lime7git/rc-piper-transmitter/Images/schematic/ffc-40pin.png

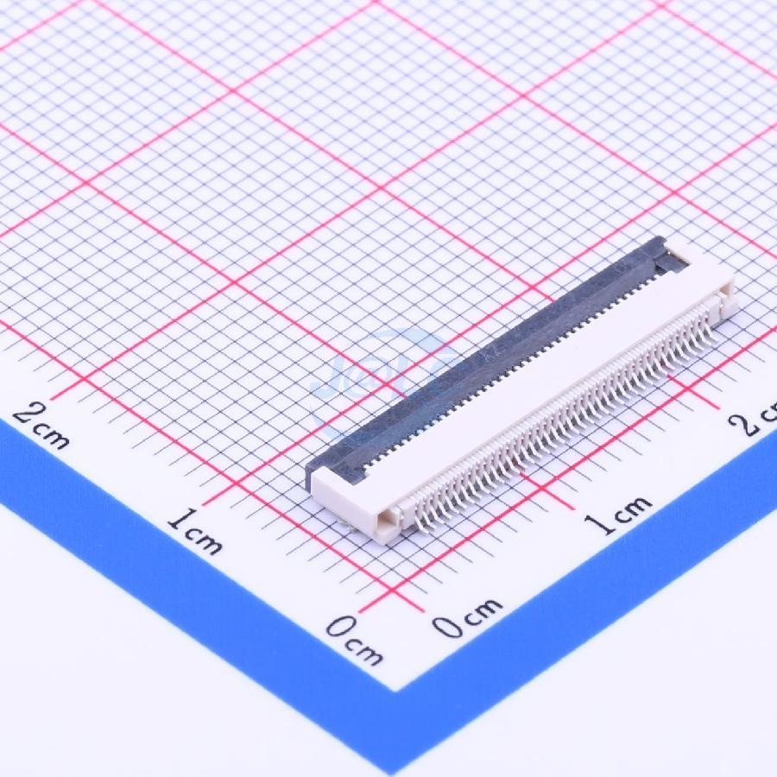
Images/schematic/ffc-40pin.png
