lime7git/rc-piper-transmitter/Images/schematic/toggle_sw1.jpeg

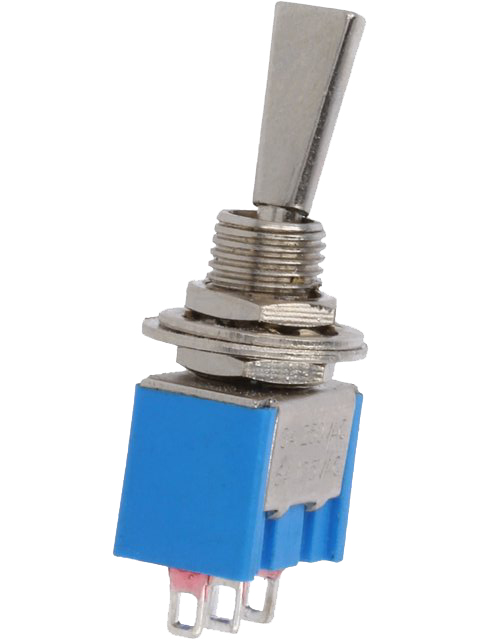
Images/schematic/toggle_sw1.jpeg
