lime7git/rc-piper-transmitter/Images/schematic/B3B-PH-K-S.jpg

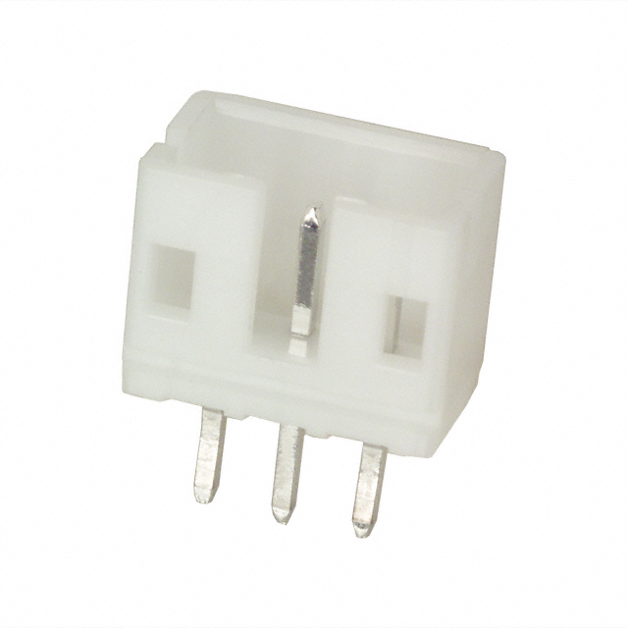
Images/schematic/B3B-PH-K-S.jpg
