lime7git/rc-piper-transmitter/Images/schematic/button1.jpg

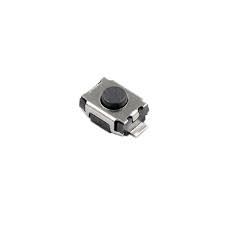
Images/schematic/button1.jpg
