lime7git/rc-piper-transmitter/Images/schematic/button2.jpg

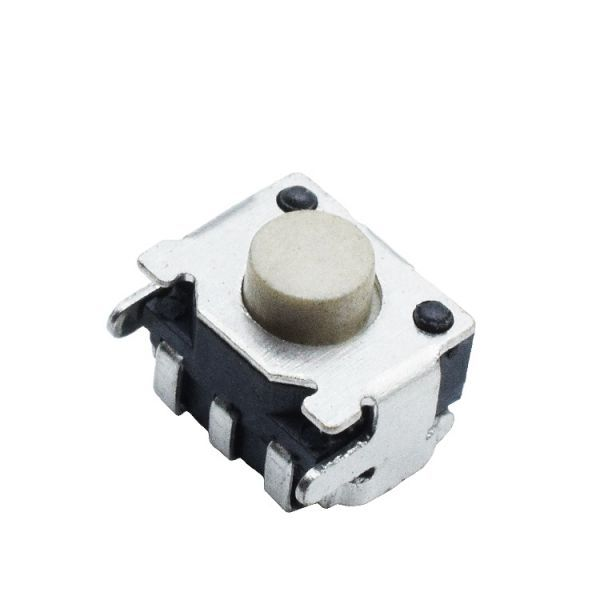
Images/schematic/button2.jpg
