lime7git/rc-piper-transmitter/Images/schematic/ffc-10pin.jpg

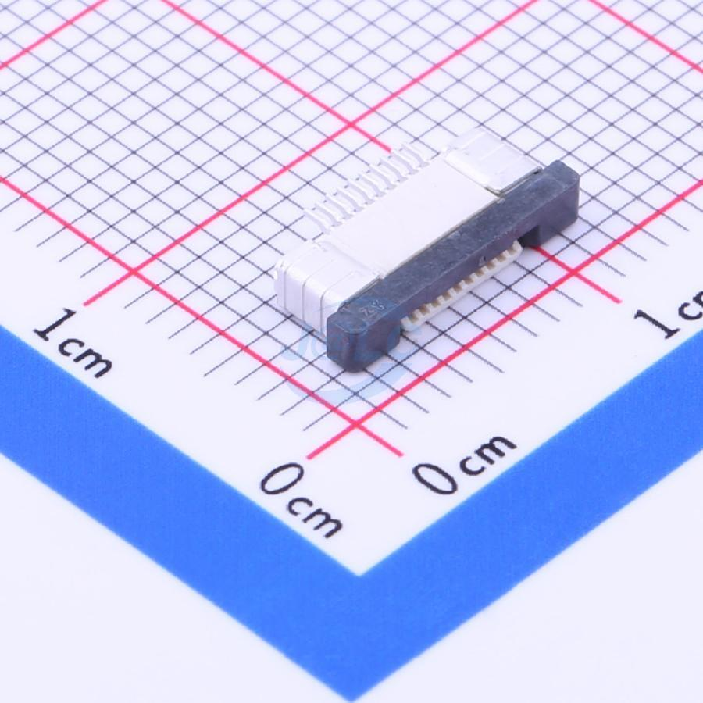
Images/schematic/ffc-10pin.jpg
