lime7git/rc-piper-transmitter/Images/schematic/joystick.jpg

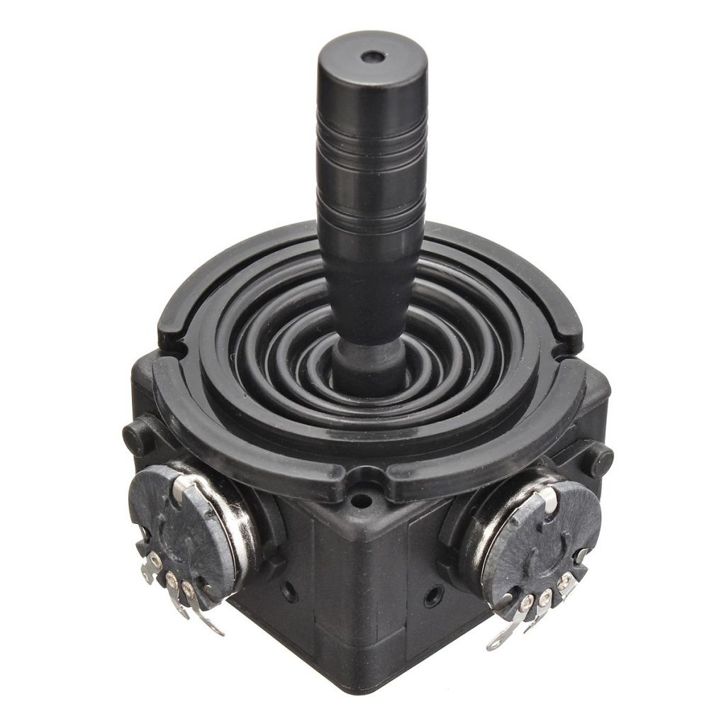
Images/schematic/joystick.jpg
