lime7git/rc-piper-transmitter/Images/schematic/li-pol-1cell.png

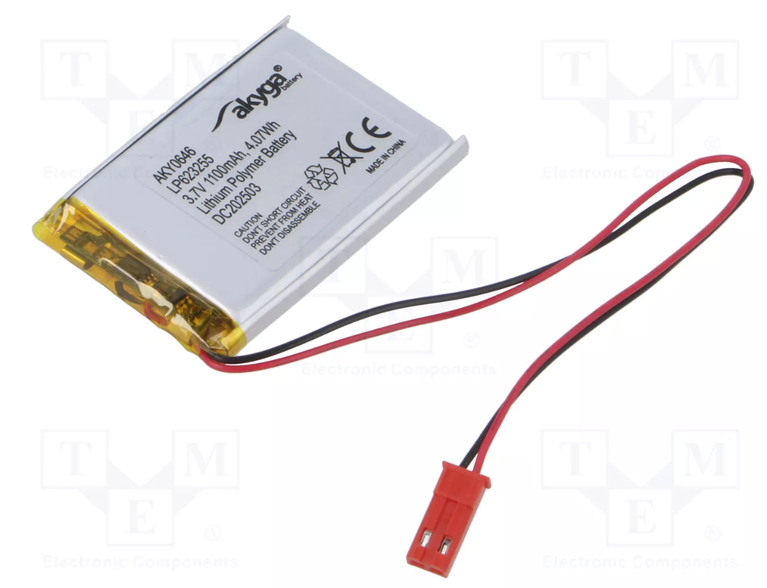
Images/schematic/li-pol-1cell.png
