lime7git/rc-piper-transmitter/Images/schematic/radio-transceiver.png

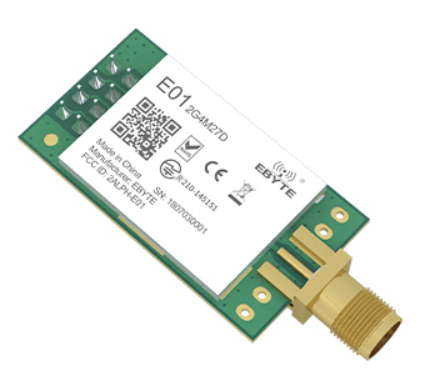
Images/schematic/radio-transceiver.png
