lime7git/rc-piper-transmitter/Images/schematic/sdcard.jpg

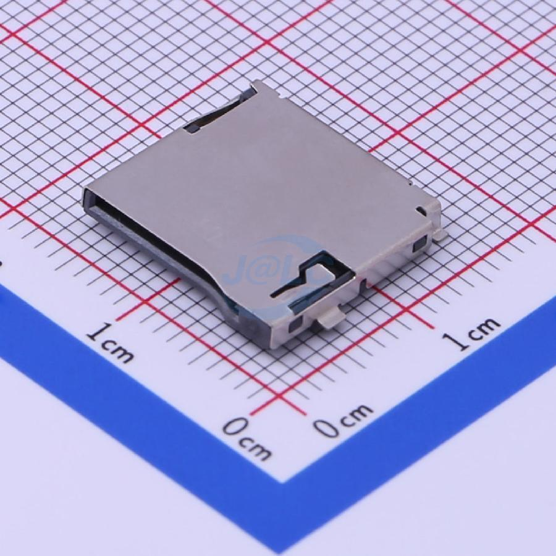
Images/schematic/sdcard.jpg
