lime7git/rc-piper-transmitter/transmitter.kicad_pcb

## KiCad design transmitter.kicad_pcb (2025-10-14)

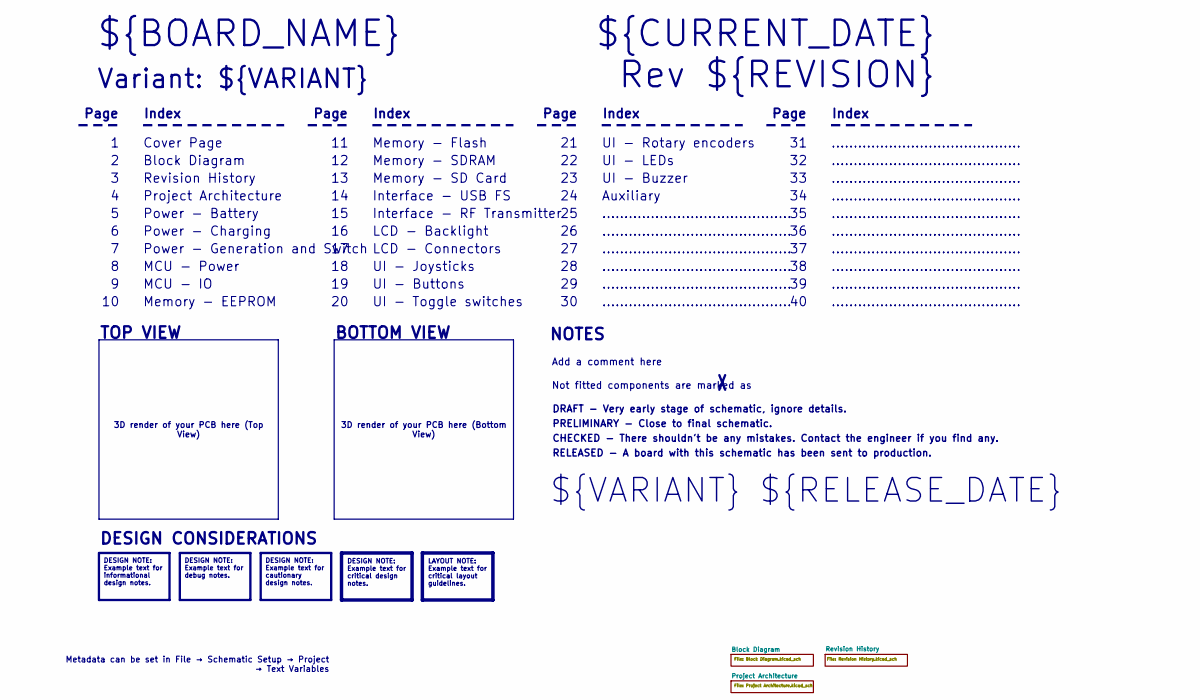
[picture p11: schematic transmitter.kicad_sch, Main]

Notes on the sheet:
BOTTOM VIEW
UI - Buzzer
RELEASED - A board with this schematic has been sent to production.
Page
TOP VIEW
Memory - EEPROM
MCU - IO
MCU - Power
LCD - Backlight
Not fitted components are marked as
...........................................
Index
Memory - SD Card
PRELIMINARY - Close to final schematic.
${VARIANT} ${RELEASE_DATE}
Project Architecture
${CURRENT_DATE}
Variant: ${VARIANT}
Rev ${REVISION}
Auxiliary
UI - LEDs
Power - Battery
UI - Buttons
Memory - Flash
LCD - Connectors
Interface - RF Transmitter
${BOARD_NAME}
DRAFT - Very early stage of schematic, ignore details.
Interface - USB FS
Power - Charging
Block Diagram
Add a comment here
UI - Joysticks
UI - Toggle switches
Cover Page
NOTES
Memory - SDRAM
Revision History
CHECKED - There shouldn't be any mistakes. Contact the engineer if you find any.
UI - Rotary encoders
DESIGN CONSIDERATIONS
Power - Generation and Switch
3D render of your PCB here (Bottom View)
3D render of your PCB here (Top View)
Metadata can be set in File → Schematic Setup → Project → Text Variables
DESIGN NOTE: Example text for informational design notes.
LAYOUT NOTE: Example text for critical layout guidelines.
DESIGN NOTE: Example text for cautionary design notes.
DESIGN NOTE: Example text for debug notes.
DESIGN NOTE: Example text for critical design notes.

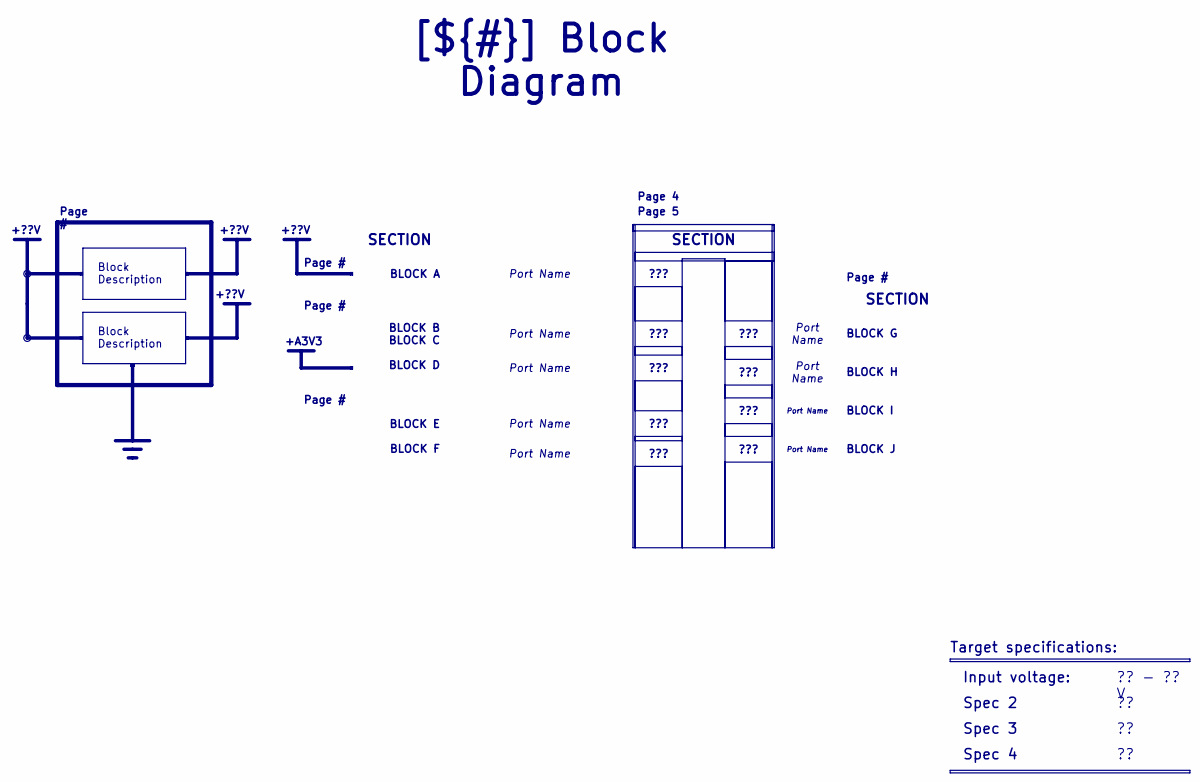
[picture p12: schematic Block Diagram.kicad_sch]

Notes on the sheet:
+??V
+A3V3
Spec 3
Block Description
???
Spec 2
Port Name
SECTION
Page #
Input voltage:
BLOCK E BLOCK F
BLOCK A
BLOCK I
BLOCK G
[${#}] ${TITLE}
Target specifications:
?? - ?? V
Page 4
BLOCK J
Page 5
BLOCK B BLOCK C BLOCK D
Spec 4
BLOCK H


Notes on the sheet:
- _________________________________ - _________________________________ - _________________________________ - _________________________________ - _________________________________ - _________________________________ - _________________________________ - _________________________________ - _________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
DD.MM.YYYY - xxx Revision Variant: xxx
[${#}] ${TITLE}

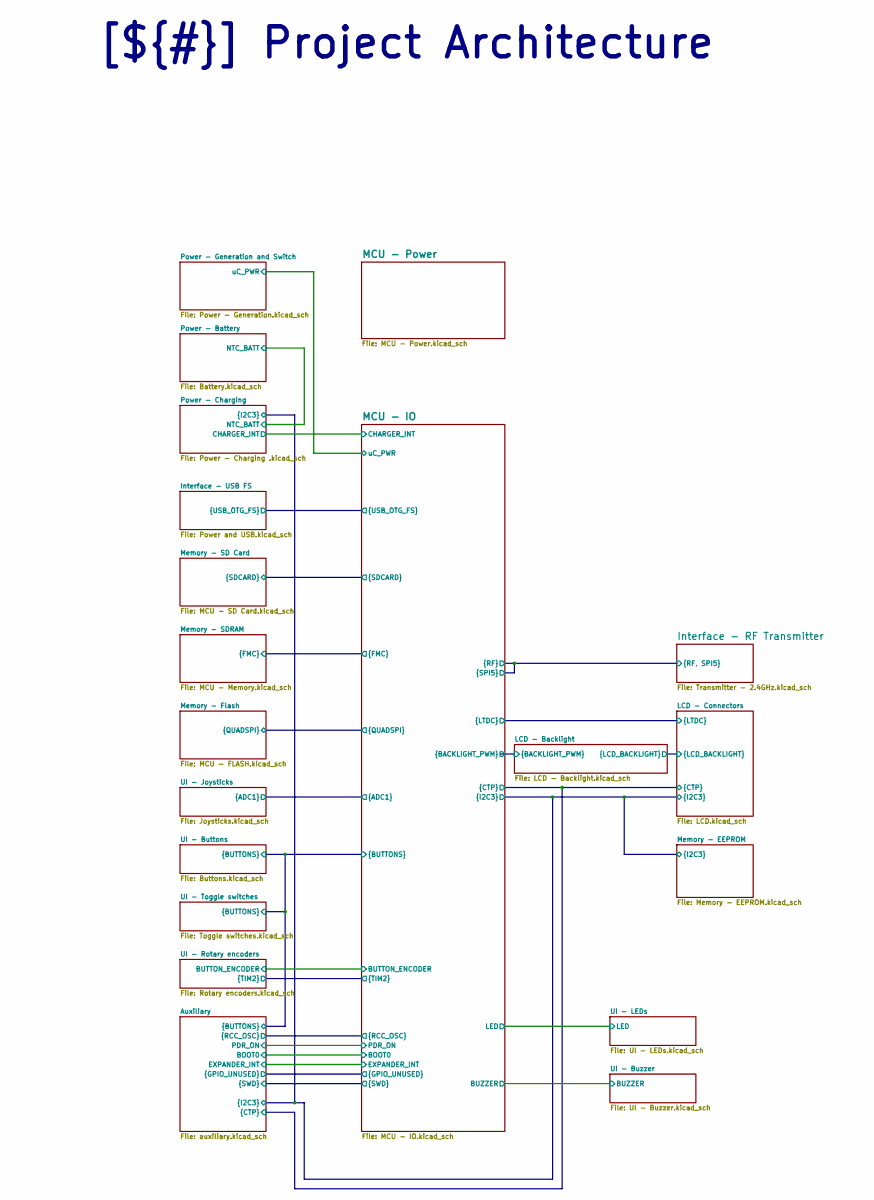
[picture p14: schematic Project Architecture.kicad_sch]

Notes on the sheet:
[${#}] ${TITLE}

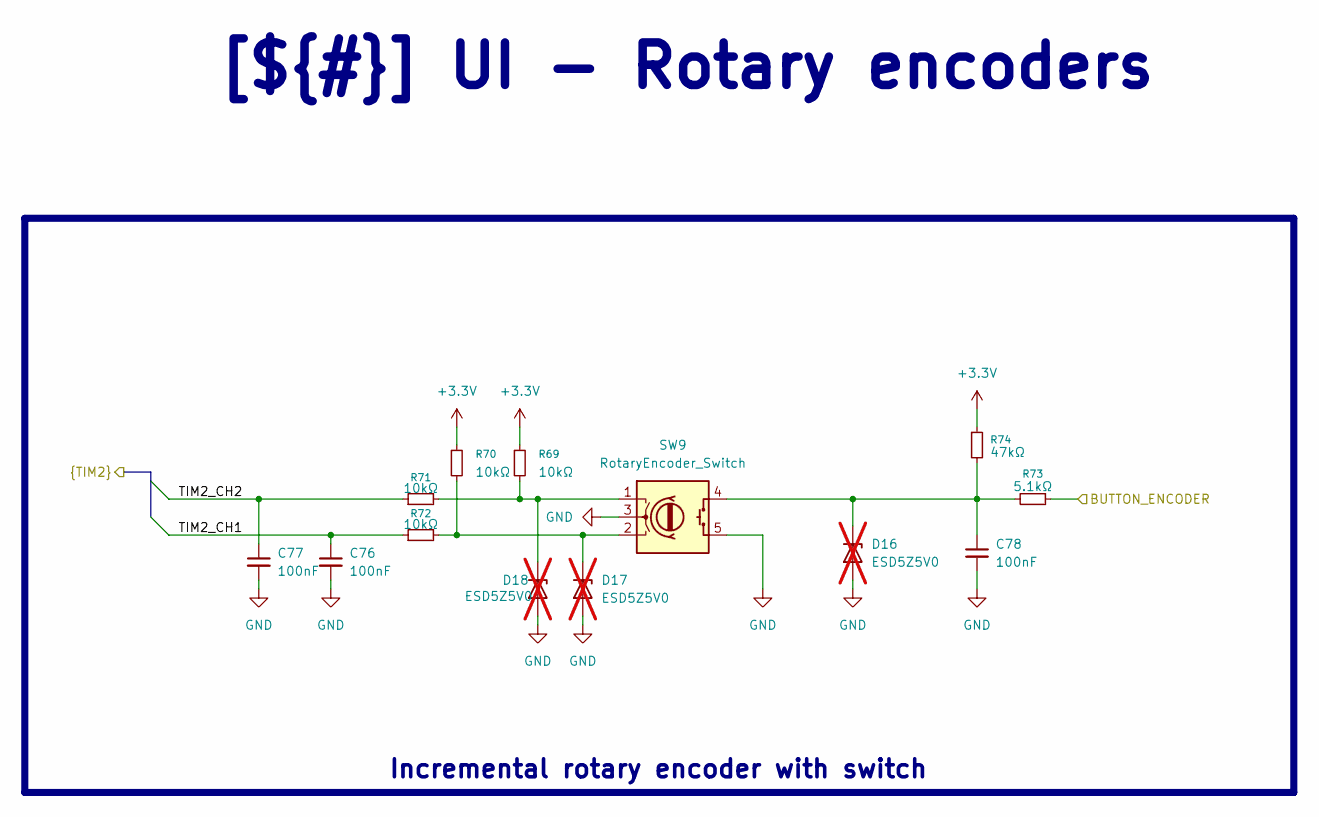
[picture p15: schematic Rotary encoders.kicad_sch, UI - Rotary encoders]

Parts:
C76, C77, C78: 100nF; C_0402_1005Metric
D16, D17, D18: ESD5Z5V0; D_SOD-523; not fitted
R69, R70, R71, R72: 10kΩ; R_0402_1005Metric
R73: 5.1kΩ; R_0402_1005Metric
R74: 47kΩ; R_0402_1005Metric
SW9: RotaryEncoder_Switch; JST_PH_B5B-PH-K_1x05_P2.00mm_Vertical

Connections:
+3.3V: R69.1, R70.1, R74.1; also elsewhere on the board
/Project Architecture/MCU - IO/ENC_BUTTON: R73.1; also elsewhere on the board
/Project Architecture/MCU - IO/TIM2_CH1: C76.1, R72.1; also elsewhere on the board
/Project Architecture/MCU - IO/TIM2_CH2: C77.1, R71.1; also elsewhere on the board
GND: C76.2, C77.2, C78.2, D16.2 (A), D17.2 (A), D18.2 (A), SW9.3, SW9.5; also elsewhere on the board
unnamed: C78.1, D16.1 (K), R73.2, R74.2, SW9.4
unnamed: D17.1 (K), R70.2, R72.2, SW9.2
unnamed: D18.1 (K), R69.2, R71.2, SW9.1

Notes on the sheet:
Incremental rotary encoder with switch
[${#}] ${TITLE}

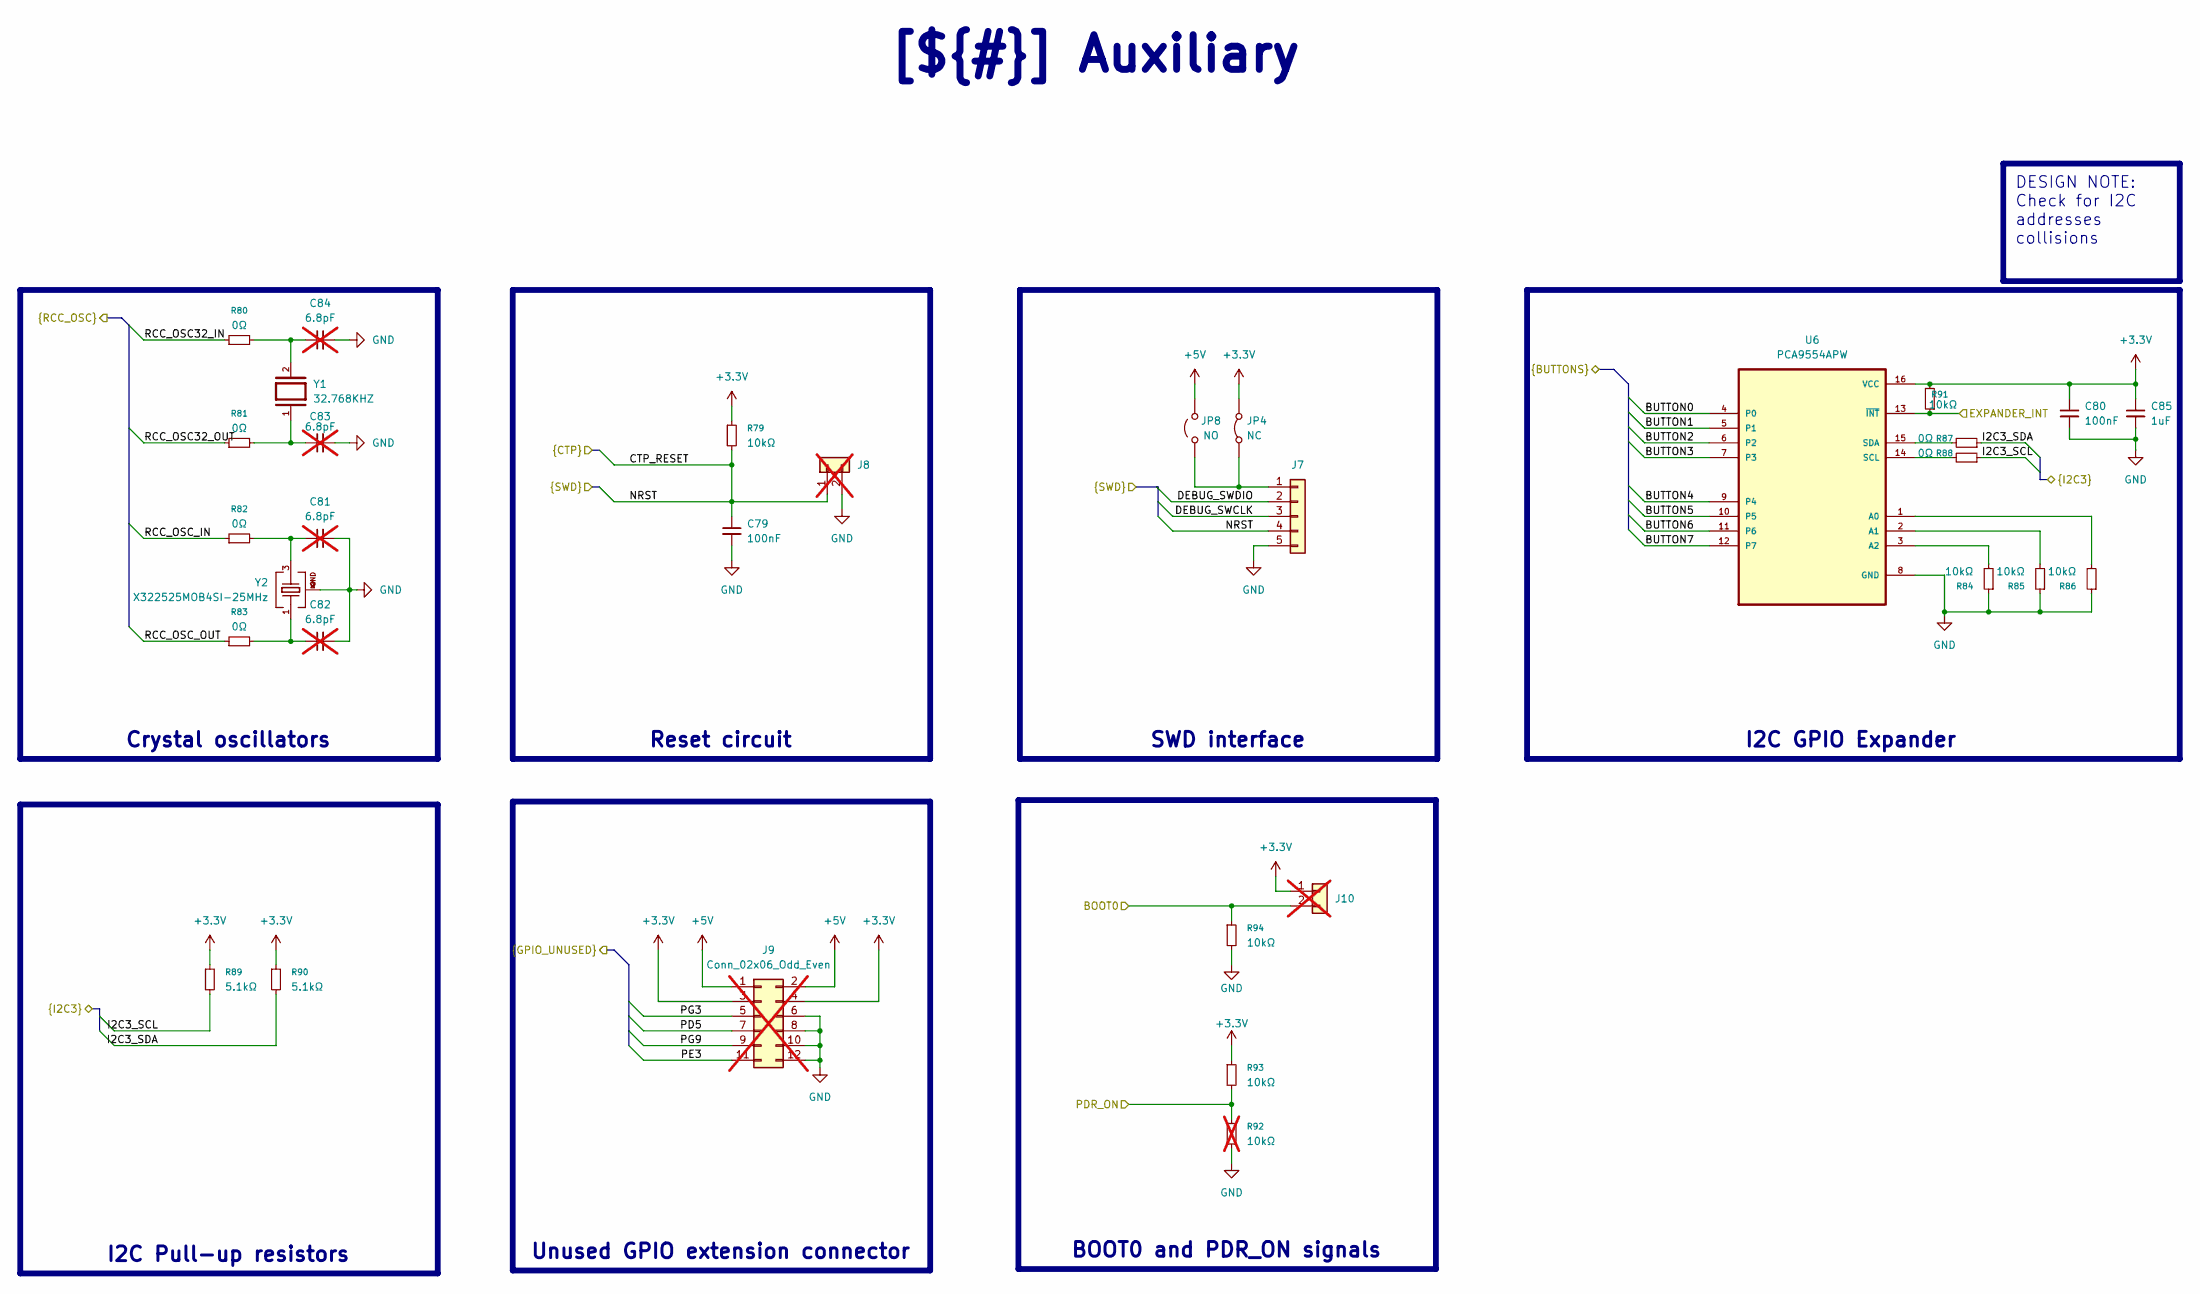
[picture p16: schematic auxiliary.kicad_sch]

Parts:
C79, C80: 100nF; C_0402_1005Metric
C81, C82, C83, C84: 6.8pF; C_0402_1005Metric; not fitted
C85: 1uF; C_0603_1608Metric
J7: Conn_01x05; JST_PH_B5B-PH-K_1x05_P2.00mm_Vertical
J8, J10: PinHeader_1x02_P2.00mm_Vertical; not fitted
J9: Conn_02x06_Odd_Even; PinSocket_2x06_P2.54mm_Vertical; not fitted
JP4: NC; SolderJumper-2_P1.3mm_Open_TrianglePad1.0x1.5mm
JP8: NO; SolderJumper-2_P1.3mm_Open_TrianglePad1.0x1.5mm
R79, R84, R85, R86, R91, R93, R94: 10kΩ; R_0402_1005Metric
R80, R81, R82, R83, R87, R88: 0Ω; R_0402_1005Metric
R89, R90: 5.1kΩ; R_0402_1005Metric
R92: 10kΩ; R_0402_1005Metric; not fitted
U6: PCA9554APW; SOP65P640X120-16N
Y1: 32.768KHZ; Q13FC13500004-32.768KHZ-4-T; PARTREV 08.19.15
Y2: X322525MOB4SI-25MHz; X322525MOB4SI 25MHz

Connections:
+3.3V: C80.1, C85.1, J9.3, J9.4, J10.1, JP4.2 (B), R79.1, R89.1, R90.1, R91.2, R93.1, U6.16 (VCC); also elsewhere on the board
+5V: J9.1, J9.2, JP8.1 (A); also elsewhere on the board
/Project Architecture/Auxiliary/BUTTON0: U6.4 (P0); also elsewhere on the board
/Project Architecture/Auxiliary/BUTTON1: U6.5 (P1); also elsewhere on the board
/Project Architecture/Auxiliary/BUTTON2: U6.6 (P2); also elsewhere on the board
/Project Architecture/Auxiliary/BUTTON3: U6.7 (P3); also elsewhere on the board
/Project Architecture/Auxiliary/BUTTON4: U6.9 (P4); also elsewhere on the board
/Project Architecture/Auxiliary/BUTTON5: U6.10 (P5); also elsewhere on the board
/Project Architecture/Auxiliary/BUTTON6: U6.11 (P6); also elsewhere on the board
/Project Architecture/Auxiliary/BUTTON7: U6.12 (P7); also elsewhere on the board
/Project Architecture/Auxiliary/DEBUG_SWCLK: J7.3; also elsewhere on the board
/Project Architecture/Auxiliary/DEBUG_SWDIO: J7.2; also elsewhere on the board
/Project Architecture/Auxiliary/I2C3_SCL: R88.1, R89.2; also elsewhere on the board
/Project Architecture/Auxiliary/I2C3_SDA: R87.1, R90.2; also elsewhere on the board
/Project Architecture/Auxiliary/NRST: C79.1, J7.4, J8.1, R79.2; also elsewhere on the board
/Project Architecture/Auxiliary/PD5: J9.7; also elsewhere on the board
/Project Architecture/Auxiliary/PE3: J9.11; also elsewhere on the board
/Project Architecture/Auxiliary/PG3: J9.5; also elsewhere on the board
/Project Architecture/Auxiliary/PG9: J9.9; also elsewhere on the board
/Project Architecture/Auxiliary/RCC_OSC32_IN: R80.1; also elsewhere on the board
/Project Architecture/Auxiliary/RCC_OSC32_OUT: R81.1; also elsewhere on the board
/Project Architecture/Auxiliary/RCC_OSC_IN: R82.1; also elsewhere on the board
/Project Architecture/Auxiliary/RCC_OSC_OUT: R83.1; also elsewhere on the board
/Project Architecture/MCU - IO/BOOT0: J10.2, R94.1; also elsewhere on the board
/Project Architecture/MCU - IO/EXPANDER_INT: R91.1, U6.13 (~INT); also elsewhere on the board
/Project Architecture/MCU - IO/PDR_ON: R92.1, R93.2; also elsewhere on the board
GND: C79.2, C80.2, C81.2, C82.2, C83.2, C84.2, C85.2, J7.5, J8.2, J9.6, J9.8, J9.10, J9.12, R84.1, R85.1, R86.1, R92.2, R94.2, U6.8 (GND), Y2.2, Y2.4; also elsewhere on the board
unnamed: C81.1, R82.2, Y2.3
unnamed: C82.1, R83.2, Y2.1
unnamed: C83.1, R81.2, Y1.1
unnamed: C84.1, R80.2, Y1.2
unnamed: J7.1, JP4.1 (A), JP8.2 (B)
unnamed: R86.2, U6.1 (A0)
unnamed: R85.2, U6.2 (A1)
unnamed: R84.2, U6.3 (A2)
unnamed: R88.2, U6.14 (SCL)
unnamed: R87.2, U6.15 (SDA)

Notes on the sheet:
Reset circuit
[${#}] ${TITLE}
BOOT0 and PDR_ON signals
I2C GPIO Expander
DESIGN NOTE: Check for I2C addresses collisions
I2C Pull-up resistors
Crystal oscillators
SWD interface
Unused GPIO extension connector

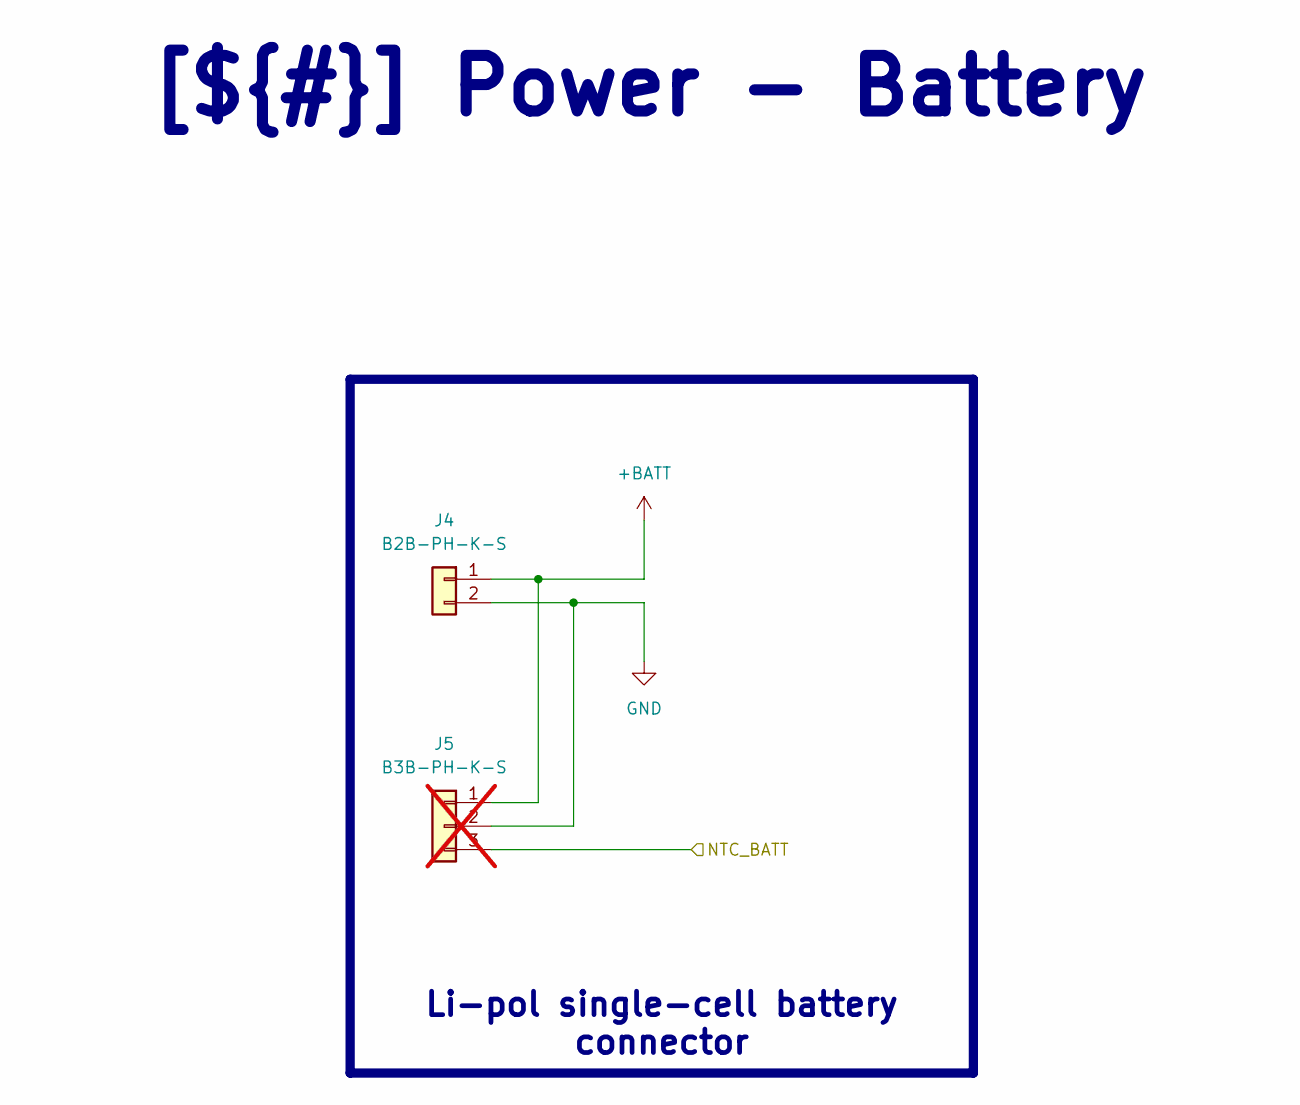
[picture p17: schematic Battery.kicad_sch, Power - Battery]

Parts:
J4: B2B-PH-K-S; JST_PH_B2B-PH-K_1x02_P2.00mm_Vertical
J5: B3B-PH-K-S; JST_PH_B3B-PH-K_1x03_P2.00mm_Vertical; not fitted

Connections:
+BATT: J4.1, J5.1; also elsewhere on the board
/Project Architecture/Power - Battery/NTC_BATT: J5.3 (Pin_2); also elsewhere on the board
GND: J4.2, J5.2; also elsewhere on the board

Notes on the sheet:
Li-pol single-cell battery connector
[${#}] ${TITLE}

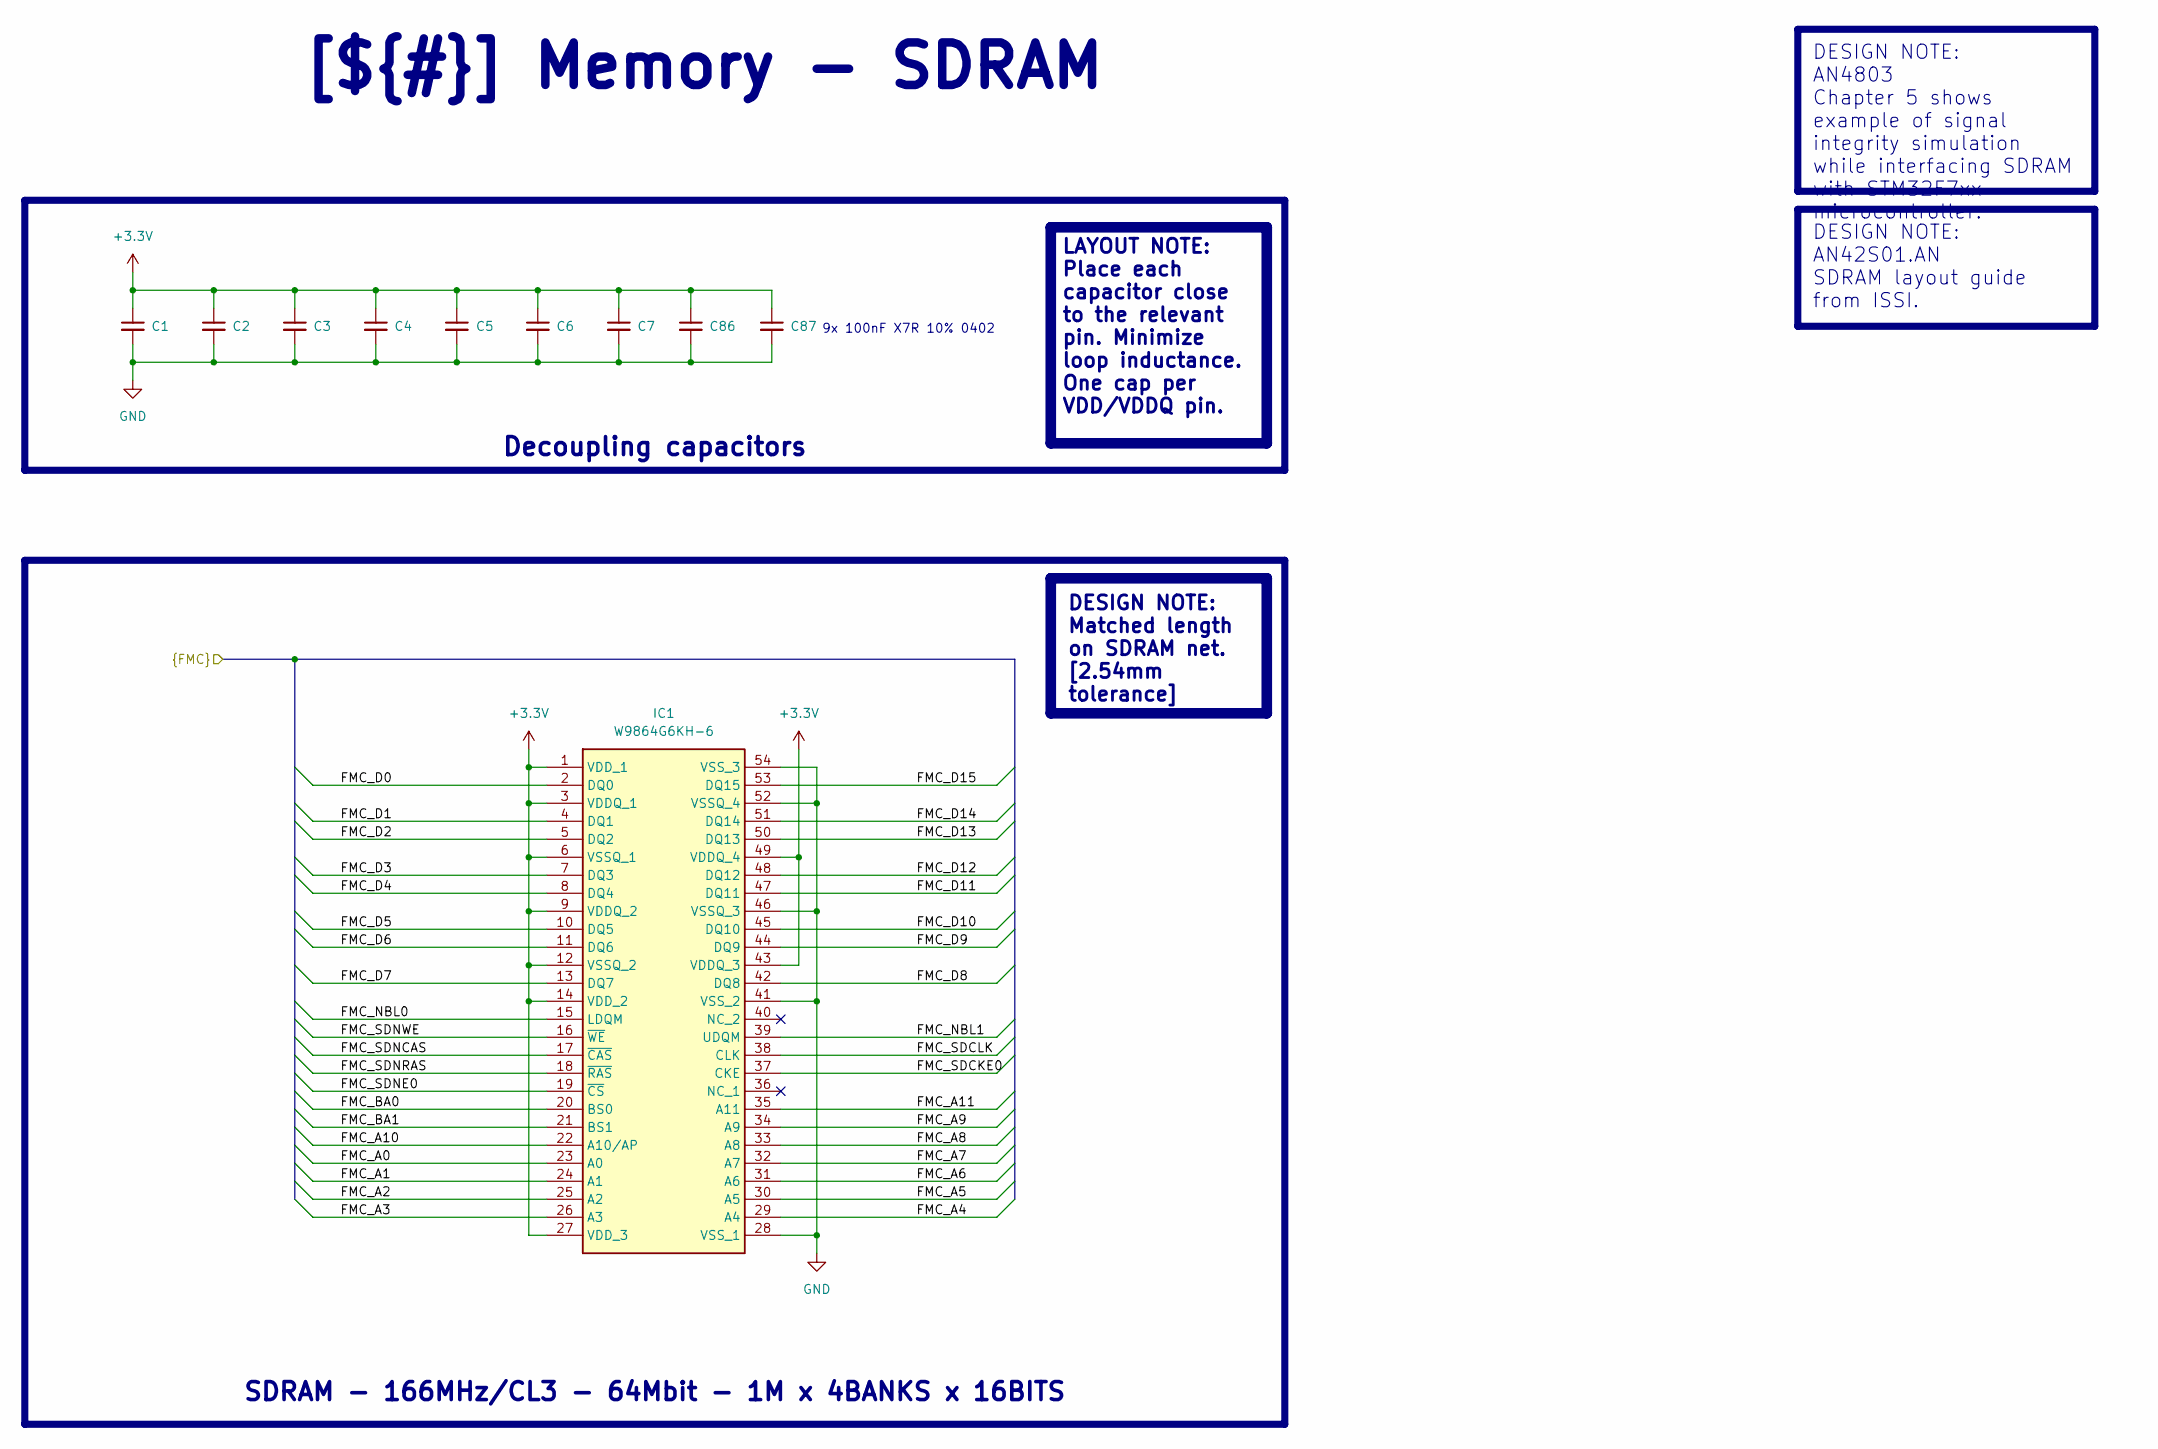
[picture p18: schematic MCU - Memory.kicad_sch, Memory - SDRAM]

Parts:
C1, C2, C3, C4, C5, C6, C7, C86, C87: 100nF; C_0402_1005Metric
IC1: W9864G6KH-6; SOP80P1176X120-54N; Mouser Part Number 454-W9864G6KH-6

Connections:
+3.3V: C1.1, C2.1, C3.1, C4.1, C5.1, C6.1, C7.1, C86.1, C87.1, IC1.1 (VDD_1), IC1.3 (VDDQ_1), IC1.6 (VSSQ_1), IC1.9 (VDDQ_2), IC1.12 (VSSQ_2), IC1.14 (VDD_2), IC1.27 (VDD_3), IC1.43 (VDDQ_3), IC1.49 (VDDQ_4); also elsewhere on the board
/Project Architecture/MCU - IO/FMC_A0: IC1.23 (A0); also elsewhere on the board
/Project Architecture/MCU - IO/FMC_A1: IC1.24 (A1); also elsewhere on the board
/Project Architecture/MCU - IO/FMC_A2: IC1.25 (A2); also elsewhere on the board
/Project Architecture/MCU - IO/FMC_A3: IC1.26 (A3); also elsewhere on the board
/Project Architecture/MCU - IO/FMC_A4: IC1.29 (A4); also elsewhere on the board
/Project Architecture/MCU - IO/FMC_A5: IC1.30 (A5); also elsewhere on the board
/Project Architecture/MCU - IO/FMC_A6: IC1.31 (A6); also elsewhere on the board
/Project Architecture/MCU - IO/FMC_A7: IC1.32 (A7); also elsewhere on the board
/Project Architecture/MCU - IO/FMC_A8: IC1.33 (A8); also elsewhere on the board
/Project Architecture/MCU - IO/FMC_A9: IC1.34 (A9); also elsewhere on the board
/Project Architecture/MCU - IO/FMC_A10: IC1.22 (A10/AP); also elsewhere on the board
/Project Architecture/MCU - IO/FMC_A11: IC1.35 (A11); also elsewhere on the board
/Project Architecture/MCU - IO/FMC_BA0: IC1.20 (BS0); also elsewhere on the board
/Project Architecture/MCU - IO/FMC_BA1: IC1.21 (BS1); also elsewhere on the board
/Project Architecture/MCU - IO/FMC_D0: IC1.2 (DQ0); also elsewhere on the board
/Project Architecture/MCU - IO/FMC_D1: IC1.4 (DQ1); also elsewhere on the board
/Project Architecture/MCU - IO/FMC_D2: IC1.5 (DQ2); also elsewhere on the board
/Project Architecture/MCU - IO/FMC_D3: IC1.7 (DQ3); also elsewhere on the board
/Project Architecture/MCU - IO/FMC_D4: IC1.8 (DQ4); also elsewhere on the board
/Project Architecture/MCU - IO/FMC_D5: IC1.10 (DQ5); also elsewhere on the board
/Project Architecture/MCU - IO/FMC_D6: IC1.11 (DQ6); also elsewhere on the board
/Project Architecture/MCU - IO/FMC_D7: IC1.13 (DQ7); also elsewhere on the board
/Project Architecture/MCU - IO/FMC_D8: IC1.42 (DQ8); also elsewhere on the board
/Project Architecture/MCU - IO/FMC_D9: IC1.44 (DQ9); also elsewhere on the board
/Project Architecture/MCU - IO/FMC_D10: IC1.45 (DQ10); also elsewhere on the board
/Project Architecture/MCU - IO/FMC_D11: IC1.47 (DQ11); also elsewhere on the board
/Project Architecture/MCU - IO/FMC_D12: IC1.48 (DQ12); also elsewhere on the board
/Project Architecture/MCU - IO/FMC_D13: IC1.50 (DQ13); also elsewhere on the board
/Project Architecture/MCU - IO/FMC_D14: IC1.51 (DQ14); also elsewhere on the board
/Project Architecture/MCU - IO/FMC_D15: IC1.53 (DQ15); also elsewhere on the board
/Project Architecture/MCU - IO/FMC_NBL0: IC1.15 (LDQM); also elsewhere on the board
/Project Architecture/MCU - IO/FMC_NBL1: IC1.39 (UDQM); also elsewhere on the board
/Project Architecture/MCU - IO/FMC_SDCKE0: IC1.37 (CKE); also elsewhere on the board
/Project Architecture/MCU - IO/FMC_SDCLK: IC1.38 (CLK); also elsewhere on the board
/Project Architecture/MCU - IO/FMC_SDNCAS: IC1.17 (~CAS); also elsewhere on the board
/Project Architecture/MCU - IO/FMC_SDNE0: IC1.19 (~CS); also elsewhere on the board
/Project Architecture/MCU - IO/FMC_SDNRAS: IC1.18 (~RAS); also elsewhere on the board
/Project Architecture/MCU - IO/FMC_SDNWE: IC1.16 (~WE); also elsewhere on the board
GND: C1.2, C2.2, C3.2, C4.2, C5.2, C6.2, C7.2, C86.2, C87.2, IC1.28 (VSS_1), IC1.41 (VSS_2), IC1.46 (VSSQ_3), IC1.52 (VSSQ_4), IC1.54 (VSS_3); also elsewhere on the board

Notes on the sheet:
9x 100nF X7R 10% 0402
DESIGN NOTE: Matched length on SDRAM net. [2.54mm tolerance]
SDRAM - 166MHz/CL3 - 64Mbit - 1M x 4BANKS x 16BITS
[${#}] ${TITLE}
DESIGN NOTE: AN4803 Chapter 5 shows example of signal integrity simulation while interfacing SDRAM with STM32F7xx microcontroller.
LAYOUT NOTE: Place each capacitor close to the relevant pin. Minimize loop inductance. One cap per VDD/VDDQ pin.
DESIGN NOTE: AN42S01.AN SDRAM layout guide from ISSI.
Decoupling capacitors

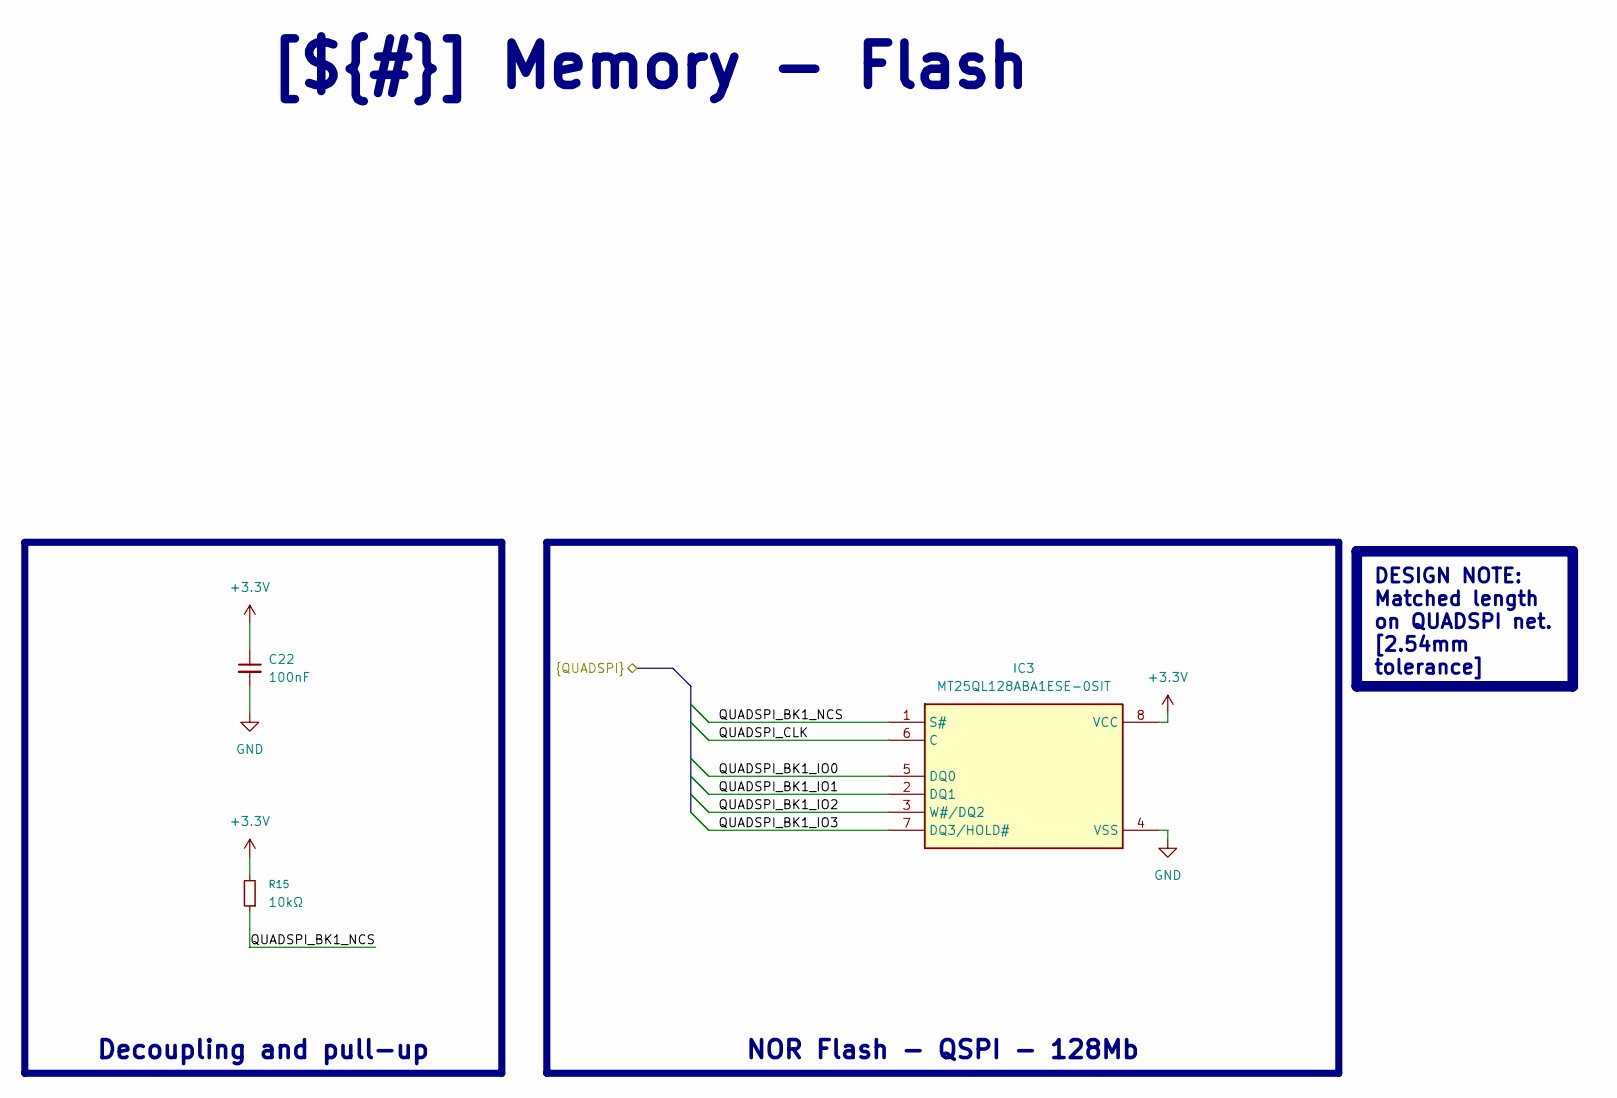
[picture p19: schematic MCU - FLASH.kicad_sch, Memory - Flash]

Parts:
C22: 100nF; C_0402_1005Metric
IC3: MT25QL128ABA1ESE-0SIT; SOIC127P790X216-8L; Mouser Part Number 340-224871-TRAY
R15: 10kΩ; R_0402_1005Metric

Connections:
+3.3V: C22.1, IC3.8 (VCC), R15.2; also elsewhere on the board
/Project Architecture/MCU - IO/QUADSPI_BK1_IO0: IC3.5 (DQ0); also elsewhere on the board
/Project Architecture/MCU - IO/QUADSPI_BK1_IO1: IC3.2 (DQ1); also elsewhere on the board
/Project Architecture/MCU - IO/QUADSPI_BK1_IO2: IC3.3 (W#/DQ2); also elsewhere on the board
/Project Architecture/MCU - IO/QUADSPI_BK1_IO3: IC3.7 (DQ3/HOLD#); also elsewhere on the board
/Project Architecture/MCU - IO/QUADSPI_BK1_NCS: IC3.1 (S#), R15.1; also elsewhere on the board
/Project Architecture/MCU - IO/QUADSPI_CLK: IC3.6 (C); also elsewhere on the board
GND: C22.2, IC3.4 (VSS); also elsewhere on the board

Notes on the sheet:
NOR Flash - QSPI - 128Mb
DESIGN NOTE: Matched length on QUADSPI net. [2.54mm tolerance]
Decoupling and pull-up
[${#}] ${TITLE}
