lime7git/rc-piper-transmitter/transmitter.kicad_pcb

## KiCad design transmitter.kicad_pcb (continued)

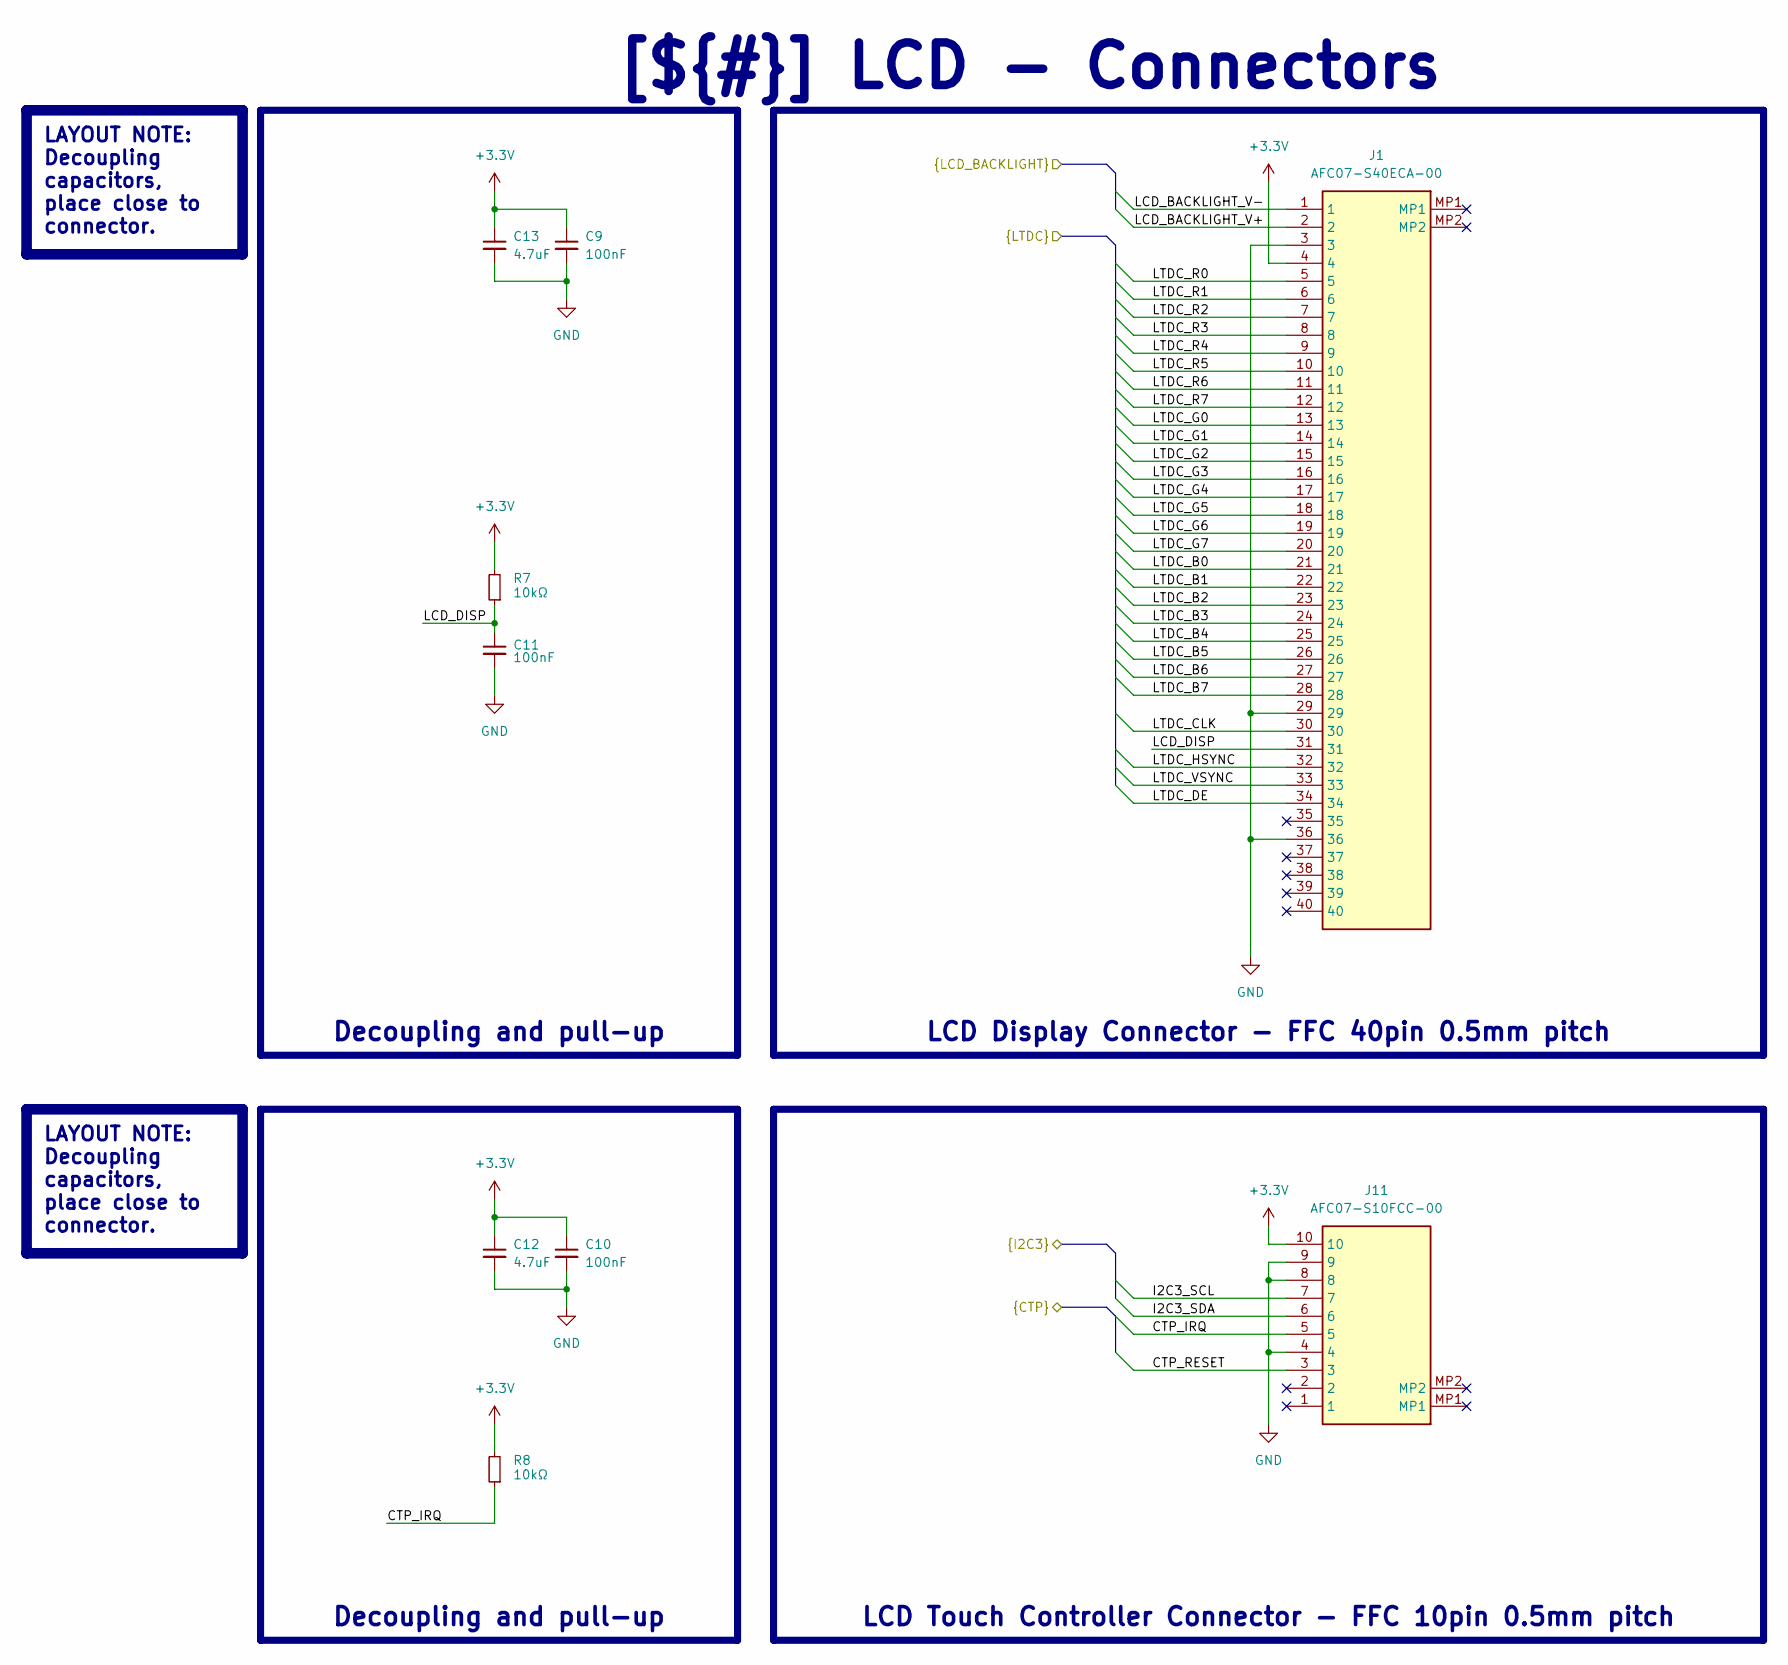
[picture p20: schematic LCD.kicad_sch, LCD - Connectors]

Parts:
C9, C10, C11: 100nF; C_0402_1005Metric
C12, C13: 4.7uF; C_0805_2012Metric
J1: AFC07-S40ECA-00; Manufacturer_Part_Number AFC07-S40ECA-00
J11: AFC07-S10FCC-00; AFC07S10ECC00; Manufacturer_Part_Number AFC07-S10FCC-00
R7, R8: 10kΩ; R_0402_1005Metric

Connections:
+3.3V: C9.1, C10.1, C12.1, C13.1, J1.4, J11.10, R7.2, R8.2; also elsewhere on the board
/Project Architecture/Auxiliary/CTP_IRQ: J11.5, R8.1
/Project Architecture/Auxiliary/I2C3_SCL: J11.7; also elsewhere on the board
/Project Architecture/Auxiliary/I2C3_SDA: J11.6; also elsewhere on the board
/Project Architecture/Auxiliary/NRST: J11.3; also elsewhere on the board
/Project Architecture/LCD - Backlight/LCD_BACKLIGHT_V+: J1.2; also elsewhere on the board
/Project Architecture/LCD - Backlight/LCD_BACKLIGHT_V-: J1.1; also elsewhere on the board
/Project Architecture/LCD - Connectors/LCD_DISP: C11.1, J1.31, R7.1
/Project Architecture/LCD - Connectors/LTDC_B0: J1.21; also elsewhere on the board
/Project Architecture/LCD - Connectors/LTDC_B1: J1.22; also elsewhere on the board
/Project Architecture/LCD - Connectors/LTDC_B2: J1.23; also elsewhere on the board
/Project Architecture/LCD - Connectors/LTDC_B3: J1.24; also elsewhere on the board
/Project Architecture/LCD - Connectors/LTDC_B4: J1.25; also elsewhere on the board
/Project Architecture/LCD - Connectors/LTDC_B5: J1.26; also elsewhere on the board
/Project Architecture/LCD - Connectors/LTDC_B6: J1.27; also elsewhere on the board
/Project Architecture/LCD - Connectors/LTDC_B7: J1.28; also elsewhere on the board
/Project Architecture/LCD - Connectors/LTDC_CLK: J1.30; also elsewhere on the board
/Project Architecture/LCD - Connectors/LTDC_DE: J1.34; also elsewhere on the board
/Project Architecture/LCD - Connectors/LTDC_G0: J1.13; also elsewhere on the board
/Project Architecture/LCD - Connectors/LTDC_G1: J1.14; also elsewhere on the board
/Project Architecture/LCD - Connectors/LTDC_G2: J1.15; also elsewhere on the board
/Project Architecture/LCD - Connectors/LTDC_G3: J1.16; also elsewhere on the board
/Project Architecture/LCD - Connectors/LTDC_G4: J1.17; also elsewhere on the board
/Project Architecture/LCD - Connectors/LTDC_G5: J1.18; also elsewhere on the board
/Project Architecture/LCD - Connectors/LTDC_G6: J1.19; also elsewhere on the board
/Project Architecture/LCD - Connectors/LTDC_G7: J1.20; also elsewhere on the board
/Project Architecture/LCD - Connectors/LTDC_HSYNC: J1.32; also elsewhere on the board
/Project Architecture/LCD - Connectors/LTDC_R0: J1.5; also elsewhere on the board
/Project Architecture/LCD - Connectors/LTDC_R1: J1.6; also elsewhere on the board
/Project Architecture/LCD - Connectors/LTDC_R2: J1.7; also elsewhere on the board
/Project Architecture/LCD - Connectors/LTDC_R3: J1.8; also elsewhere on the board
/Project Architecture/LCD - Connectors/LTDC_R4: J1.9; also elsewhere on the board
/Project Architecture/LCD - Connectors/LTDC_R5: J1.10; also elsewhere on the board
/Project Architecture/LCD - Connectors/LTDC_R6: J1.11; also elsewhere on the board
/Project Architecture/LCD - Connectors/LTDC_R7: J1.12; also elsewhere on the board
/Project Architecture/LCD - Connectors/LTDC_VSYNC: J1.33; also elsewhere on the board
GND: C9.2, C10.2, C11.2, C12.2, C13.2, J1.3, J1.29, J1.36, J11.4, J11.8, J11.9; also elsewhere on the board

Notes on the sheet:
Decoupling and pull-up
LAYOUT NOTE: Decoupling capacitors, place close to connector.
LCD Touch Controller Connector - FFC 10pin 0.5mm pitch
[${#}] ${TITLE}
LCD Display Connector - FFC 40pin 0.5mm pitch
Decoupling and pull-up

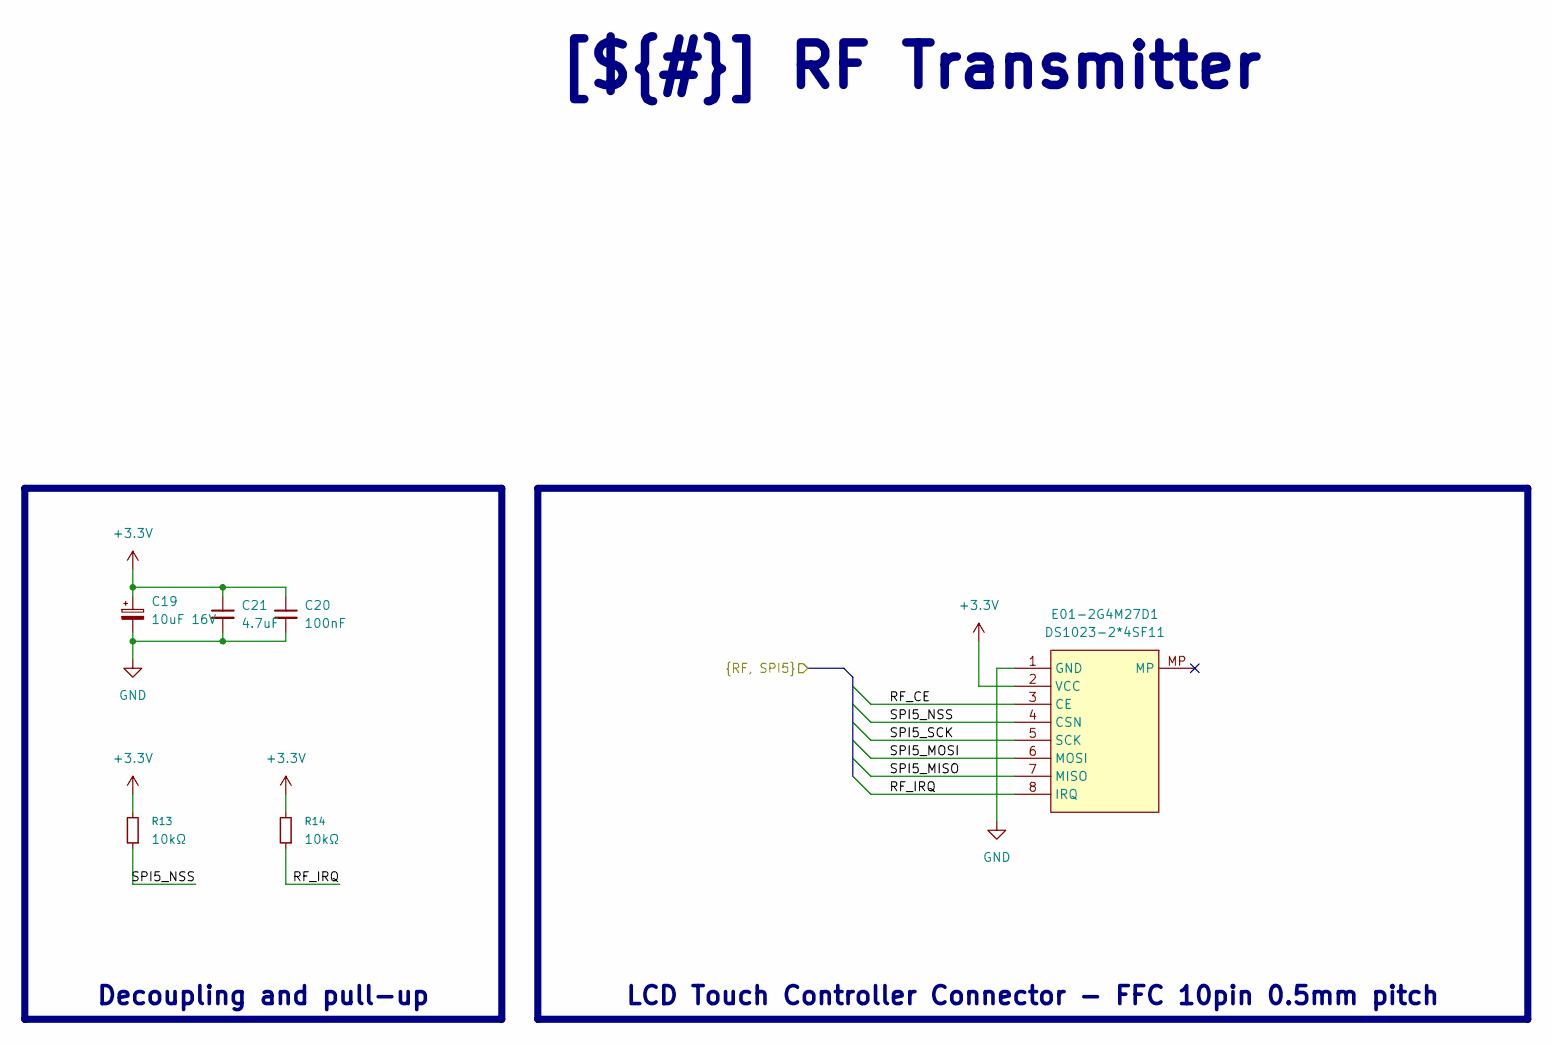
[picture p21: schematic Transmitter - 2.4GHz.kicad_sch, RF Transmitter]

Parts:
C19: 10uF 16V; CP_EIA-3216-18_Kemet-A
C20: 100nF; C_0402_1005Metric
C21: 4.7uF; C_0805_2012Metric
E01-2G4M27D1: DS1023-2*4SF11; PE01-ML01DP5; Manufacturer_Part_Number DS1023-2*4SF11
R13, R14: 10kΩ; R_0402_1005Metric

Connections:
+3.3V: C19.1, C20.1, C21.1, E01-2G4M27D1.2 (VCC), R13.2, R14.2; also elsewhere on the board
/Project Architecture/Interface - RF Transmitter/RF_CE: E01-2G4M27D1.3 (CE); also elsewhere on the board
/Project Architecture/Interface - RF Transmitter/RF_IRQ: E01-2G4M27D1.8 (IRQ), R14.1; also elsewhere on the board
/Project Architecture/Interface - RF Transmitter/SPI5_MISO: E01-2G4M27D1.7 (MISO); also elsewhere on the board
/Project Architecture/Interface - RF Transmitter/SPI5_MOSI: E01-2G4M27D1.6 (MOSI); also elsewhere on the board
/Project Architecture/Interface - RF Transmitter/SPI5_NSS: E01-2G4M27D1.4 (CSN), R13.1; also elsewhere on the board
/Project Architecture/Interface - RF Transmitter/SPI5_SCK: E01-2G4M27D1.5 (SCK); also elsewhere on the board
GND: C19.2, C20.2, C21.2, E01-2G4M27D1.1 (GND); also elsewhere on the board

Notes on the sheet:
Decoupling and pull-up
[${#}] ${TITLE}
LCD Touch Controller Connector - FFC 10pin 0.5mm pitch

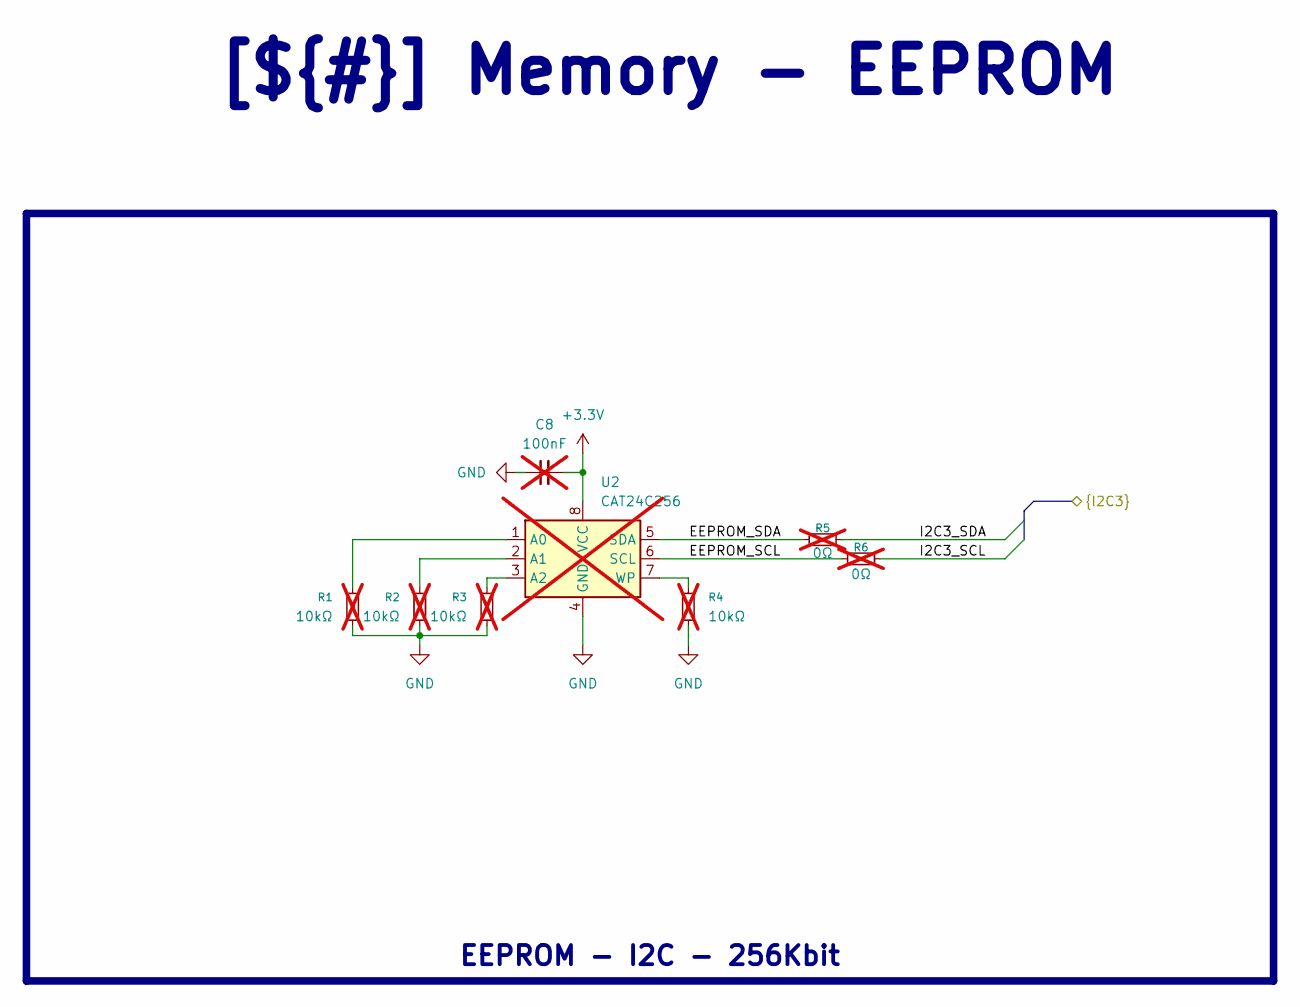
[picture p22: schematic Memory - EEPROM.kicad_sch]

Parts:
C8: 100nF; C_0402_1005Metric; not fitted
R1, R2, R3, R4: 10kΩ; R_0402_1005Metric; not fitted
R5, R6: 0Ω; R_0402_1005Metric; not fitted
U2: CAT24C256; SOIC-8_5.3x6.2mm_P1.27mm; not fitted

Connections:
+3.3V: C8.2, U2.8 (VCC); also elsewhere on the board
/Project Architecture/Auxiliary/I2C3_SCL: R6.2; also elsewhere on the board
/Project Architecture/Auxiliary/I2C3_SDA: R5.2; also elsewhere on the board
/Project Architecture/Memory - EEPROM/EEPROM_SCL: R6.1, U2.6 (SCL)
/Project Architecture/Memory - EEPROM/EEPROM_SDA: R5.1, U2.5 (SDA)
GND: C8.1, R1.2, R2.2, R3.2, R4.2, U2.4 (GND); also elsewhere on the board
unnamed: R1.1, U2.1 (A0)
unnamed: R2.1, U2.2 (A1)
unnamed: R3.1, U2.3 (A2)
unnamed: R4.1, U2.7 (WP)

Notes on the sheet:
EEPROM - I2C - 256Kbit
[${#}] ${TITLE}

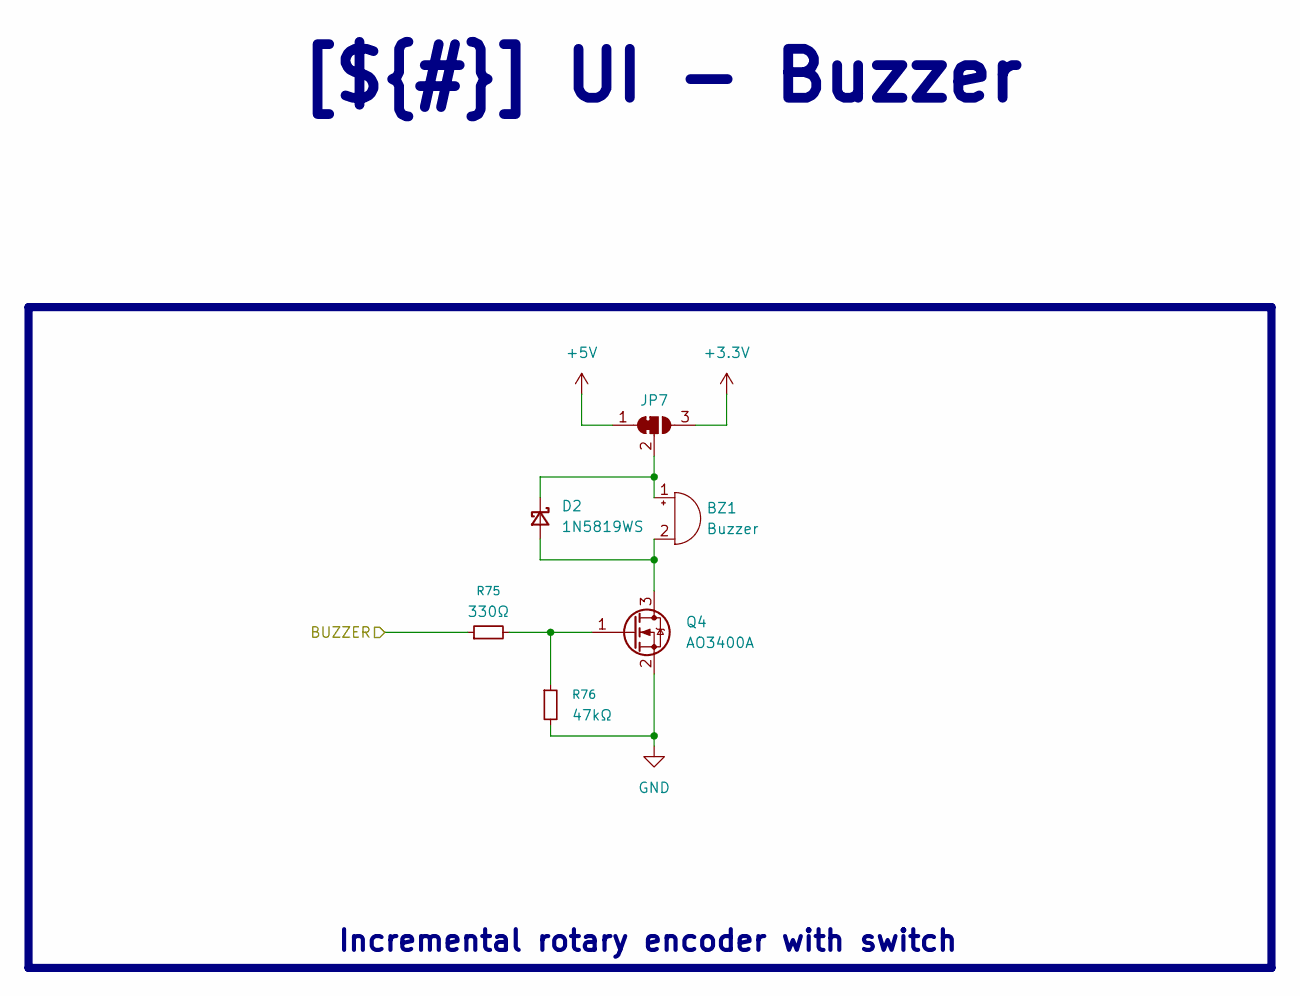
[picture p23: schematic UI - Buzzer.kicad_sch]

Parts:
BZ1: Buzzer; Buzzer_TDK_PS1240P02BT_D12.2mm_H6.5mm
D2: 1N5819WS; D_SOD-323
JP7: SolderJumper_3_Bridged12; SolderJumper-3_P2.0mm_Open_TrianglePad1.0x1.5mm_NumberLabels
Q4: AO3400A; SOT-23
R75: 330Ω; R_0402_1005Metric
R76: 47kΩ; R_0402_1005Metric

Connections:
+3.3V: JP7.3 (B); also elsewhere on the board
+5V: JP7.1 (A); also elsewhere on the board
/Project Architecture/MCU - IO/BUZZER: R75.1; also elsewhere on the board
GND: Q4.2 (S), R76.2; also elsewhere on the board
unnamed: BZ1.1 (+), D2.1 (K), JP7.2 (C)
unnamed: BZ1.2 (-), D2.2 (A), Q4.3 (D)
unnamed: Q4.1 (G), R75.2, R76.1

Notes on the sheet:
[${#}] ${TITLE}
Incremental rotary encoder with switch

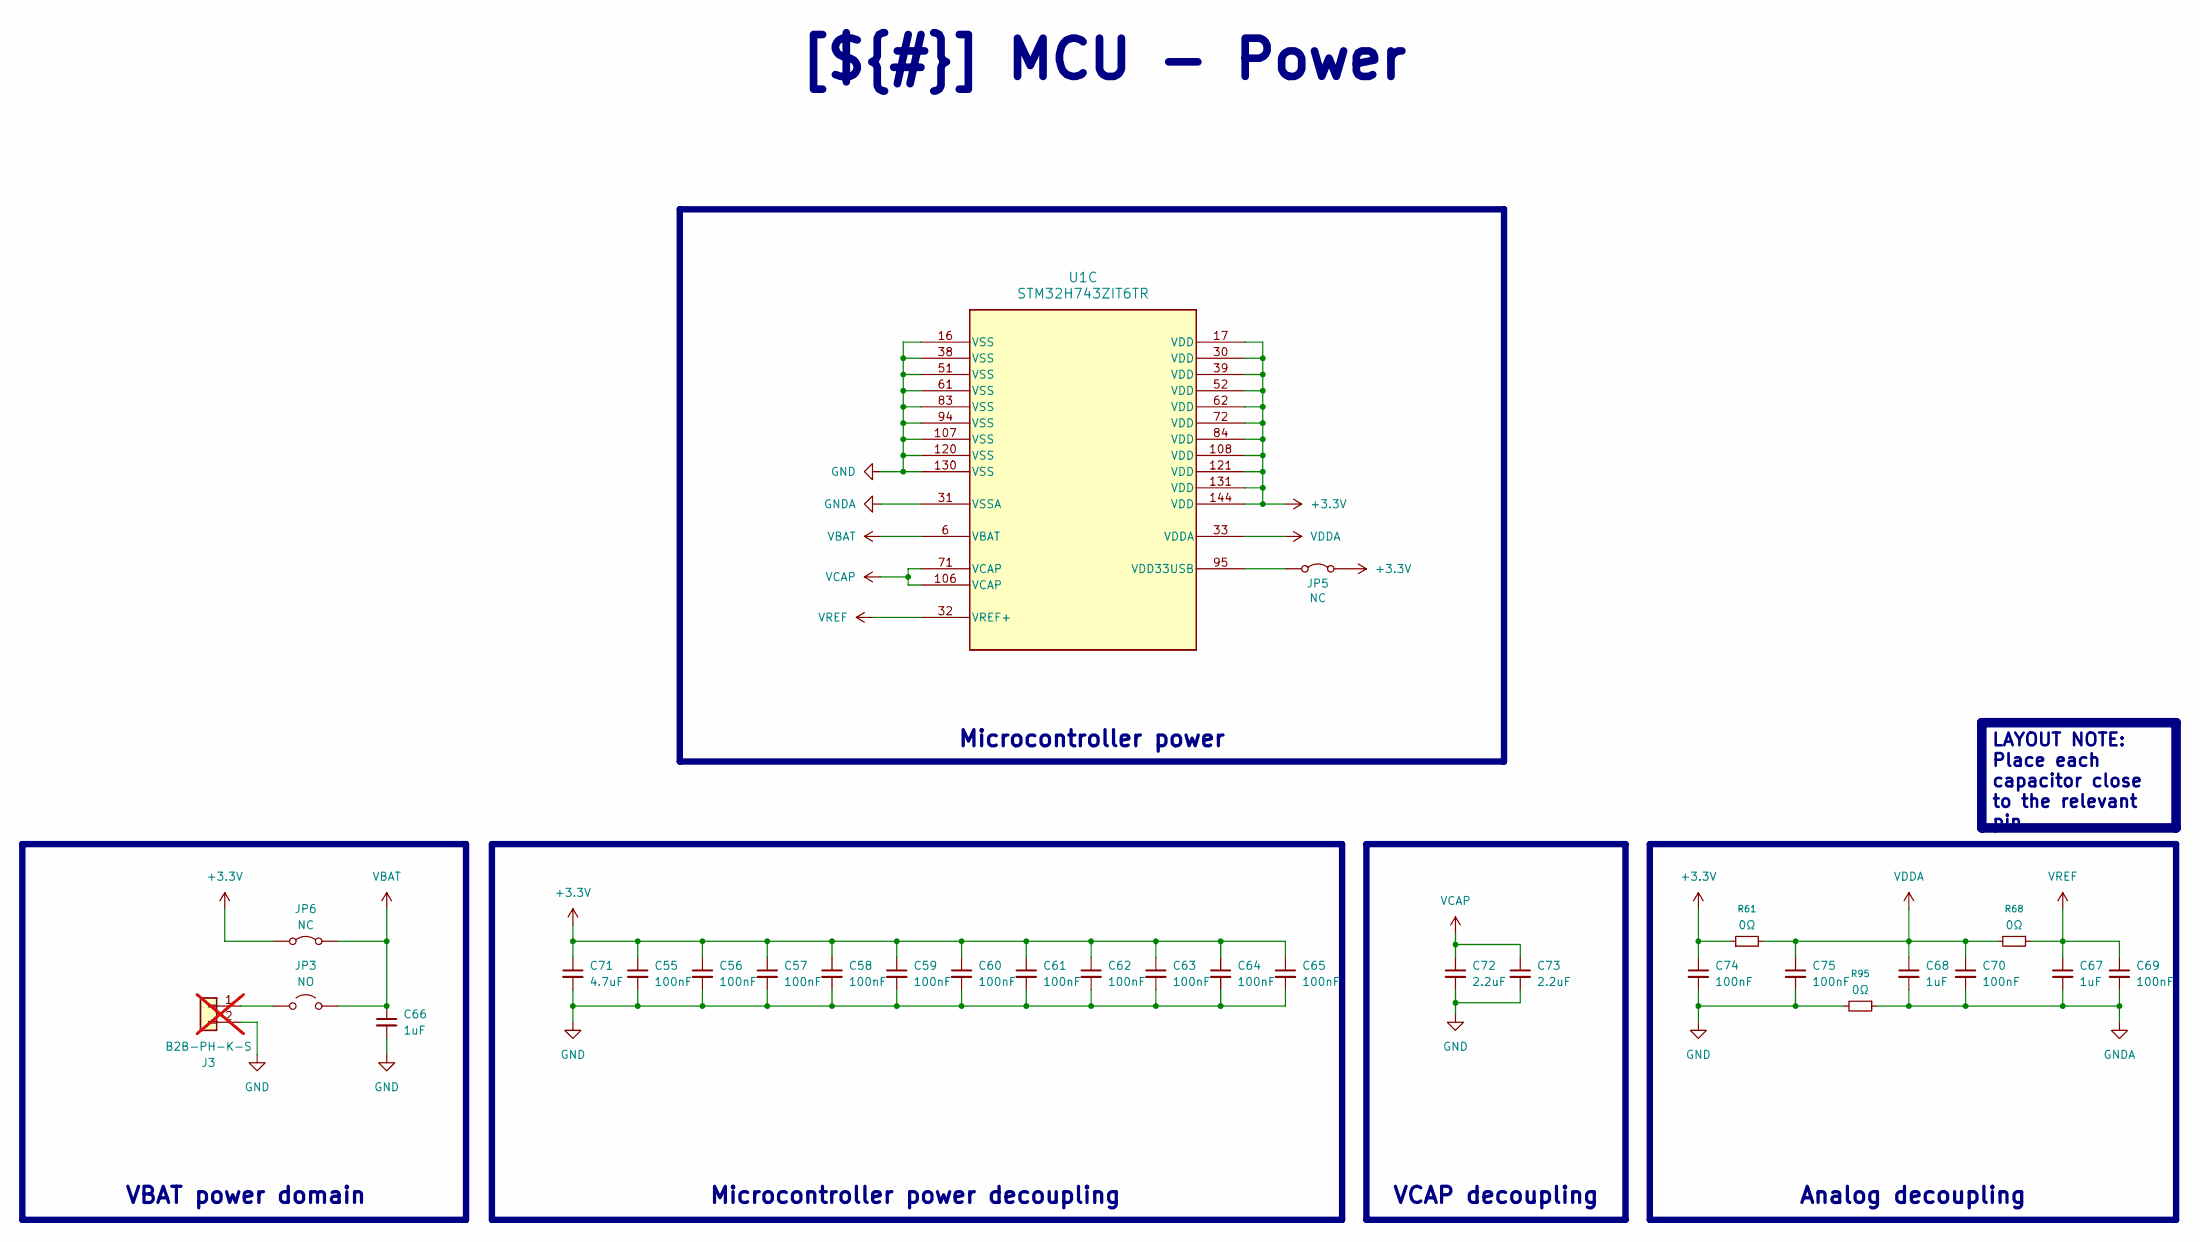
[picture p24: schematic MCU - Power.kicad_sch]

Parts:
C55, C56, C57, C58, C59, C60, C61, C62, C63, C64, C65, C69, C70, C74, C75: 100nF; C_0402_1005Metric
C66, C67, C68: 1uF; C_0603_1608Metric
C71: 4.7uF; C_0805_2012Metric
C72, C73: 2.2uF; C_1206_3216Metric
J3: B2B-PH-K-S; JST_PH_B2B-PH-K_1x02_P2.00mm_Vertical; not fitted
JP3: NO; SolderJumper-2_P1.3mm_Open_TrianglePad1.0x1.5mm
JP5, JP6: NC; SolderJumper-2_P1.3mm_Open_TrianglePad1.0x1.5mm
R61, R68, R95: 0Ω; R_0402_1005Metric
U1: STM32H743ZIT6TR; LQFP-144_1_STM

Connections:
+3.3V: C55.1, C56.1, C57.1, C58.1, C59.1, C60.1, C61.1, C62.1, C63.1, C64.1, C65.1, C71.1, C74.1, JP5.2 (B), JP6.1 (A), R61.1, U1.17 (VDD), U1.30 (VDD), U1.39 (VDD), U1.52 (VDD), U1.62 (VDD), U1.72 (VDD), U1.84 (VDD), U1.108 (VDD), U1.121 (VDD), U1.131 (VDD), U1.144 (VDD); also elsewhere on the board
GND: C55.2, C56.2, C57.2, C58.2, C59.2, C60.2, C61.2, C62.2, C63.2, C64.2, C65.2, C66.2, C71.2, C72.2, C73.2, C74.2, C75.2, J3.2, R95.2, U1.16 (VSS), U1.38 (VSS), U1.51 (VSS), U1.61 (VSS), U1.83 (VSS), U1.94 (VSS), U1.107 (VSS), U1.120 (VSS), U1.130 (VSS); also elsewhere on the board
GNDA: C67.2, C68.2, C69.2, C70.2, R95.1, U1.31 (VSSA)
unnamed: J3.1, JP3.1 (A)
unnamed: JP5.1 (A), U1.95 (VDD33USB)
VBAT: C66.1, JP3.2 (B), JP6.2 (B), U1.6 (VBAT)
VCAP: C72.1, C73.1, U1.71 (VCAP), U1.106 (VCAP)
VDDA: C68.1, C70.1, C75.1, R61.2, R68.2, U1.33 (VDDA)
VREF: C67.1, C69.1, R68.1, U1.32 (VREF+)

Notes on the sheet:
VBAT power domain
Analog decoupling
VCAP decoupling
[${#}] ${TITLE}
Microcontroller power decoupling
Microcontroller power
LAYOUT NOTE: Place each capacitor close to the relevant pin.

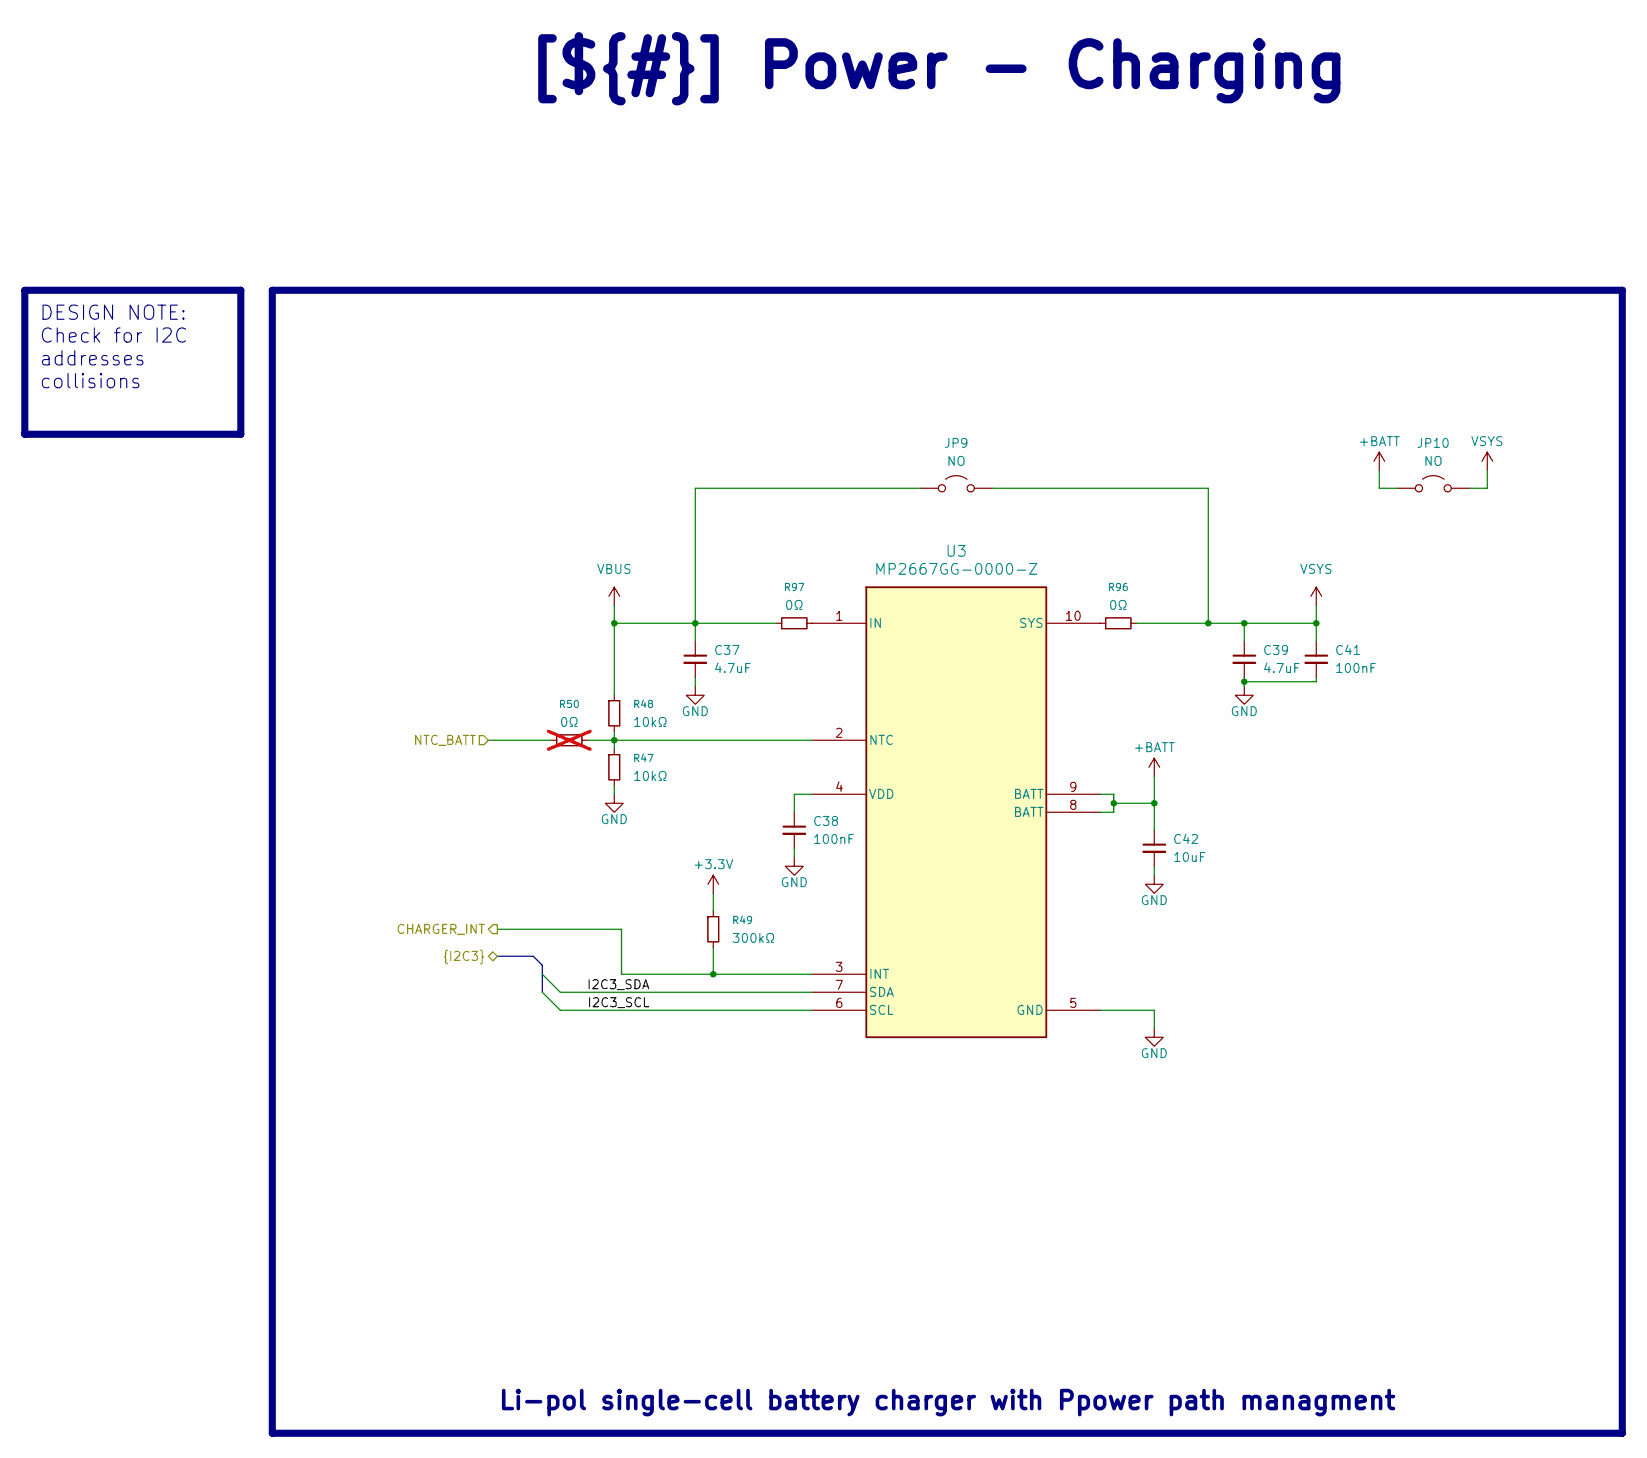
[picture p25: schematic Power - Charging .kicad_sch, Power - Charging]

Parts:
C37, C39: 4.7uF; C_0805_2012Metric
C38, C41: 100nF; C_0402_1005Metric
C42: 10uF; C_0805_2012Metric
JP9, JP10: NO; SolderJumper-2_P1.3mm_Open_TrianglePad1.0x1.5mm
R47, R48: 10kΩ; R_0402_1005Metric
R49: 300kΩ; R_0603_1608Metric
R50: 0Ω; R_0402_1005Metric; not fitted
R96, R97: 0Ω; R_0402_1005Metric
U3: MP2667GG-0000-Z; QFN-10_2MMx2MM_MNP-L

Connections:
+3.3V: R49.1; also elsewhere on the board
+BATT: C42.1, JP10.1 (A), U3.8 (BATT), U3.9 (BATT); also elsewhere on the board
/Project Architecture/Auxiliary/I2C3_SCL: U3.6 (SCL); also elsewhere on the board
/Project Architecture/Auxiliary/I2C3_SDA: U3.7 (SDA); also elsewhere on the board
/Project Architecture/MCU - IO/CHARGER_INT: R49.2, U3.3 (INT); also elsewhere on the board
/Project Architecture/Power - Battery/NTC_BATT: R50.1; also elsewhere on the board
GND: C37.2, C38.2, C39.2, C41.2, C42.2, R47.2, U3.5 (GND); also elsewhere on the board
unnamed: R97.2, U3.1 (IN)
unnamed: R47.1, R48.2, R50.2, U3.2 (NTC)
unnamed: R96.1, U3.10 (SYS)
unnamed: C38.1, U3.4 (VDD)
VBUS: C37.1, JP9.1 (A), R48.1, R97.1; also elsewhere on the board
VSYS: C39.1, C41.1, JP9.2 (B), JP10.2 (B), R96.2; also elsewhere on the board

Notes on the sheet:
[${#}] ${TITLE}
Li-pol single-cell battery charger with Ppower path managment
DESIGN NOTE: Check for I2C addresses collisions

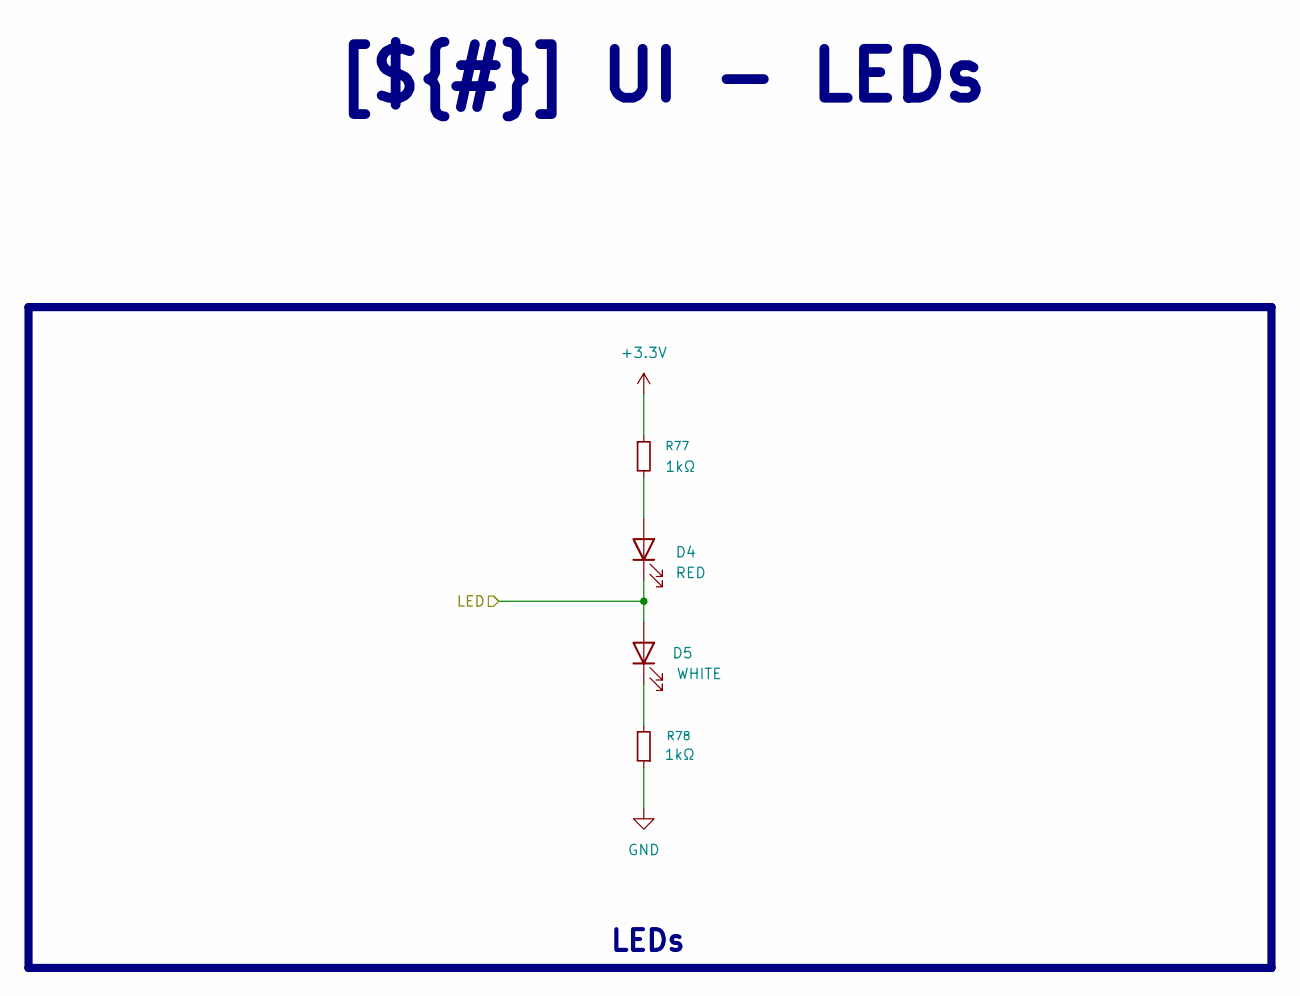
[picture p26: schematic UI - LEDs.kicad_sch]

Parts:
D4: RED; LED_0603_1608Metric
D5: WHITE; LED_0603_1608Metric
R77, R78: 1kΩ; R_0402_1005Metric

Connections:
+3.3V: R77.1; also elsewhere on the board
/Project Architecture/MCU - IO/LED: D4.1 (K), D5.2 (A); also elsewhere on the board
GND: R78.1; also elsewhere on the board
unnamed: D4.2 (A), R77.2
unnamed: D5.1 (K), R78.2

Notes on the sheet:
LEDs
[${#}] ${TITLE}

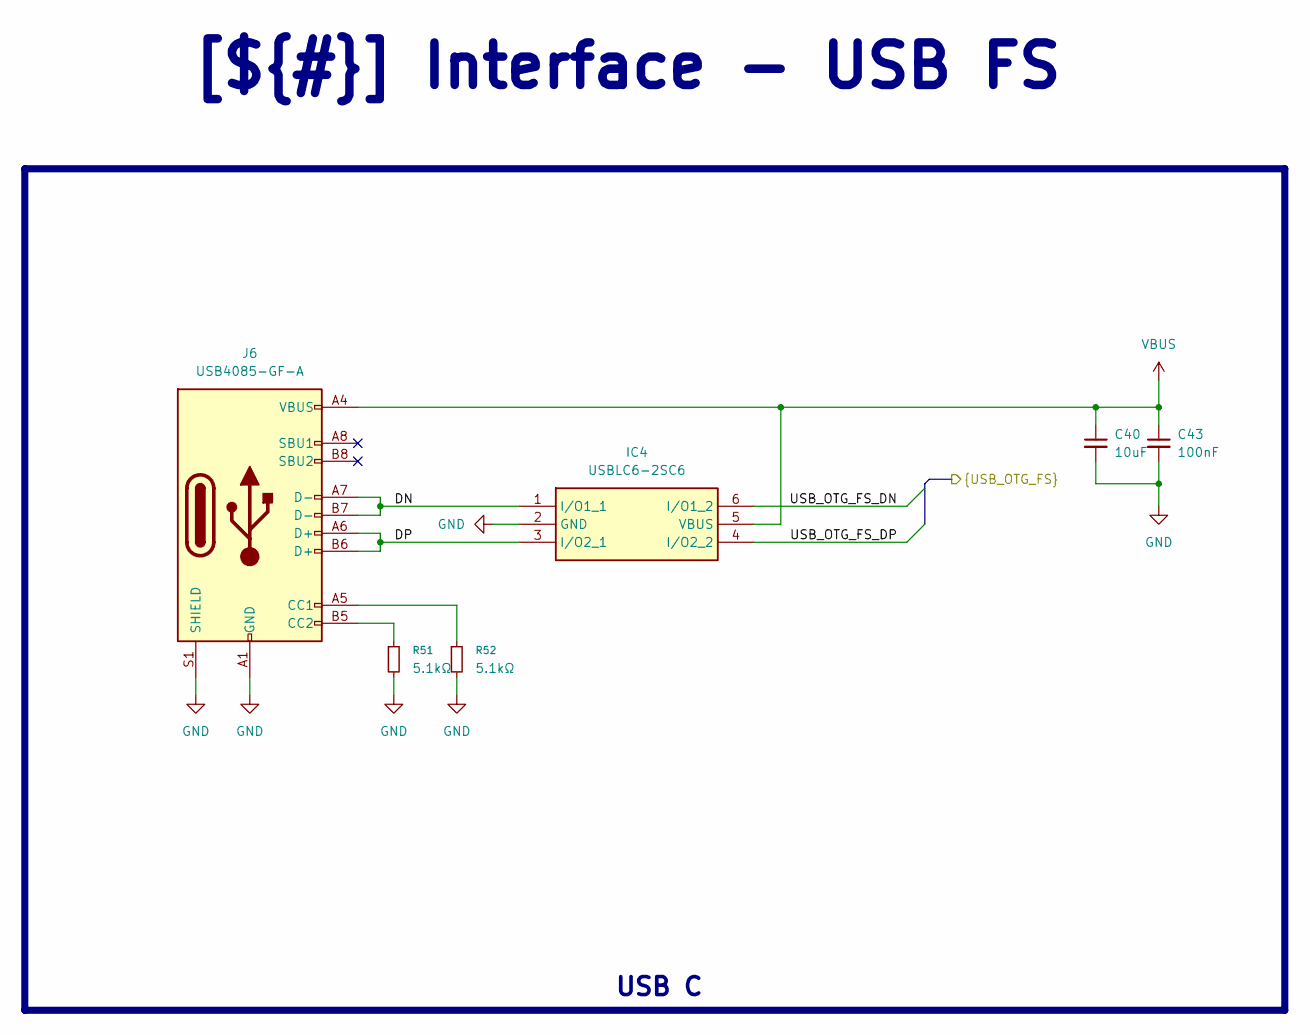
[picture p27: schematic Power and USB.kicad_sch, Interface - USB FS]

Parts:
C40: 10uF; C_0805_2012Metric
C43: 100nF; C_0402_1005Metric
IC4: USBLC6-2SC6; SOT95P280X145-6N; Manufacturer_Part_Number USBLC6-2SC6
J6: USB4085-GF-A; GCT_USB4085-GF-A_REVB
R51, R52: 5.1kΩ; R_0402_1005Metric

Connections:
/Project Architecture/Interface - USB FS/DN: IC4.1 (I/O1_1), J6.A7 (D-), J6.B7 (D-)
/Project Architecture/Interface - USB FS/DP: IC4.3 (I/O2_1), J6.A6 (D+), J6.B6 (D+)
/Project Architecture/Interface - USB FS/USB_OTG_FS_DN: IC4.6 (I/O1_2); also elsewhere on the board
/Project Architecture/Interface - USB FS/USB_OTG_FS_DP: IC4.4 (I/O2_2); also elsewhere on the board
GND: C40.2, C43.2, IC4.2 (GND), J6.A1 (GND), J6.A12 (GND), J6.B1 (GND), J6.B12 (GND), J6.S1 (SHIELD), R51.2, R52.2; also elsewhere on the board
unnamed: J6.A5 (CC1), R52.1
unnamed: J6.B5 (CC2), R51.1
VBUS: C40.1, C43.1, IC4.5 (VBUS), J6.A4 (VBUS), J6.A9 (VBUS), J6.B4 (VBUS), J6.B9 (VBUS); also elsewhere on the board

Notes on the sheet:
USB C
[${#}] ${TITLE}
