lime7git/rc-piper-transmitter/transmitter.kicad_pcb

## KiCad design transmitter.kicad_pcb (continued)

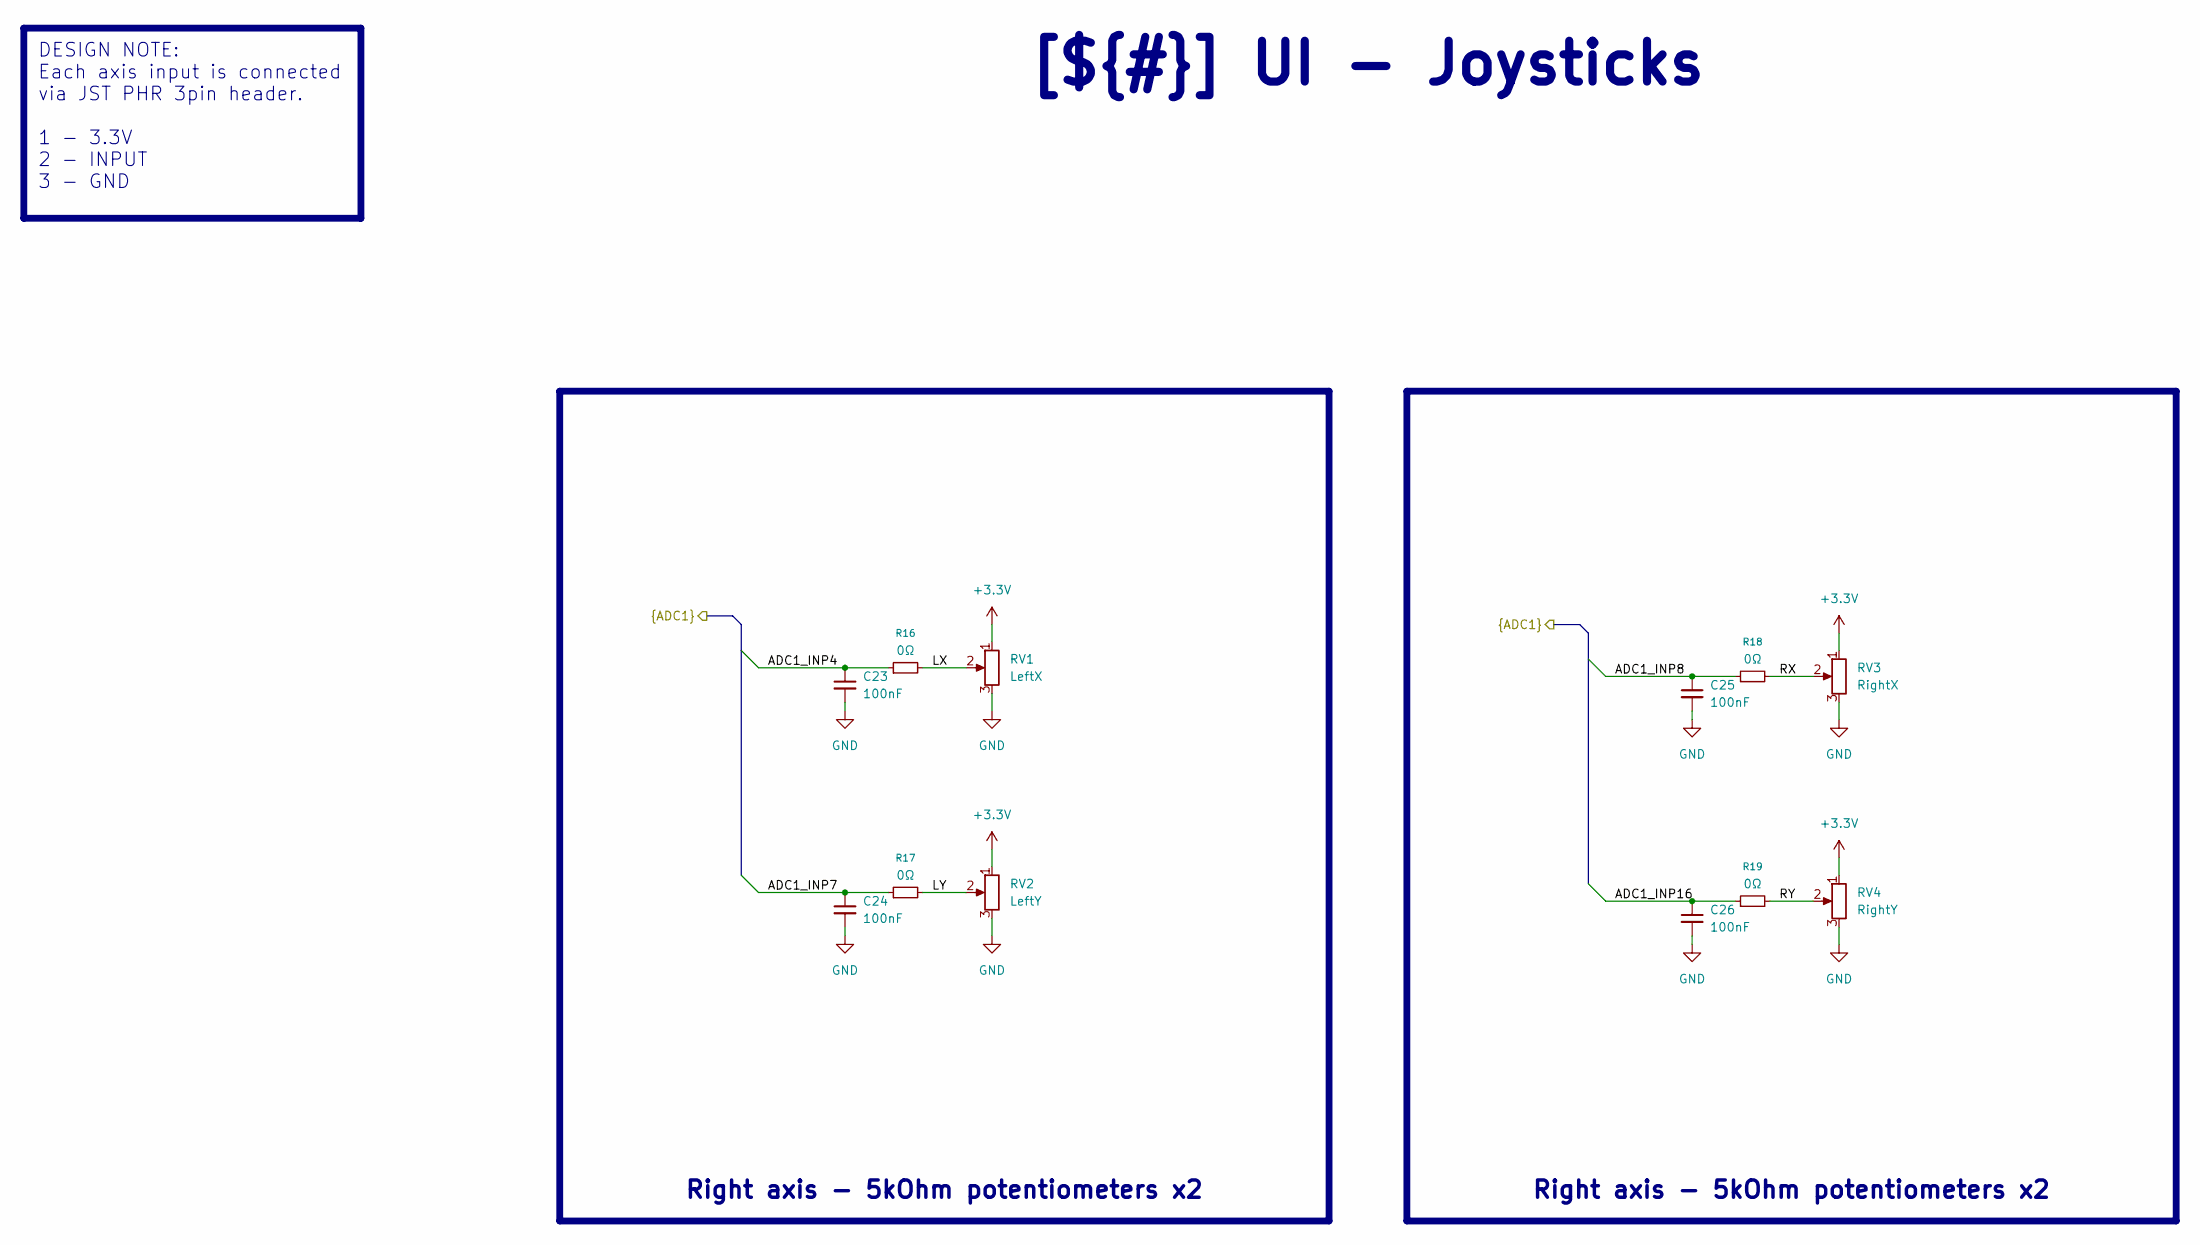
[picture p28: schematic Joysticks.kicad_sch, UI - Joysticks]

Parts:
C23, C24, C25, C26: 100nF; C_0402_1005Metric
R16, R17, R18, R19: 0Ω; R_0402_1005Metric
RV1: LeftX; JST_PH_B3B-PH-K_1x03_P2.00mm_Vertical
RV2: LeftY; JST_PH_B3B-PH-K_1x03_P2.00mm_Vertical
RV3: RightX; JST_PH_B3B-PH-K_1x03_P2.00mm_Vertical
RV4: RightY; JST_PH_B3B-PH-K_1x03_P2.00mm_Vertical

Connections:
+3.3V: RV1.1, RV2.1, RV3.1, RV4.1; also elsewhere on the board
/Project Architecture/MCU - IO/ADC1_INP4: C23.1, R16.1; also elsewhere on the board
/Project Architecture/MCU - IO/ADC1_INP7: C24.1, R17.1; also elsewhere on the board
/Project Architecture/MCU - IO/ADC1_INP8: C25.1, R18.1; also elsewhere on the board
/Project Architecture/MCU - IO/ADC1_INP16: C26.1, R19.1; also elsewhere on the board
/Project Architecture/UI - Joysticks/LX: R16.2, RV1.2
/Project Architecture/UI - Joysticks/LY: R17.2, RV2.2
/Project Architecture/UI - Joysticks/RX: R18.2, RV3.2
/Project Architecture/UI - Joysticks/RY: R19.2, RV4.2
GND: C23.2, C24.2, C25.2, C26.2, RV1.3, RV2.3, RV3.3, RV4.3; also elsewhere on the board

Notes on the sheet:
Right axis - 5kOhm potentiometers x2
DESIGN NOTE: Each axis input is connected via JST PHR 3pin header. 1 - 3.3V 2 - INPUT 3 - GND
[${#}] ${TITLE}

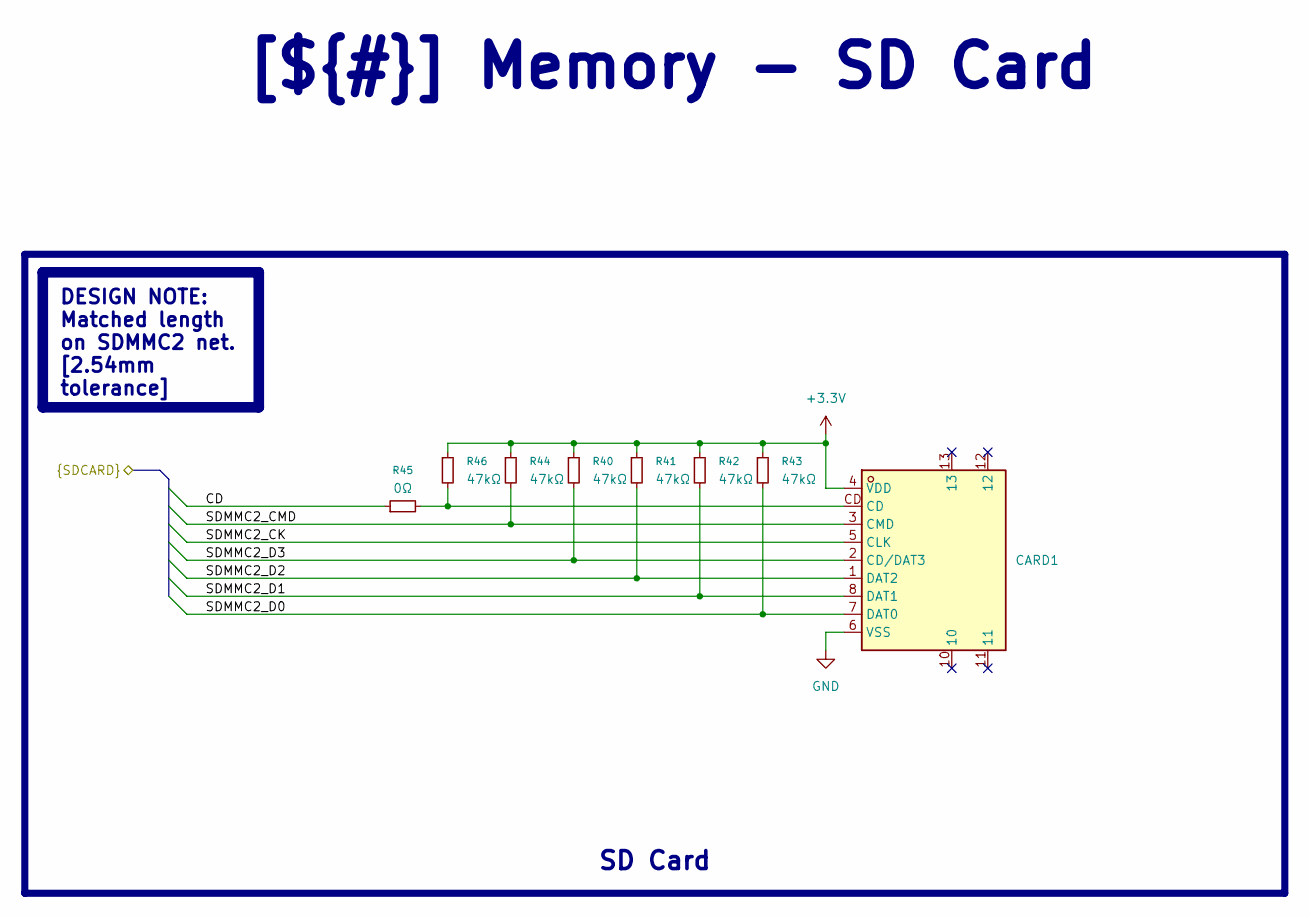
[picture p29: schematic MCU - SD Card.kicad_sch, Memory - SD Card]

Parts:
CARD1: TF-SMD_TF-PUSH; Manufacturer Part TF PUSH
R40, R41, R42, R43, R44, R46: 47kΩ; R_0402_1005Metric
R45: 0Ω; R_0402_1005Metric

Connections:
+3.3V: CARD1.4 (VDD), R40.1, R41.1, R42.1, R43.1, R44.1, R46.1; also elsewhere on the board
/Project Architecture/MCU - IO/CD: R45.1; also elsewhere on the board
/Project Architecture/MCU - IO/SDMMC2_CK: CARD1.5 (CLK); also elsewhere on the board
/Project Architecture/MCU - IO/SDMMC2_CMD: CARD1.3 (CMD), R44.2; also elsewhere on the board
/Project Architecture/MCU - IO/SDMMC2_D0: CARD1.7 (DAT0), R43.2; also elsewhere on the board
/Project Architecture/MCU - IO/SDMMC2_D1: CARD1.8 (DAT1), R42.2; also elsewhere on the board
/Project Architecture/MCU - IO/SDMMC2_D2: CARD1.1 (DAT2), R41.2; also elsewhere on the board
/Project Architecture/MCU - IO/SDMMC2_D3: CARD1.2 (CD/DAT3), R40.2; also elsewhere on the board
GND: CARD1.6 (VSS); also elsewhere on the board
unnamed: CARD1.CD, R45.2, R46.2

Notes on the sheet:
[${#}] ${TITLE}
SD Card
DESIGN NOTE: Matched length on SDMMC2 net. [2.54mm tolerance]

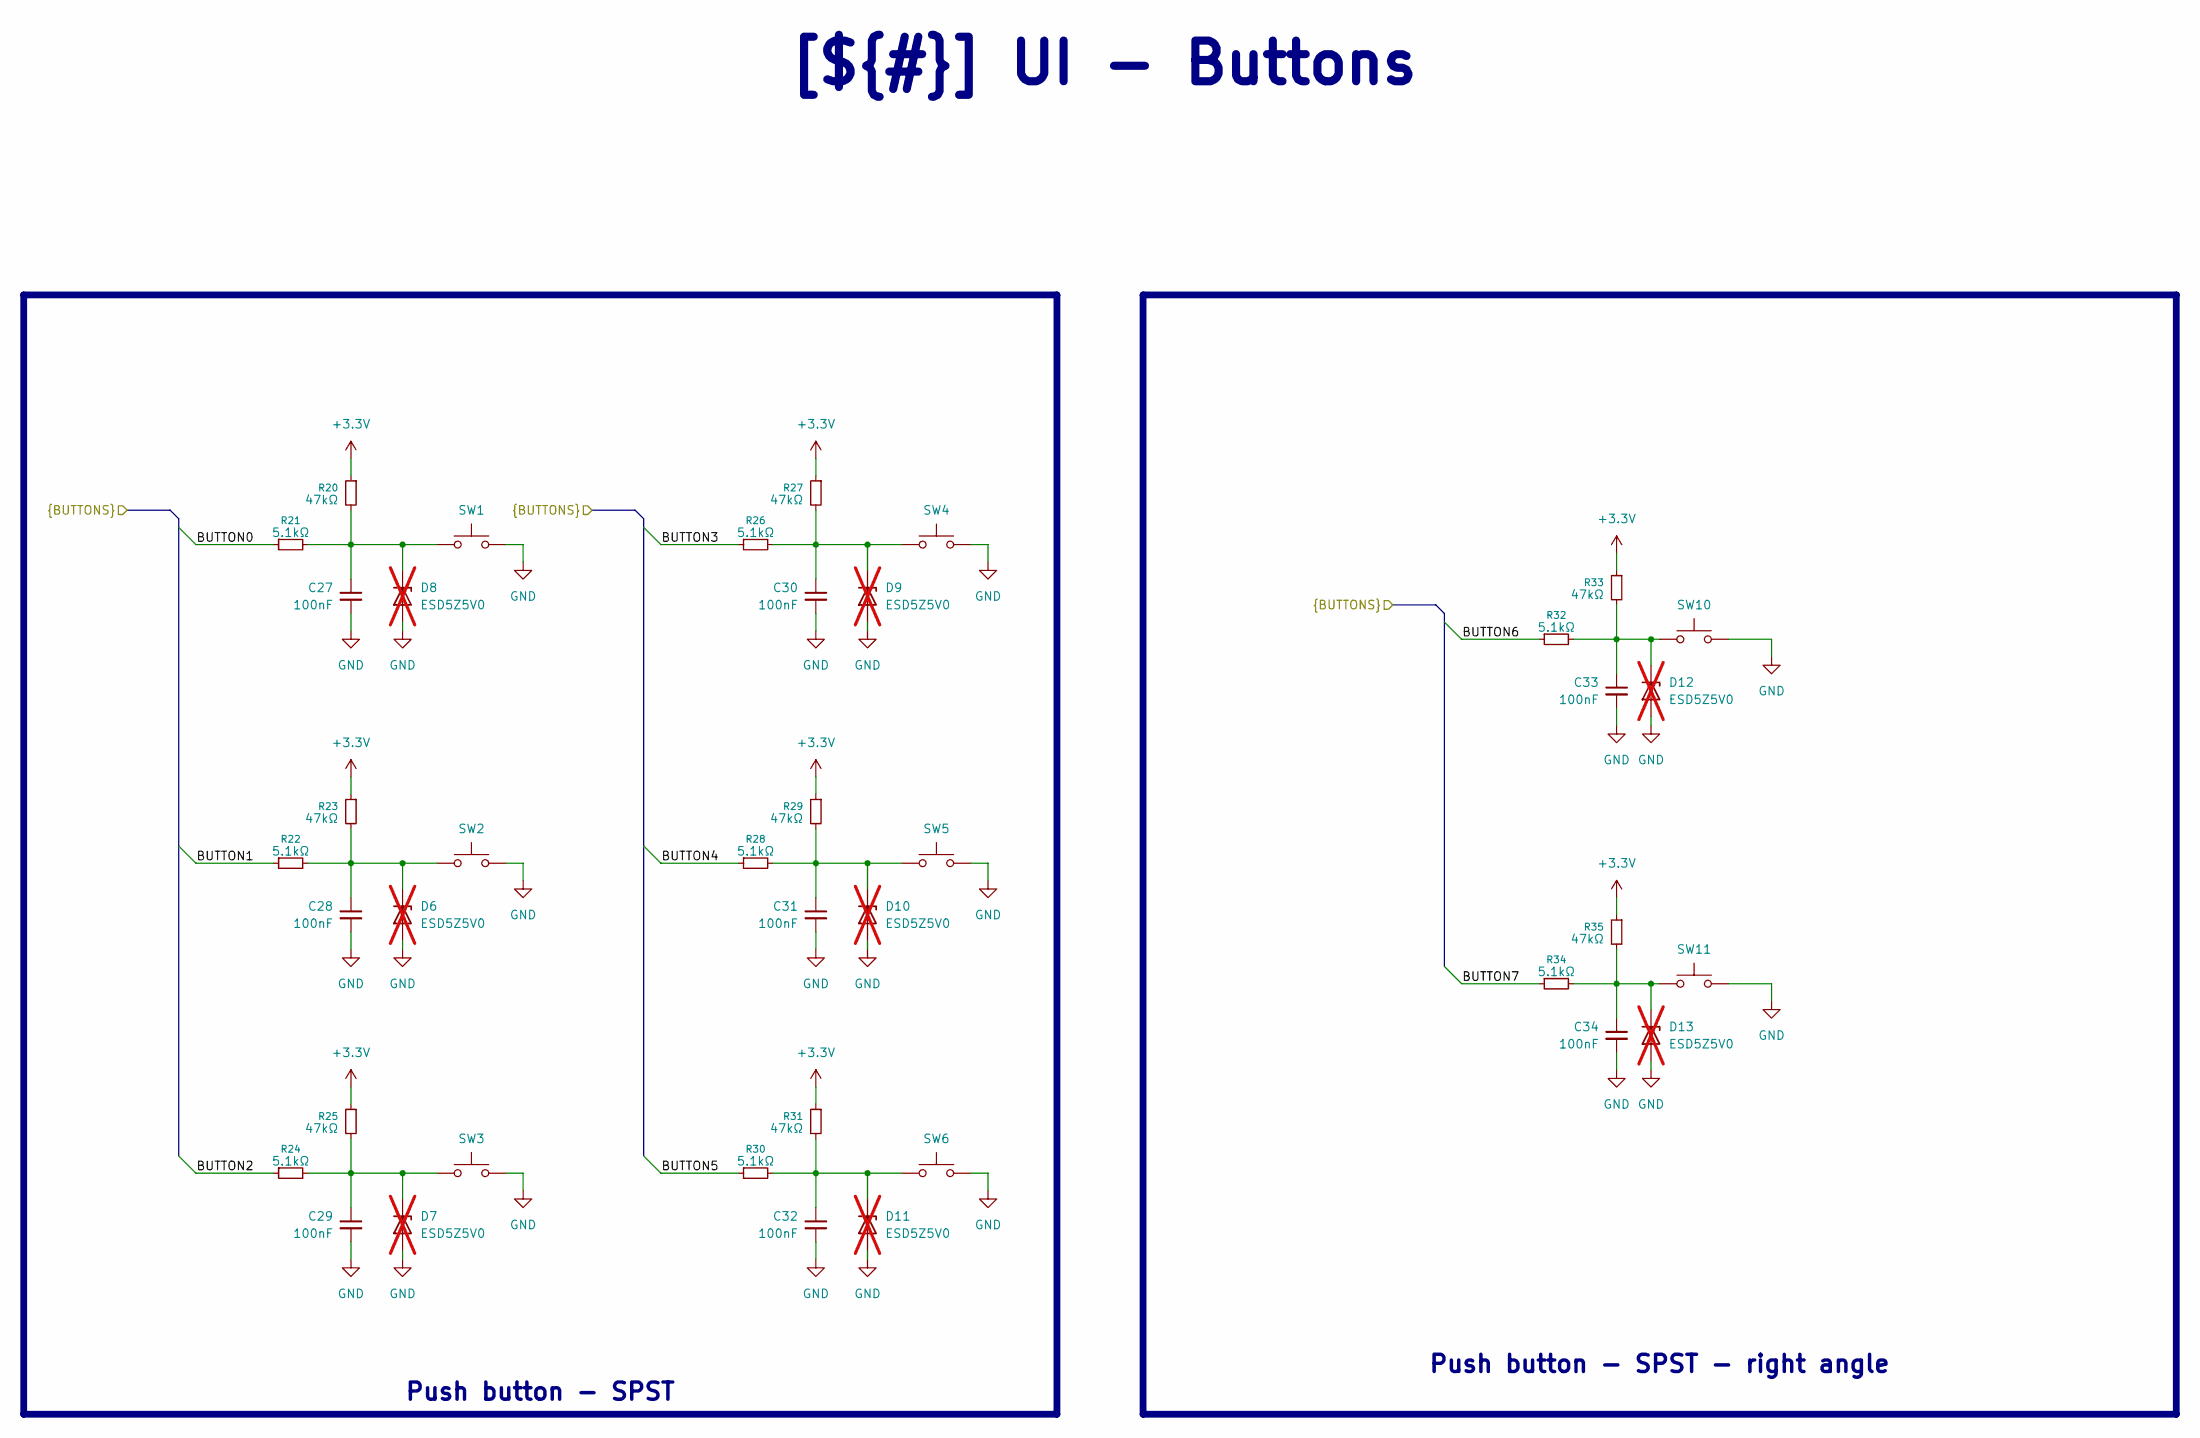
[picture p30: schematic Buttons.kicad_sch, UI - Buttons]

Parts:
C27, C28, C29, C30, C31, C32, C33, C34: 100nF; C_0402_1005Metric
D6, D7, D8, D9, D10, D11, D12, D13: ESD5Z5V0; D_SOD-523; not fitted
R20, R23, R25, R27, R29, R31, R33, R35: 47kΩ; R_0402_1005Metric
R21, R22, R24, R26, R28, R30, R32, R34: 5.1kΩ; R_0402_1005Metric
SW1, SW2, SW3, SW4, SW5, SW6, SW10, SW11: Button SPST SMD Tactile Switch; JST_PH_B2B-PH-K_1x02_P2.00mm_Vertical

Connections:
+3.3V: R20.1, R23.1, R25.1, R27.1, R29.1, R31.1, R33.1, R35.1; also elsewhere on the board
/Project Architecture/Auxiliary/BUTTON0: R21.1; also elsewhere on the board
/Project Architecture/Auxiliary/BUTTON1: R22.1; also elsewhere on the board
/Project Architecture/Auxiliary/BUTTON2: R24.1; also elsewhere on the board
/Project Architecture/Auxiliary/BUTTON3: R26.1; also elsewhere on the board
/Project Architecture/Auxiliary/BUTTON4: R28.1; also elsewhere on the board
/Project Architecture/Auxiliary/BUTTON5: R30.1; also elsewhere on the board
/Project Architecture/Auxiliary/BUTTON6: R32.1; also elsewhere on the board
/Project Architecture/Auxiliary/BUTTON7: R34.1; also elsewhere on the board
GND: C27.2, C28.2, C29.2, C30.2, C31.2, C32.2, C33.2, C34.2, D6.2 (A), D7.2 (A), D8.2 (A), D9.2 (A), D10.2 (A), D11.2 (A), D12.2 (A), D13.2 (A), SW1.2, SW2.2, SW3.2, SW4.2, SW5.2, SW6.2, SW10.2, SW11.2; also elsewhere on the board
unnamed: C28.1, D6.1 (K), R22.2, R23.2, SW2.1
unnamed: C29.1, D7.1 (K), R24.2, R25.2, SW3.1
unnamed: C27.1, D8.1 (K), R20.2, R21.2, SW1.1
unnamed: C30.1, D9.1 (K), R26.2, R27.2, SW4.1
unnamed: C31.1, D10.1 (K), R28.2, R29.2, SW5.1
unnamed: C32.1, D11.1 (K), R30.2, R31.2, SW6.1
unnamed: C33.1, D12.1 (K), R32.2, R33.2, SW10.1
unnamed: C34.1, D13.1 (K), R34.2, R35.2, SW11.1

Notes on the sheet:
Push button - SPST - right angle
[${#}] ${TITLE}
Push button - SPST

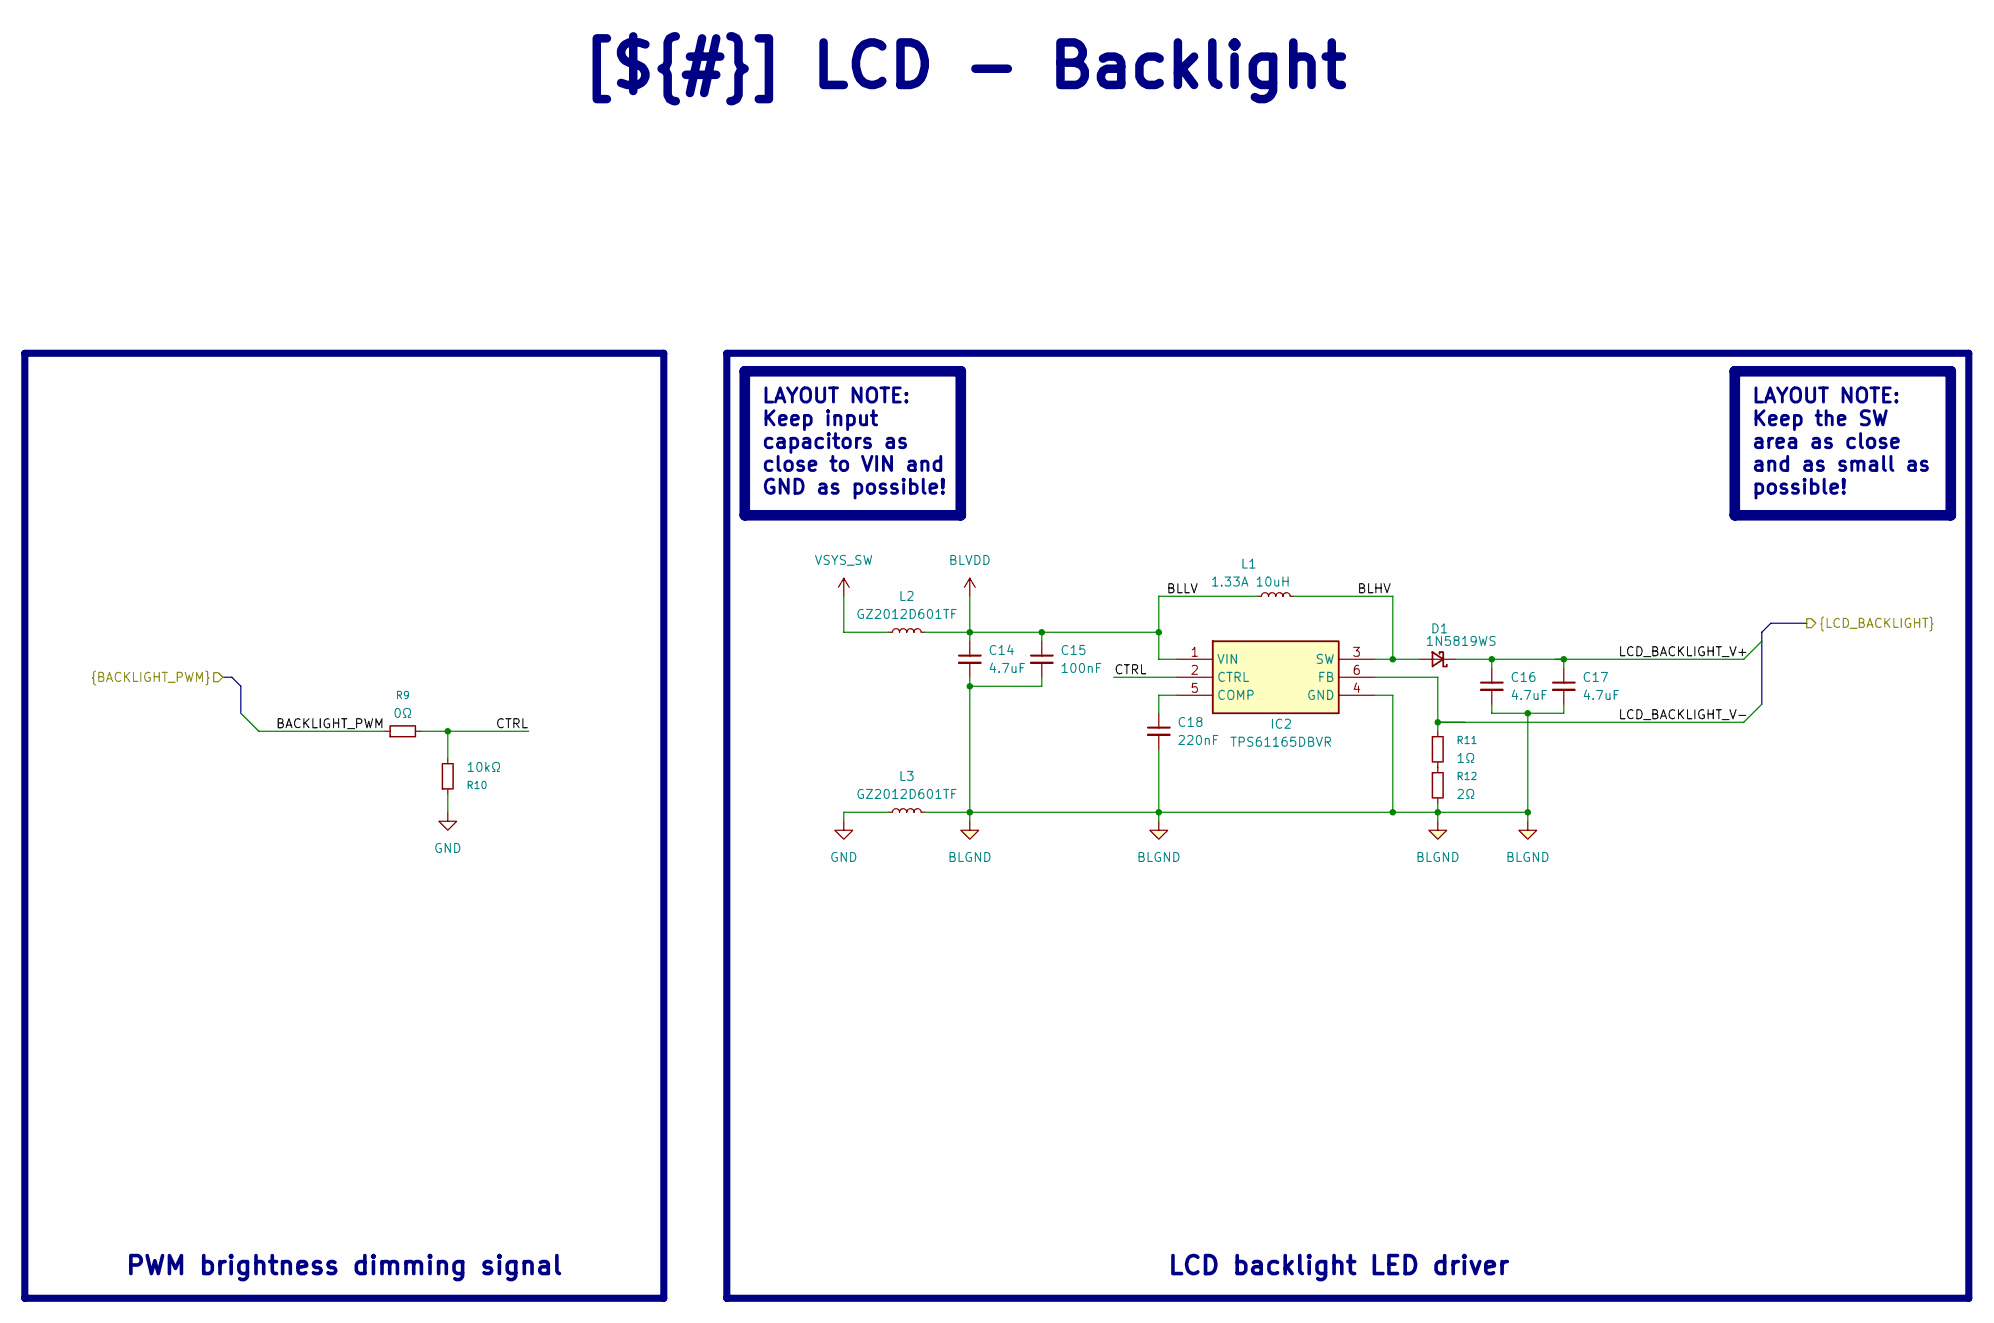
[picture p31: schematic LCD - Backlight.kicad_sch]

Parts:
C14, C16, C17: 4.7uF; C_0805_2012Metric
C15: 100nF; C_0402_1005Metric
C18: 220nF; C_0402_1005Metric
D1: 1N5819WS; D_SOD-323
IC2: TPS61165DBVR; SOT95P280X145-6N; Mouser Part Number 595-TPS61165DBVR
L1: 1.33A 10uH; IND_VLS3012HBX-100M
L2, L3: GZ2012D601TF; L_0805_2012Metric
R9: 0Ω; R_0402_1005Metric
R10: 10kΩ; R_0402_1005Metric
R11: 1Ω; R_0603_1608Metric
R12: 2Ω; R_0603_1608Metric

Connections:
/Project Architecture/LCD - Backlight/BACKLIGHT_PWM: R9.1; also elsewhere on the board
/Project Architecture/LCD - Backlight/BLHV: D1.2 (A), IC2.3 (SW), L1.2
/Project Architecture/LCD - Backlight/CTRL: IC2.2 (CTRL), R9.2, R10.2
/Project Architecture/LCD - Backlight/LCD_BACKLIGHT_V+: C16.1, C17.1, D1.1 (K); also elsewhere on the board
/Project Architecture/LCD - Backlight/LCD_BACKLIGHT_V-: IC2.6 (FB), R11.1; also elsewhere on the board
BLGND: C14.2, C15.2, C16.2, C17.2, C18.2, IC2.4 (GND), L3.2, R12.2
BLVDD: C14.1, C15.1, IC2.1 (VIN), L1.1, L2.2
GND: L3.1, R10.1; also elsewhere on the board
unnamed: C18.1, IC2.5 (COMP)
unnamed: R11.2, R12.1
VSYS_SW: L2.1; also elsewhere on the board

Notes on the sheet:
PWM brightness dimming signal
LAYOUT NOTE: Keep input capacitors as close to VIN and GND as possible!
LAYOUT NOTE: Keep the SW area as close and as small as possible!
[${#}] ${TITLE}
LCD backlight LED driver

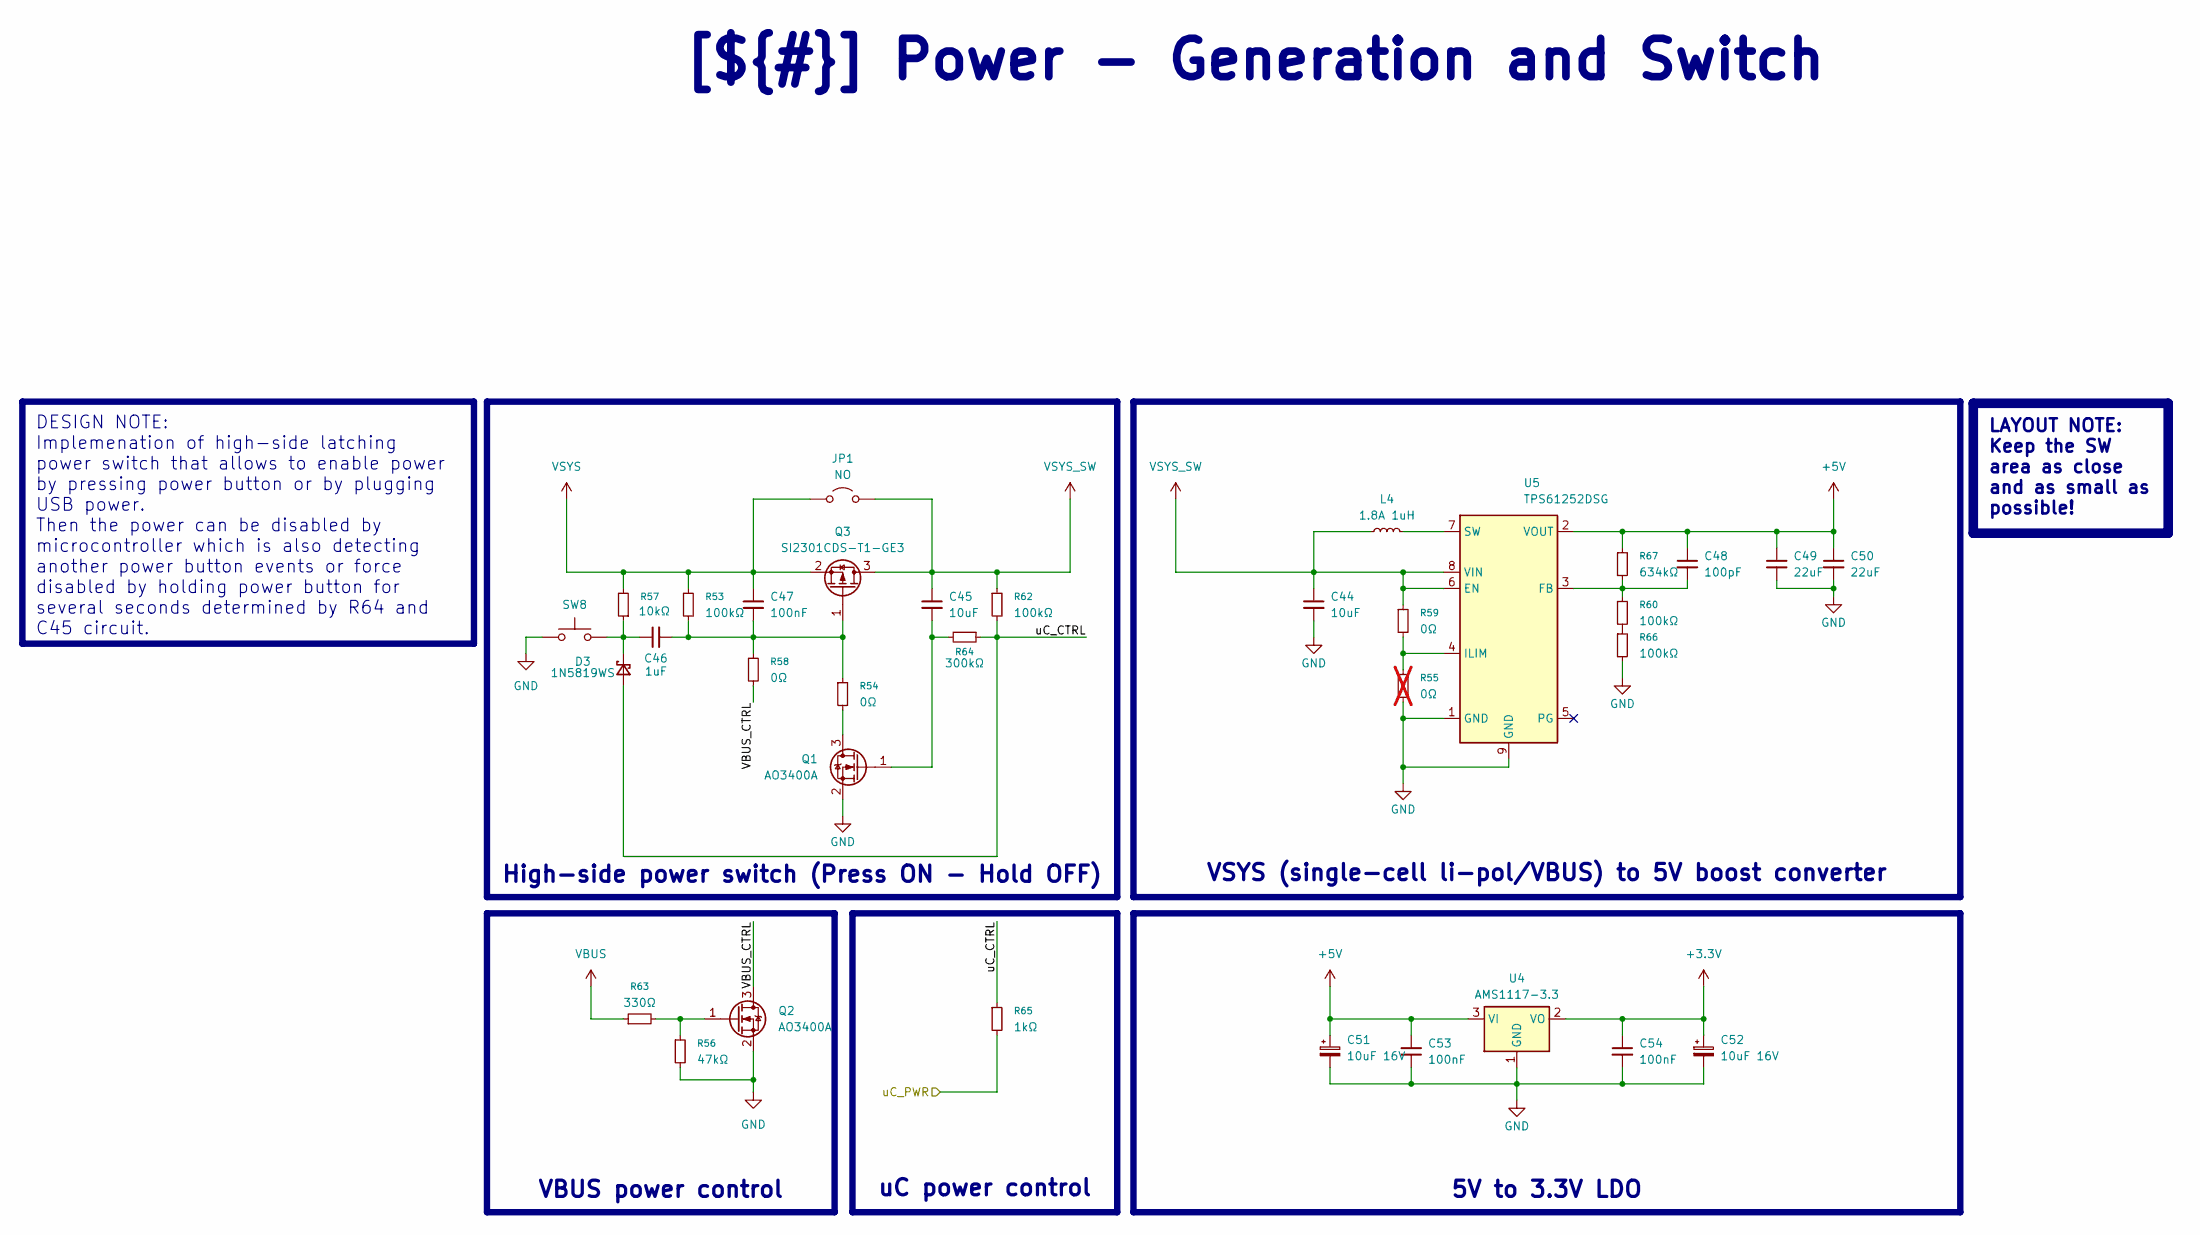
[picture p32: schematic Power - Generation.kicad_sch, Power - Generation and Switch]

Parts:
C44, C45: 10uF; C_0805_2012Metric
C46: 1uF; C_0603_1608Metric
C47, C53, C54: 100nF; C_0402_1005Metric
C48: 100pF; C_0603_1608Metric
C49, C50: 22uF; C_0805_2012Metric
C51, C52: 10uF 16V; CP_EIA-3216-18_Kemet-A
D3: 1N5819WS; D_SOD-323
JP1: NO; SolderJumper-2_P1.3mm_Open_TrianglePad1.0x1.5mm
L4: 1.8A 1uH; L_Cenker_CKCS4018
Q1, Q2: AO3400A; SOT-23
Q3: SI2301CDS-T1-GE3; SOT-23
R53, R60, R62, R66: 100kΩ; R_0402_1005Metric
R54, R58, R59: 0Ω; R_0402_1005Metric
R55: 0Ω; R_0402_1005Metric; not fitted
R56: 47kΩ; R_0402_1005Metric
R57: 10kΩ; R_0402_1005Metric
R63: 330Ω; R_0402_1005Metric
R64: 300kΩ; R_0603_1608Metric
R65: 1kΩ; R_0402_1005Metric
R67: 634kΩ; R_0402_1005Metric
SW8: Button SPST SMD Tactile Switch; SW_TS-1088-AR02016
U4: AMS1117-3.3; SOT-223-3_TabPin2
U5: TPS61252DSG; WSON-8-1EP_2x2mm_P0.5mm_EP0.9x1.6mm

Connections:
+3.3V: C52.1, C54.1, U4.2 (VO); also elsewhere on the board
+5V: C48.1, C49.1, C50.1, C51.1, C53.1, R67.1, U4.3 (VI), U5.2 (VOUT); also elsewhere on the board
/Project Architecture/MCU - IO/uC_PWR: R65.2; also elsewhere on the board
/Project Architecture/Power - Generation and Switch/VBUS_CTRL: Q2.3 (D), R58.2
/Project Architecture/Power - Generation and Switch/uC_CTRL: D3.2 (A), R62.2, R64.1, R65.1
GND: C44.2, C49.2, C50.2, C51.2, C52.2, C53.2, C54.2, Q1.2 (S), Q2.2 (S), R55.2, R56.2, R66.2, SW8.2, U4.1 (GND), U5.1 (GND), U5.9 (GND); also elsewhere on the board
unnamed: C46.1, D3.1 (K), R57.1, SW8.1
unnamed: Q1.3 (D), R54.2
unnamed: C45.2, Q1.1 (G), R64.2
unnamed: Q2.1 (G), R56.1, R63.2
unnamed: C46.2, C47.2, Q3.1 (G), R53.2, R54.1, R58.1
unnamed: R60.2, R66.1
unnamed: C48.2, R60.1, R67.2, U5.3 (FB)
unnamed: R55.1, R59.2, U5.4 (ILIM)
unnamed: L4.2, U5.7 (SW)
VBUS: R63.1; also elsewhere on the board
VSYS: C47.1, JP1.1 (A), Q3.2 (S), R53.1, R57.2; also elsewhere on the board
VSYS_SW: C44.1, C45.1, JP1.2 (B), L4.1, Q3.3 (D), R59.1, R62.1, U5.6 (EN), U5.8 (VIN); also elsewhere on the board

Notes on the sheet:
LAYOUT NOTE: Keep the SW area as close and as small as possible!
[${#}] ${TITLE}
High-side power switch (Press ON - Hold OFF)
VBUS power control
uC power control
5V to 3.3V LDO
DESIGN NOTE: Implemenation of high-side latching power switch that allows to enable power by pressing power button or by plugging USB power. Then the power can be disabled by microcontroller which is also detecting another power button events or force disabled by holding power button for several se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
VSYS (single-cell li-pol/VBUS) to 5V boost converter
