lime7git/rc-piper-transmitter/transmitter.kicad_pcb

## KiCad design transmitter.kicad_pcb (continued)

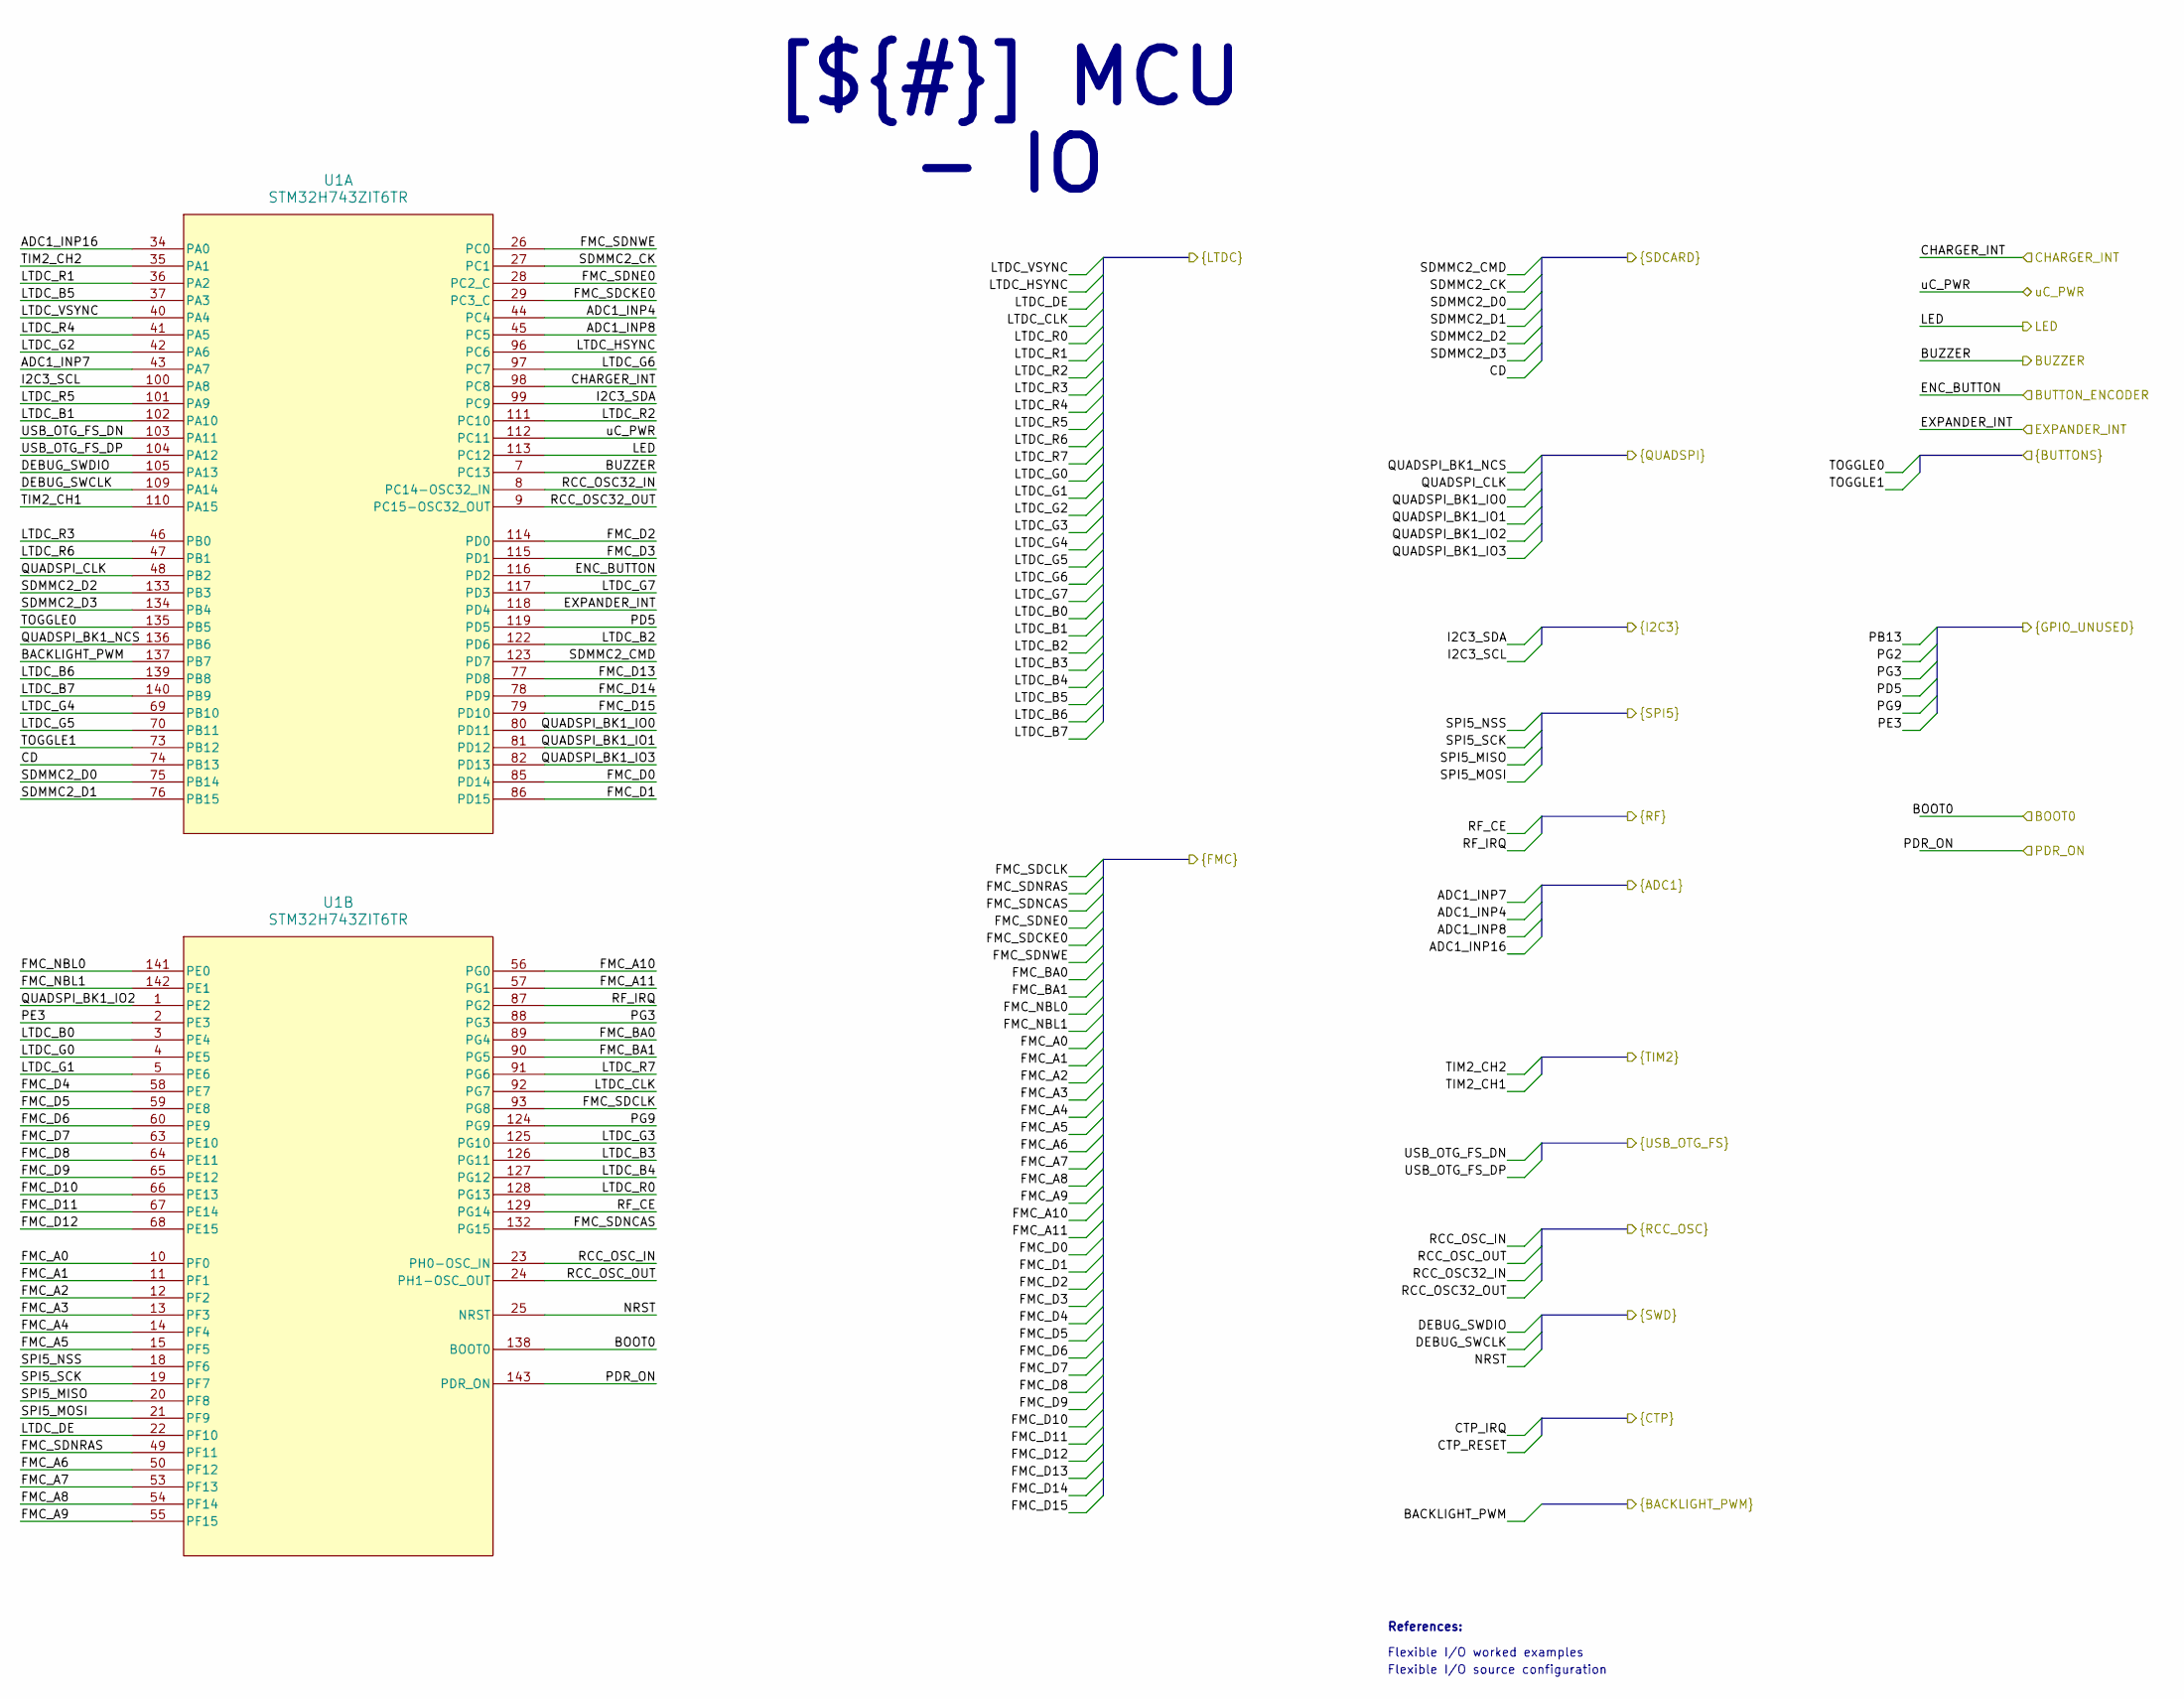
[picture p33: schematic MCU - IO.kicad_sch]

Parts:
U1: STM32H743ZIT6TR; LQFP-144_1_STM

Connections:
/Project Architecture/Auxiliary/DEBUG_SWCLK: U1.109 (PA14); also elsewhere on the board
/Project Architecture/Auxiliary/DEBUG_SWDIO: U1.105 (PA13); also elsewhere on the board
/Project Architecture/Auxiliary/I2C3_SCL: U1.100 (PA8); also elsewhere on the board
/Project Architecture/Auxiliary/I2C3_SDA: U1.99 (PC9); also elsewhere on the board
/Project Architecture/Auxiliary/NRST: U1.25 (NRST); also elsewhere on the board
/Project Architecture/Auxiliary/PD5: U1.119 (PD5); also elsewhere on the board
/Project Architecture/Auxiliary/PE3: U1.2 (PE3); also elsewhere on the board
/Project Architecture/Auxiliary/PG3: U1.88 (PG3); also elsewhere on the board
/Project Architecture/Auxiliary/PG9: U1.124 (PG9); also elsewhere on the board
/Project Architecture/Auxiliary/RCC_OSC32_IN: U1.8 (PC14-OSC32_IN); also elsewhere on the board
/Project Architecture/Auxiliary/RCC_OSC32_OUT: U1.9 (PC15-OSC32_OUT); also elsewhere on the board
/Project Architecture/Auxiliary/RCC_OSC_IN: U1.23 (PH0-OSC_IN); also elsewhere on the board
/Project Architecture/Auxiliary/RCC_OSC_OUT: U1.24 (PH1-OSC_OUT); also elsewhere on the board
/Project Architecture/Auxiliary/TOGGLE0: U1.135 (PB5); also elsewhere on the board
/Project Architecture/Auxiliary/TOGGLE1: U1.73 (PB12); also elsewhere on the board
/Project Architecture/Interface - RF Transmitter/RF_CE: U1.129 (PG14); also elsewhere on the board
/Project Architecture/Interface - RF Transmitter/RF_IRQ: U1.87 (PG2); also elsewhere on the board
/Project Architecture/Interface - RF Transmitter/SPI5_MISO: U1.20 (PF8); also elsewhere on the board
/Project Architecture/Interface - RF Transmitter/SPI5_MOSI: U1.21 (PF9); also elsewhere on the board
/Project Architecture/Interface - RF Transmitter/SPI5_NSS: U1.18 (PF6); also elsewhere on the board
/Project Architecture/Interface - RF Transmitter/SPI5_SCK: U1.19 (PF7); also elsewhere on the board
/Project Architecture/Interface - USB FS/USB_OTG_FS_DN: U1.103 (PA11); also elsewhere on the board
/Project Architecture/Interface - USB FS/USB_OTG_FS_DP: U1.104 (PA12); also elsewhere on the board
/Project Architecture/LCD - Backlight/BACKLIGHT_PWM: U1.137 (PB7); also elsewhere on the board
/Project Architecture/LCD - Connectors/LTDC_B0: U1.3 (PE4); also elsewhere on the board
/Project Architecture/LCD - Connectors/LTDC_B1: U1.102 (PA10); also elsewhere on the board
/Project Architecture/LCD - Connectors/LTDC_B2: U1.122 (PD6); also elsewhere on the board
/Project Architecture/LCD - Connectors/LTDC_B3: U1.126 (PG11); also elsewhere on the board
/Project Architecture/LCD - Connectors/LTDC_B4: U1.127 (PG12); also elsewhere on the board
/Project Architecture/LCD - Connectors/LTDC_B5: U1.37 (PA3); also elsewhere on the board
/Project Architecture/LCD - Connectors/LTDC_B6: U1.139 (PB8); also elsewhere on the board
/Project Architecture/LCD - Connectors/LTDC_B7: U1.140 (PB9); also elsewhere on the board
/Project Architecture/LCD - Connectors/LTDC_CLK: U1.92 (PG7); also elsewhere on the board
/Project Architecture/LCD - Connectors/LTDC_DE: U1.22 (PF10); also elsewhere on the board
/Project Architecture/LCD - Connectors/LTDC_G0: U1.4 (PE5); also elsewhere on the board
/Project Architecture/LCD - Connectors/LTDC_G1: U1.5 (PE6); also elsewhere on the board
/Project Architecture/LCD - Connectors/LTDC_G2: U1.42 (PA6); also elsewhere on the board
/Project Architecture/LCD - Connectors/LTDC_G3: U1.125 (PG10); also elsewhere on the board
/Project Architecture/LCD - Connectors/LTDC_G4: U1.69 (PB10); also elsewhere on the board
/Project Architecture/LCD - Connectors/LTDC_G5: U1.70 (PB11); also elsewhere on the board
/Project Architecture/LCD - Connectors/LTDC_G6: U1.97 (PC7); also elsewhere on the board
/Project Architecture/LCD - Connectors/LTDC_G7: U1.117 (PD3); also elsewhere on the board
/Project Architecture/LCD - Connectors/LTDC_HSYNC: U1.96 (PC6); also elsewhere on the board
/Project Architecture/LCD - Connectors/LTDC_R0: U1.128 (PG13); also elsewhere on the board
/Project Architecture/LCD - Connectors/LTDC_R1: U1.36 (PA2); also elsewhere on the board
/Project Architecture/LCD - Connectors/LTDC_R2: U1.111 (PC10); also elsewhere on the board
/Project Architecture/LCD - Connectors/LTDC_R3: U1.46 (PB0); also elsewhere on the board
/Project Architecture/LCD - Connectors/LTDC_R4: U1.41 (PA5); also elsewhere on the board
/Project Architecture/LCD - Connectors/LTDC_R5: U1.101 (PA9); also elsewhere on the board
/Project Architecture/LCD - Connectors/LTDC_R6: U1.47 (PB1); also elsewhere on the board
/Project Architecture/LCD - Connectors/LTDC_R7: U1.91 (PG6); also elsewhere on the board
/Project Architecture/LCD - Connectors/LTDC_VSYNC: U1.40 (PA4); also elsewhere on the board
/Project Architecture/MCU - IO/ADC1_INP4: U1.44 (PC4); also elsewhere on the board
/Project Architecture/MCU - IO/ADC1_INP7: U1.43 (PA7); also elsewhere on the board
/Project Architecture/MCU - IO/ADC1_INP8: U1.45 (PC5); also elsewhere on the board
/Project Architecture/MCU - IO/ADC1_INP16: U1.34 (PA0); also elsewhere on the board
/Project Architecture/MCU - IO/BOOT0: U1.138 (BOOT0); also elsewhere on the board
/Project Architecture/MCU - IO/BUZZER: U1.7 (PC13); also elsewhere on the board
/Project Architecture/MCU - IO/CD: U1.74 (PB13); also elsewhere on the board
/Project Architecture/MCU - IO/CHARGER_INT: U1.98 (PC8); also elsewhere on the board
/Project Architecture/MCU - IO/ENC_BUTTON: U1.116 (PD2); also elsewhere on the board
/Project Architecture/MCU - IO/EXPANDER_INT: U1.118 (PD4); also elsewhere on the board
/Project Architecture/MCU - IO/FMC_A0: U1.10 (PF0); also elsewhere on the board
/Project Architecture/MCU - IO/FMC_A1: U1.11 (PF1); also elsewhere on the board
/Project Architecture/MCU - IO/FMC_A2: U1.12 (PF2); also elsewhere on the board
/Project Architecture/MCU - IO/FMC_A3: U1.13 (PF3); also elsewhere on the board
/Project Architecture/MCU - IO/FMC_A4: U1.14 (PF4); also elsewhere on the board
/Project Architecture/MCU - IO/FMC_A5: U1.15 (PF5); also elsewhere on the board
/Project Architecture/MCU - IO/FMC_A6: U1.50 (PF12); also elsewhere on the board
/Project Architecture/MCU - IO/FMC_A7: U1.53 (PF13); also elsewhere on the board
/Project Architecture/MCU - IO/FMC_A8: U1.54 (PF14); also elsewhere on the board
/Project Architecture/MCU - IO/FMC_A9: U1.55 (PF15); also elsewhere on the board
/Project Architecture/MCU - IO/FMC_A10: U1.56 (PG0); also elsewhere on the board
/Project Architecture/MCU - IO/FMC_A11: U1.57 (PG1); also elsewhere on the board
/Project Architecture/MCU - IO/FMC_BA0: U1.89 (PG4); also elsewhere on the board
/Project Architecture/MCU - IO/FMC_BA1: U1.90 (PG5); also elsewhere on the board
/Project Architecture/MCU - IO/FMC_D0: U1.85 (PD14); also elsewhere on the board
/Project Architecture/MCU - IO/FMC_D1: U1.86 (PD15); also elsewhere on the board
/Project Architecture/MCU - IO/FMC_D2: U1.114 (PD0); also elsewhere on the board
/Project Architecture/MCU - IO/FMC_D3: U1.115 (PD1); also elsewhere on the board
/Project Architecture/MCU - IO/FMC_D4: U1.58 (PE7); also elsewhere on the board
/Project Architecture/MCU - IO/FMC_D5: U1.59 (PE8); also elsewhere on the board
/Project Architecture/MCU - IO/FMC_D6: U1.60 (PE9); also elsewhere on the board
/Project Architecture/MCU - IO/FMC_D7: U1.63 (PE10); also elsewhere on the board
/Project Architecture/MCU - IO/FMC_D8: U1.64 (PE11); also elsewhere on the board
/Project Architecture/MCU - IO/FMC_D9: U1.65 (PE12); also elsewhere on the board
/Project Architecture/MCU - IO/FMC_D10: U1.66 (PE13); also elsewhere on the board
/Project Architecture/MCU - IO/FMC_D11: U1.67 (PE14); also elsewhere on the board
/Project Architecture/MCU - IO/FMC_D12: U1.68 (PE15); also elsewhere on the board
/Project Architecture/MCU - IO/FMC_D13: U1.77 (PD8); also elsewhere on the board
/Project Architecture/MCU - IO/FMC_D14: U1.78 (PD9); also elsewhere on the board
/Project Architecture/MCU - IO/FMC_D15: U1.79 (PD10); also elsewhere on the board
/Project Architecture/MCU - IO/FMC_NBL0: U1.141 (PE0); also elsewhere on the board
/Project Architecture/MCU - IO/FMC_NBL1: U1.142 (PE1); also elsewhere on the board
/Project Architecture/MCU - IO/FMC_SDCKE0: U1.29 (PC3_C); also elsewhere on the board
/Project Architecture/MCU - IO/FMC_SDCLK: U1.93 (PG8); also elsewhere on the board
/Project Architecture/MCU - IO/FMC_SDNCAS: U1.132 (PG15); also elsewhere on the board
/Project Architecture/MCU - IO/FMC_SDNE0: U1.28 (PC2_C); also elsewhere on the board
/Project Architecture/MCU - IO/FMC_SDNRAS: U1.49 (PF11); also elsewhere on the board
/Project Architecture/MCU - IO/FMC_SDNWE: U1.26 (PC0); also elsewhere on the board
/Project Architecture/MCU - IO/LED: U1.113 (PC12); also elsewhere on the board
/Project Architecture/MCU - IO/PDR_ON: U1.143 (PDR_ON); also elsewhere on the board
/Project Architecture/MCU - IO/QUADSPI_BK1_IO0: U1.80 (PD11); also elsewhere on the board
/Project Architecture/MCU - IO/QUADSPI_BK1_IO1: U1.81 (PD12); also elsewhere on the board
/Project Architecture/MCU - IO/QUADSPI_BK1_IO2: U1.1 (PE2); also elsewhere on the board
/Project Architecture/MCU - IO/QUADSPI_BK1_IO3: U1.82 (PD13); also elsewhere on the board
/Project Architecture/MCU - IO/QUADSPI_BK1_NCS: U1.136 (PB6); also elsewhere on the board
/Project Architecture/MCU - IO/QUADSPI_CLK: U1.48 (PB2); also elsewhere on the board
/Project Architecture/MCU - IO/SDMMC2_CK: U1.27 (PC1); also elsewhere on the board
/Project Architecture/MCU - IO/SDMMC2_CMD: U1.123 (PD7); also elsewhere on the board
/Project Architecture/MCU - IO/SDMMC2_D0: U1.75 (PB14); also elsewhere on the board
/Project Architecture/MCU - IO/SDMMC2_D1: U1.76 (PB15); also elsewhere on the board
/Project Architecture/MCU - IO/SDMMC2_D2: U1.133 (PB3); also elsewhere on the board
/Project Architecture/MCU - IO/SDMMC2_D3: U1.134 (PB4); also elsewhere on the board
/Project Architecture/MCU - IO/TIM2_CH1: U1.110 (PA15); also elsewhere on the board
/Project Architecture/MCU - IO/TIM2_CH2: U1.35 (PA1); also elsewhere on the board
/Project Architecture/MCU - IO/uC_PWR: U1.112 (PC11); also elsewhere on the board

Notes on the sheet:
Flexible I/O worked examples
References:
Flexible I/O source configuration
[${#}] ${TITLE}

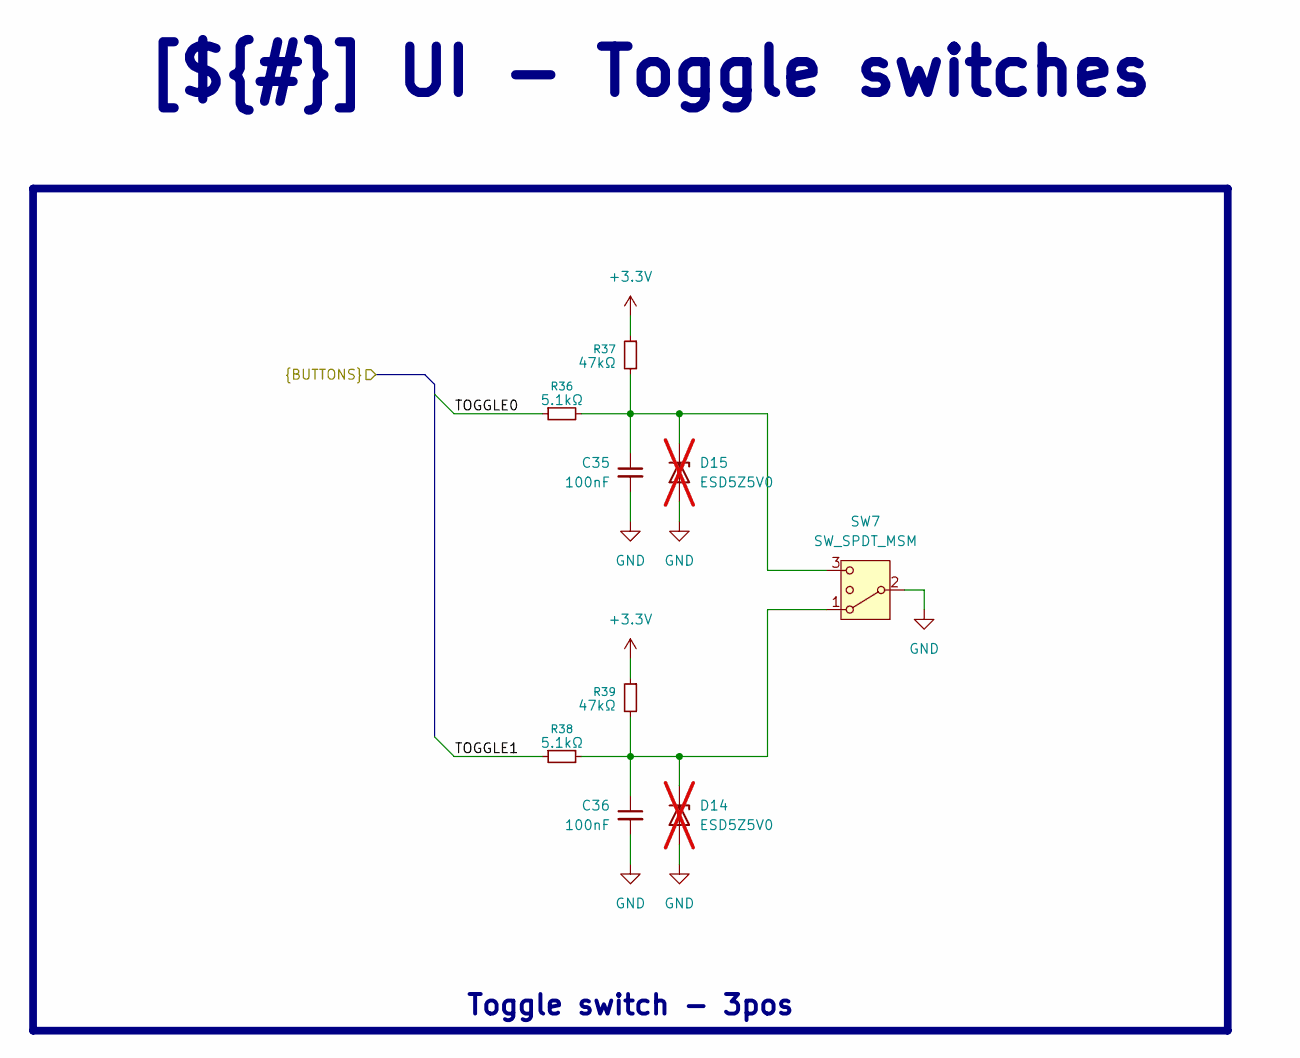
[picture p34: schematic Toggle switches.kicad_sch, UI - Toggle switches]

Parts:
C35, C36: 100nF; C_0402_1005Metric
D14, D15: ESD5Z5V0; D_SOD-523; not fitted
R36, R38: 5.1kΩ; R_0402_1005Metric
R37, R39: 47kΩ; R_0402_1005Metric
SW7: SW_SPDT_MSM; JST_PH_B3B-PH-K_1x03_P2.00mm_Vertical

Connections:
+3.3V: R37.1, R39.1; also elsewhere on the board
/Project Architecture/Auxiliary/TOGGLE0: R36.1; also elsewhere on the board
/Project Architecture/Auxiliary/TOGGLE1: R38.1; also elsewhere on the board
GND: C35.2, C36.2, D14.2 (A), D15.2 (A), SW7.2 (3); also elsewhere on the board
unnamed: C36.1, D14.1 (K), R38.2, R39.2, SW7.1
unnamed: C35.1, D15.1 (K), R36.2, R37.2, SW7.3 (4)

Notes on the sheet:
[${#}] ${TITLE}
Toggle switch - 3pos

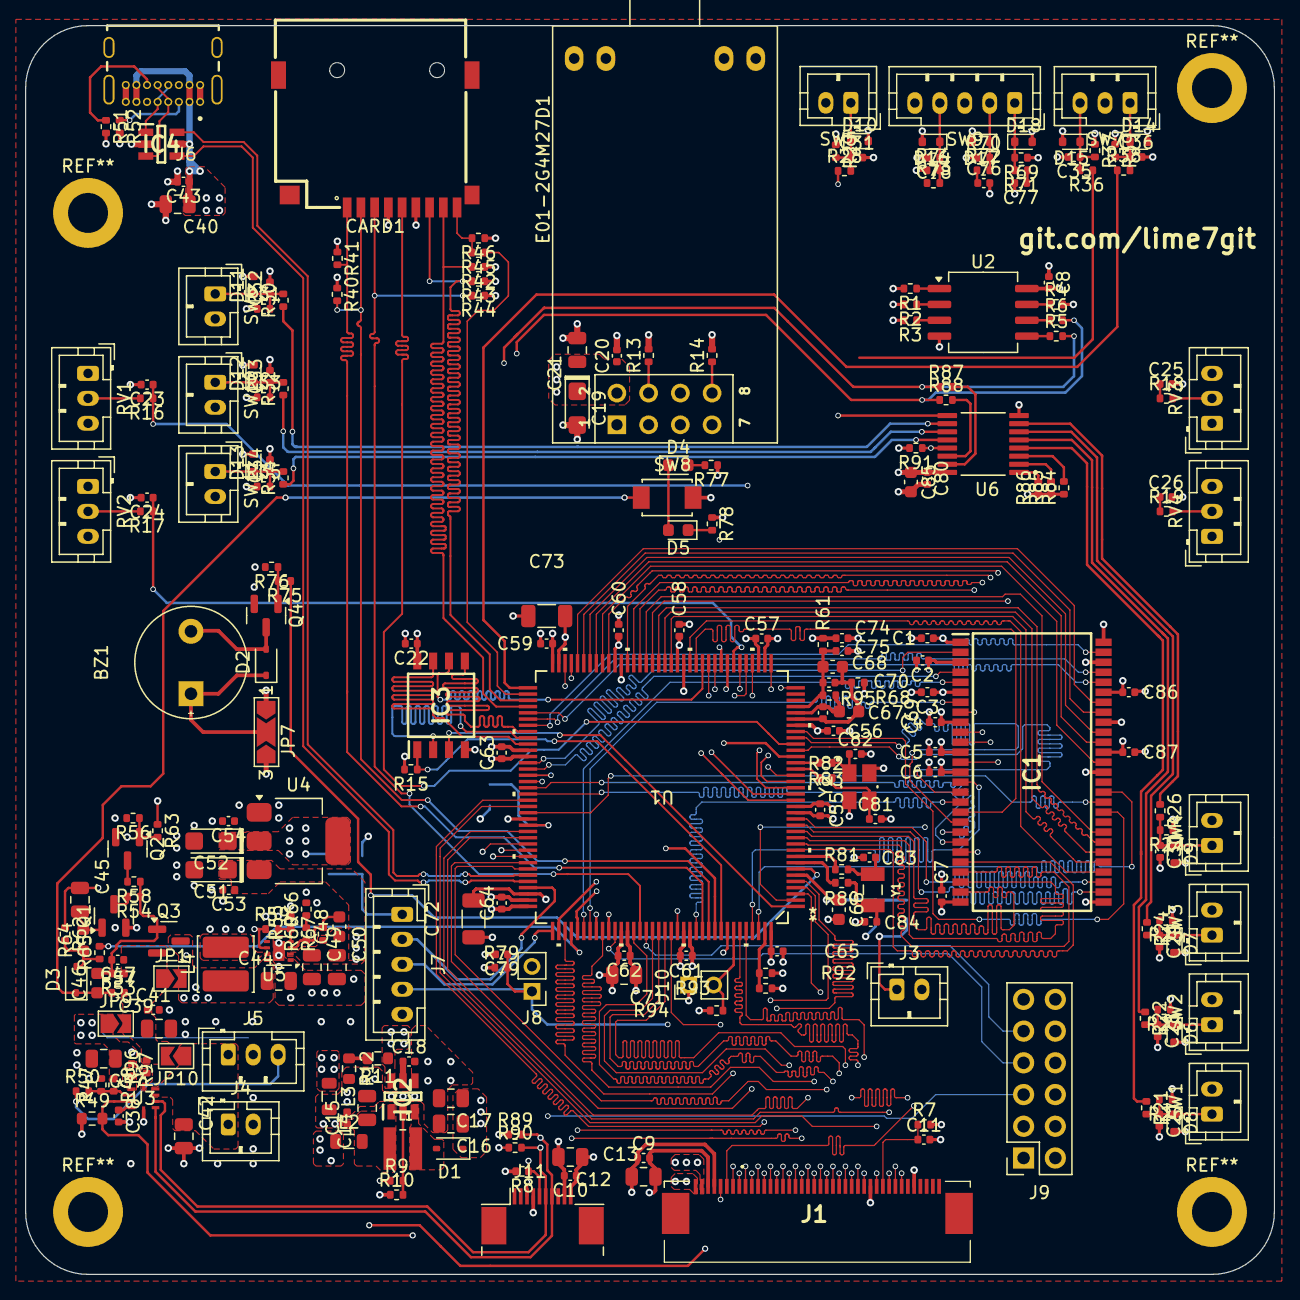
[picture p35: board transmitter.kicad_pcb from above]

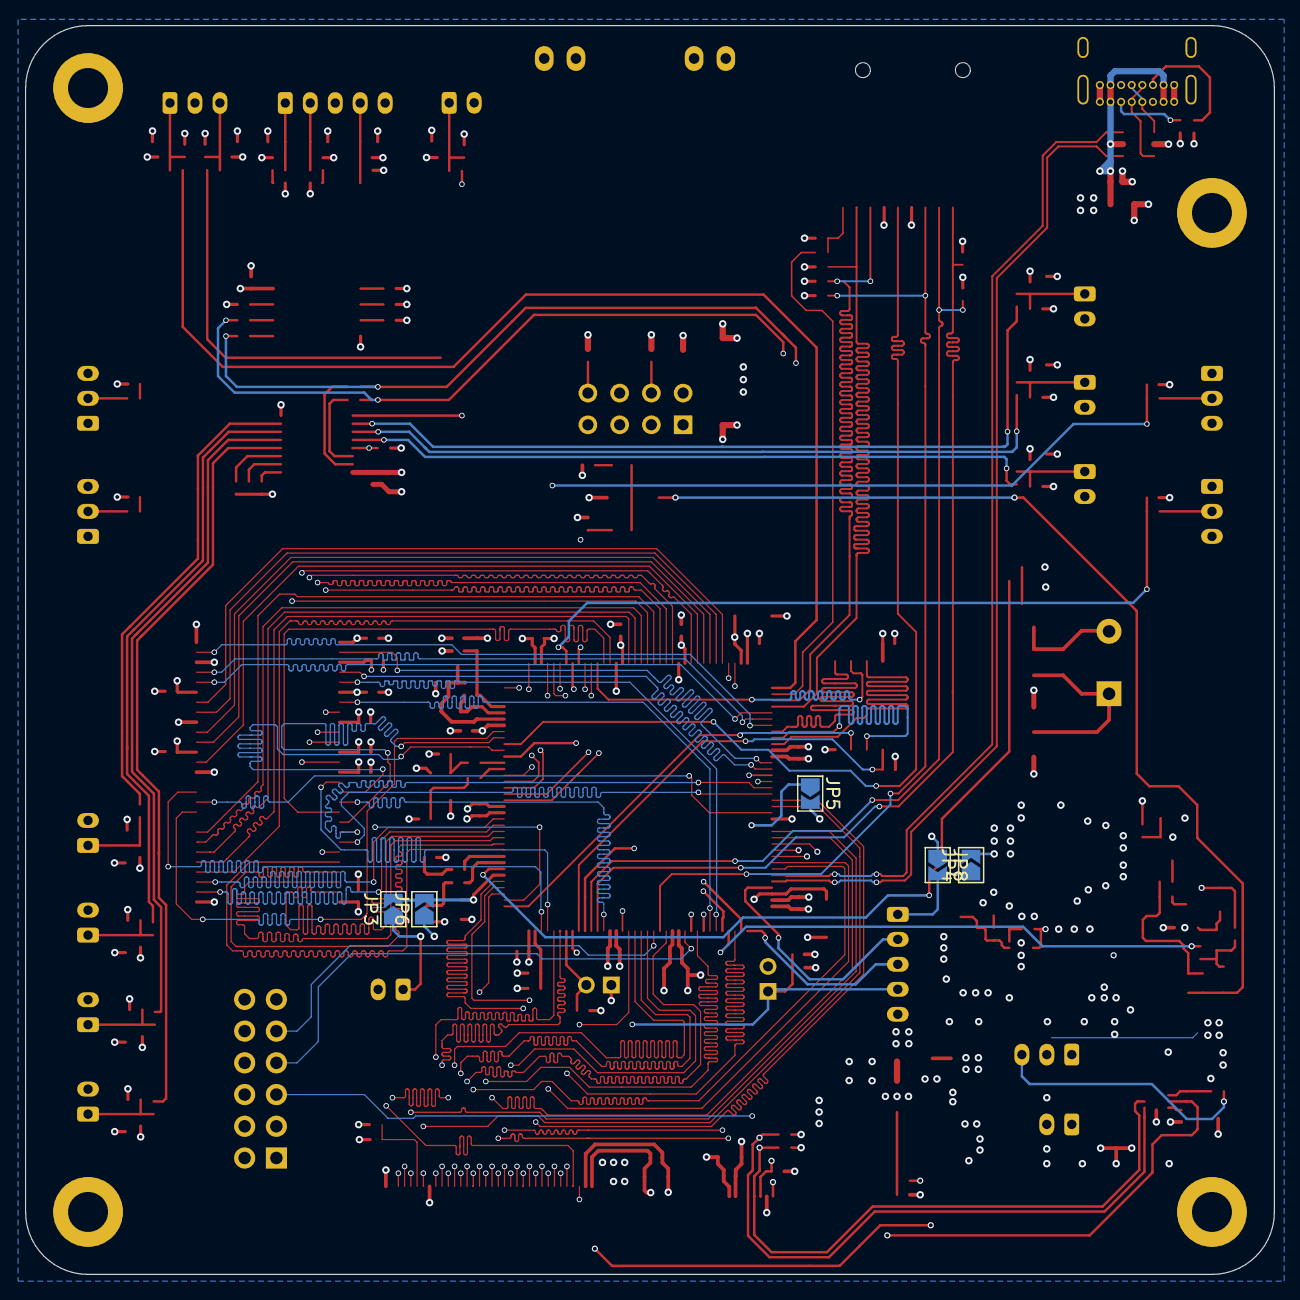
[picture p36: board transmitter.kicad_pcb from below]

Board: 6 copper layers, 100.0 x 100.0 mm, 259 parts (5 on the bottom side), 208 nets.
