lime7git/rc-piper-transmitter/(commit log)

2025-07-12 update project libraries and add connector images
    Create sym-lib-table
2025-07-12 added schematics and pcb, configure project
    [Battery.kicad_sch, Buttons.kicad_sch, Joysticks.kicad_sch, LCD - Backlight.kicad_sch, LCD.kicad_sch, MCU - FLASH.kicad_sch, MCU - IO.kicad_sch, MCU - Memory.kicad_sch]
2025-07-12 added lcd backlight schematic
    [LCD - Backlight.kicad_sch, LCD.kicad_sch, MCU - Memory.kicad_sch, Memory - EEPROM.kicad_sch, transmitter.kicad_pcb, transmitter.kicad_sch]
2025-07-12 fix ffc footprint
2025-07-13 added RF ransceiver
    [LCD - Backlight.kicad_sch, LCD.kicad_sch, MCU - IO.kicad_sch, MCU - Memory.kicad_sch, Transmitter - 2.4GHz.kicad_sch]
2025-07-13 qspi flash
    [MCU - FLASH.kicad_sch]
2025-07-14 added joystick inputs
    [Joysticks.kicad_sch, LCD - Backlight.kicad_sch, MCU - Memory.kicad_sch]
2025-07-14 added buttons schematic
    [Buttons.kicad_sch]
2025-07-14 3 pos toggle switch input
    [Buttons.kicad_sch, Toggle switches.kicad_sch]
2025-07-14 sd card image add
    [MCU - SD Card.kicad_sch]
2025-07-17 added sd card schematic and refactor page numbers and general tab
    [Buttons.kicad_sch, Joysticks.kicad_sch, LCD - Backlight.kicad_sch, MCU - FLASH.kicad_sch, MCU - IO.kicad_sch, MCU - Memory.kicad_sch, MCU - SD Card.kicad_sch, Power and USB.kicad_sch]
2025-07-28 added li-pol input, start creating charging circuit
    [Battery.kicad_sch, LCD - Backlight.kicad_sch, MCU - FLASH.kicad_sch, MCU - Memory.kicad_sch, MCU - SD Card.kicad_sch, Power - Charging .kicad_sch]
2025-07-29 small changes
    [LCD - Backlight.kicad_sch, MCU - FLASH.kicad_sch, MCU - Memory.kicad_sch, MCU - SD Card.kicad_sch, Power - Charging .kicad_sch, Project Architecture.kicad_sch]
2025-07-30 change page numers
    [LCD - Backlight.kicad_sch, MCU - FLASH.kicad_sch, MCU - Memory.kicad_sch, MCU - SD Card.kicad_sch, Project Architecture.kicad_sch]
2025-07-30 added emi for usb port and usb schematic
    [Power and USB.kicad_sch]
2025-07-30 usb new footprint
    [LCD - Backlight.kicad_sch, MCU - FLASH.kicad_sch, MCU - Memory.kicad_sch, MCU - SD Card.kicad_sch, Power and USB.kicad_sch]
2025-07-30 added pchannel mosfet and boost converter tps613222
2025-07-30 added tps61252 boost converter and started working on power - generatio and on/off control schematic
    [LCD - Backlight.kicad_sch, MCU - FLASH.kicad_sch, MCU - Memory.kicad_sch, MCU - SD Card.kicad_sch, Power - Generation.kicad_sch]
2025-07-31 added power switch, 5V and 3V3 power generation
    [LCD - Backlight.kicad_sch, MCU - FLASH.kicad_sch, MCU - Memory.kicad_sch, MCU - SD Card.kicad_sch, Power - Generation.kicad_sch, Project Architecture.kicad_sch, transmitter.kicad_sch]
2025-07-31 charging int and i2c
    [MCU - Power.kicad_sch, Power - Charging .kicad_sch]
2025-07-31 Create power-switch-falstad-circuit.txt
    simulation for power switch schematic
2025-08-01 added power for mcu
    [LCD - Backlight.kicad_sch, MCU - FLASH.kicad_sch, MCU - Memory.kicad_sch, MCU - Power.kicad_sch, MCU - SD Card.kicad_sch, Power - Generation.kicad_sch]
2025-08-01 change some solder bridges from no to nc
    [LCD - Backlight.kicad_sch, MCU - FLASH.kicad_sch, MCU - Memory.kicad_sch, MCU - Power.kicad_sch, MCU - SD Card.kicad_sch, Power - Generation.kicad_sch]
2025-08-01 added encoder input connector
    [Rotary encoders.kicad_sch]
2025-08-03 added buzzer schematic
    [LCD - Backlight.kicad_sch, MCU - FLASH.kicad_sch, MCU - Memory.kicad_sch, MCU - SD Card.kicad_sch, Power - Generation.kicad_sch, Project Architecture.kicad_sch, Rotary encoders.kicad_sch, UI - Buzzer.kicad_sch]
2025-08-03 added red and white led
    [UI - LEDs.kicad_sch]
2025-08-03 led schematic
    [LCD - Backlight.kicad_sch, MCU - FLASH.kicad_sch, MCU - Memory.kicad_sch, MCU - SD Card.kicad_sch, Power - Generation.kicad_sch, UI - LEDs.kicad_sch]
2025-08-23 added auxiliary schematic, problem with kicad - cannot modify project settings
    [LCD - Backlight.kicad_sch, MCU - FLASH.kicad_sch, MCU - IO.kicad_sch, MCU - Memory.kicad_sch, MCU - SD Card.kicad_sch, Power - Generation.kicad_sch, Project Architecture.kicad_sch, UI - LEDs.kicad_sch]
2025-09-01 added auxialry - swd connector and NRST pin circuit
    [LCD - Backlight.kicad_sch, LCD.kicad_sch, MCU - FLASH.kicad_sch, MCU - IO.kicad_sch, MCU - Memory.kicad_sch, MCU - SD Card.kicad_sch, Power - Generation.kicad_sch, auxiliary.kicad_sch]
2025-09-01 added 6.8pf 0402 capacitor
2025-09-01 added schematic for crystal oscillators
    [LCD - Backlight.kicad_sch, MCU - FLASH.kicad_sch, MCU - IO.kicad_sch, MCU - Memory.kicad_sch, MCU - SD Card.kicad_sch, Power - Generation.kicad_sch, auxiliary.kicad_sch]
2025-09-03 added signals from all sheets to mcu-io
    [LCD - Backlight.kicad_sch, MCU - FLASH.kicad_sch, MCU - IO.kicad_sch, MCU - Memory.kicad_sch, MCU - SD Card.kicad_sch, Power - Generation.kicad_sch, auxiliary.kicad_sch]
2025-09-03 added gpio expander, uc pinout, unused gpio connector, i2c pullup, delete unused files
    [LCD - Backlight.kicad_sch, MCU - FLASH.kicad_sch, MCU - IO.kicad_sch, MCU - Memory.kicad_sch, MCU - SD Card.kicad_sch, Power - Generation.kicad_sch, auxiliary.kicad_sch]
2025-09-10 added 2pin 2.54 male header and connect boot0, pdr_on signals
    [LCD - Backlight.kicad_sch, MCU - FLASH.kicad_sch, MCU - IO.kicad_sch, MCU - Memory.kicad_sch, MCU - SD Card.kicad_sch, Power - Generation.kicad_sch, auxiliary.kicad_sch]
2025-09-10 added power jumper to bypass charger
    [Power - Charging .kicad_sch]
2025-09-10 added jumper to connect vbat directly to vsys
    [Power - Charging .kicad_sch]
2025-09-10 update project structure and import to pcb
    [LCD - Backlight.kicad_sch, MCU - FLASH.kicad_sch, MCU - Memory.kicad_sch, MCU - SD Card.kicad_sch, Power - Generation.kicad_sch, Project Architecture.kicad_sch, auxiliary.kicad_sch, transmitter.kicad_pcb]
2025-09-10 change 32.768kHz footrpint
    [auxiliary.kicad_sch, transmitter.kicad_pcb]
2025-09-11 example new layout
    [transmitter.kicad_pcb]
2025-09-11 change to 6layer
    [transmitter.kicad_pcb]
2025-09-22 added some small changes on schematics - added some decoupling caps and test production files
    [LCD - Backlight.kicad_sch, MCU - FLASH.kicad_sch, MCU - Memory.kicad_sch, MCU - Power.kicad_sch, MCU - SD Card.kicad_sch, Power - Generation.kicad_sch, bom.csv, designators.csv]
2025-09-22 very very prototype layout + routing sdram
    [transmitter.kicad_pcb]
2025-09-24 slightly new layout and sdram routing
    [LCD - Backlight.kicad_sch, MCU - FLASH.kicad_sch, MCU - Memory.kicad_sch, MCU - SD Card.kicad_sch, Power - Generation.kicad_sch, transmitter.kicad_pcb]
2025-09-27 wstepny layout i routing wokol procka i sdram, do zrobienia length tuning ramu
    - procek / decoupling
    - rcc 32khz 25mhz
    - sdram
    [transmitter.kicad_pcb]
2025-09-27 change stackup dimensions
    according to https://jlcpcb.com/6-layer-pcb
    [transmitter.kicad_pcb]
2025-09-27 trace length matching sdram, almost done 80%
    [transmitter.kicad_pcb]
2025-09-27 sdram routed and length matching done
    [transmitter.kicad_pcb]
2025-09-27 starting layout of lcd connector
    [transmitter.kicad_pcb]
2025-09-28 duzo zmian, layout przetwornic i zasilania, wstepny routing sd card impedance control, usb differential impedance control
    [LCD - Backlight.kicad_sch, MCU - FLASH.kicad_sch, MCU - IO.kicad_sch, MCU - Memory.kicad_sch, MCU - SD Card.kicad_sch, Power - Charging .kicad_sch, Power - Generation.kicad_sch, Power and USB.kicad_sch]
2025-09-30 routed spi and signals to nrf24 rf module
    [transmitter.kicad_pcb]
2025-09-30 mala zmiana niektorych polaczen i layoutu, podlaczenie usb, rozpoczecie routowania sekcji zasilania - charger ic
    [transmitter.kicad_pcb]
2025-10-02 routing ladowania i obwodu przełączajacego zasilanie + vbus na in3
    [transmitter.kicad_pcb]
2025-10-02 routing zasilania caly czas + polygony masy, lekkie zmienienie layoutu - chyba dążenie do zmniejszenia wymiarow plytki - moze 100x100mm?
    [LCD - Backlight.kicad_sch, MCU - FLASH.kicad_sch, MCU - Memory.kicad_sch, MCU - SD Card.kicad_sch, Power - Charging .kicad_sch, Power - Generation.kicad_sch, transmitter.kicad_pcb]
2025-10-08 routing zasilaczy + layout przetwornicy backlight, zmiana gniazd lcd connector - obrocenie top/bottom contacts, zmniejszenie gabarytow plytki - 100 height, przygotowanie pod 100width - max 100x100
    [LCD - Backlight.kicad_sch, LCD.kicad_sch, MCU - FLASH.kicad_sch, MCU - Memory.kicad_sch, MCU - SD Card.kicad_sch, Power - Generation.kicad_sch, transmitter.kicad_pcb]
2025-10-09 update footprints, 3d models and layout
    [LCD - Backlight.kicad_sch, LCD.kicad_sch, MCU - FLASH.kicad_sch, MCU - Memory.kicad_sch, MCU - SD Card.kicad_sch, Power - Generation.kicad_sch, transmitter.kicad_pcb]
2025-10-09 routing backlight converter
    [transmitter.kicad_pcb]
2025-10-09 backlight converter routed
    [transmitter.kicad_pcb]
2025-10-09 lcd connector routing
    [transmitter.kicad_pcb]
2025-10-10 all lcd signals routed - consider length matching?
    [transmitter.kicad_pcb]
2025-10-11 layout power + lcd connectors before lengthmatching again
    [transmitter.kicad_pcb]
2025-10-11 finish layout power section
2025-10-11 lcd connector length matching done 65.5mm
2025-10-12 qspi layout, length matching, sdcard lengthmatching, change some footprints, prototype production generation
    [LCD - Backlight.kicad_sch, LCD.kicad_sch, MCU - FLASH.kicad_sch, MCU - Memory.kicad_sch, MCU - SD Card.kicad_sch, Power - Generation.kicad_sch, Project Architecture.kicad_sch, auxiliary.kicad_sch]
2025-10-13 change buttons footprints to 2pin 2.0mm connectors
    [Buttons.kicad_sch, LCD - Backlight.kicad_sch, MCU - FLASH.kicad_sch, MCU - Memory.kicad_sch, MCU - SD Card.kicad_sch, Power - Generation.kicad_sch]
2025-10-13 added tvs diodes to protect inputs + final component placement
    [Buttons.kicad_sch, LCD - Backlight.kicad_sch, MCU - FLASH.kicad_sch, MCU - Memory.kicad_sch, MCU - SD Card.kicad_sch, Power - Generation.kicad_sch, Rotary encoders.kicad_sch, Toggle switches.kicad_sch]
2025-10-14 buttons, connector inputs layout and routing
    [transmitter.kicad_pcb]
2025-10-17 clean schematics, started adding testpoints, remove designators, add some silkscreen top, added teardrops, round corners usb diff pair
    [LCD - Backlight.kicad_sch, MCU - FLASH.kicad_sch, MCU - IO.kicad_sch, MCU - Memory.kicad_sch, MCU - SD Card.kicad_sch, Power - Generation.kicad_sch]
2025-10-20 upgrade mcu schematic started adding testpoints
    [LCD - Backlight.kicad_sch, MCU - FLASH.kicad_sch, MCU - IO.kicad_sch, MCU - Memory.kicad_sch, MCU - SD Card.kicad_sch, Power - Generation.kicad_sch]
2025-10-22 added gas guage IC for monitoring battery
    [Battery.kicad_sch, LCD - Backlight.kicad_sch, MCU - FLASH.kicad_sch, MCU - IO.kicad_sch, MCU - Memory.kicad_sch, MCU - SD Card.kicad_sch, Power - Generation.kicad_sch, Project Architecture.kicad_sch]
2025-10-22 added into pcb , layout and routing
2025-10-23 change the rf trasceiver and improve grounding near vias close to lcd connector
    [LCD - Backlight.kicad_sch, MCU - FLASH.kicad_sch, MCU - Memory.kicad_sch, MCU - SD Card.kicad_sch, Power - Generation.kicad_sch, Transmitter - 2.4GHz.kicad_sch]
2025-10-24 added fiducal markers, mounting holes, testpoints
    [Battery.kicad_sch, Joysticks.kicad_sch, LCD - Backlight.kicad_sch, LCD.kicad_sch, MCU - FLASH.kicad_sch, MCU - IO.kicad_sch, MCU - Memory.kicad_sch, MCU - Power.kicad_sch]
2025-10-25 some visual changes, color of nets etc
    [LCD - Backlight.kicad_sch, MCU - FLASH.kicad_sch, MCU - IO.kicad_sch, MCU - Memory.kicad_sch, MCU - Power.kicad_sch, MCU - SD Card.kicad_sch, Power - Generation.kicad_sch]
2025-10-25 test points, colors, drc
    [Battery.kicad_sch, Joysticks.kicad_sch, LCD - Backlight.kicad_sch, LCD.kicad_sch, MCU - FLASH.kicad_sch, MCU - IO.kicad_sch, MCU - Memory.kicad_sch, MCU - Power.kicad_sch]
2025-10-26 fixing drc, generation production files test
    [Battery.kicad_sch, LCD - Backlight.kicad_sch, MCU - FLASH.kicad_sch, MCU - Memory.kicad_sch, MCU - SD Card.kicad_sch, Power - Generation.kicad_sch, Power and USB.kicad_sch, bom.csv]
2025-10-26 designator chagnes and cleanup silkscreen
    [Battery.kicad_sch, Buttons.kicad_sch, Joysticks.kicad_sch, LCD - Backlight.kicad_sch, LCD.kicad_sch, MCU - FLASH.kicad_sch, MCU - IO.kicad_sch, MCU - Memory.kicad_sch]
